Marksman124/inverjet/inverjet_app/readme.txt

config：

Run #1：

fromelf --bin --output=.\output\inverjet_app.bin .\output\inverjet_app.axf

Run #2：
.\after_build_script.bat "$J\..\bin" "#L" "$L@L.bin"

script：

Run #1：
fromelf --bin --output=.\output\inverjet_app.bin .\output\inverjet_app.axf

Run #2：
..\Tools\after_build_script.exe
