Marksman124/inverjet/芯片选型/readme.txt

1系列

STM32L151RCT6  ： 12~13 元

4系列

STM32L451RCT6：	51

STM32L431RCT6：	7~8 		不建议
