Marksman124/inverjet/芯片选型/芯片比较.docx

芯片 | 运行 | 待机 waitup | 睡眠
L151RCT6 | 14 mA | 1.15 uA | 1 mA
F103RCT6 | 31 mA | 43 uA | A

电源箱预留标准蓝牙接口

规格书 保护值，参数。。。
