Marksman124/inverjet/inverjet_boot/readme.txt

config：

Run #1：

fromelf --bin --output=.\Output\inverjet_boot.bin .\inverjet_boot\inverjet_boot.axf

Run #2：
fromelf --bin --output=..\..\inverjet_app\Bin\inverjet_boot.bin .\inverjet_boot\inverjet_boot.axf
