Marksman124/inverjet/tools/蓝牙模块/readme.txt

config：

Run #1：

fromelf --bin --output=.\iUpstream_app\iUpstream_app.bin .\iUpstream_app\iUpstream_app.axf

Run #2：
.\after_build_script.bat "$J\..\bin" "#L" "$L@L.bin"
