Marksman124/inverjet/inverjet_app/Core/fyld_mcu_sdk/VERSION.md

**-----------------------------------Revised Version---------------------------------------
此文件用户无需关心（Users of this file do not need to care）

** 版  本: v1.0.0
** 日　期: 2022年12月1日
** 修改人员: 叶炳文
** 协议版本: v1.0.0
** 描　  述: 初版

**
**-----------------------------------------------------------------------------
******************************************************************************/
