Marksman124/inverjet/规格书/新逆流器规格书_v1.1_20240620.docx

逆流器软件规格书

V1.1版本

# 产品名称：逆流游泳训练器

# 产品型号：

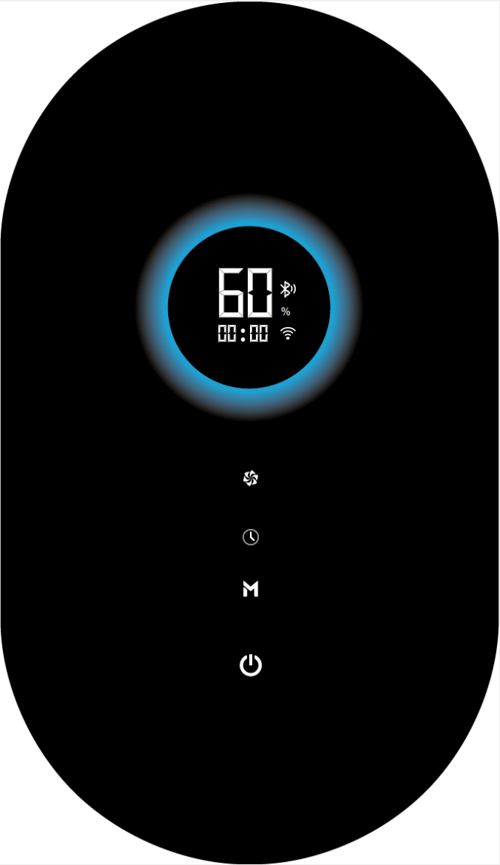
[picture p84: figure]

## 修订记录

版本 | 修改日期 | 修改人 | 修改原因
V1.0 | 2024-05-27 | 吴庆光 | 编制规格书
V1.1 | 2024-06-18 | 吴庆光 | 1.增加故障检测及代码 2.界面添加蓝牙图标
V1.1 | 2024-07-10 | 吴庆光 | 1.故障检测项目调整

目录

# 1 产品描述

泳池逆流训练器软件是一款专为用户提供泳池逆流训练辅助的实用工具。通过该软件，用户可以更加方便地进行泳池逆流训练，提升身体素质和游泳技能。产品特色：

1 本产品提供自由模式，定时模式满足大部分用户日常使用需求，还有3种训练模式针对专业性强的用户定制个人训练计划。
2 功能界面简洁，操作简单，日常使用场景基本可一键完成启动完；
3 配合远程遥控器能满足更多使用场景，用户一个人也可在游泳的途中进行操作，无需特意走到设备面前。

## 1.1 适用环境

环境温度： -10℃~42℃

运行水温: 5℃~40℃

湿度：(45~90)% RH，无结露

海拔：不超过1000m

室内或室外使用，壁挂式安装，出厂时配置壁挂螺丝与必要安装配件。

## 1.2 外形及重量

## 1.3 技术规格

### 1.3.1 规格

电源：单相输入，额定 220V~240V，允许电压 176V~264V，50Hz ±5%；

逆流器：额定功率 1.5kW，

调速范围：20%~100%, 对应转速为400rpm~2100rpm

对应流速： 400rpm→约1m/s, 2100rpm→约4.5m/s

### 1.3.2 输入输出端子

外部通讯控制，端口为A、B。外部控制通过连接A、B通讯线，经Modbus485通讯协议控制水泵转速

### 1.3.3 保护

具有常见保护功能，避雷，防浪涌。

### 1.3.4 报警

具有常见报警屏显功能，如电压异常、过流、过热、输出电流不平衡等。

### 1.3.5 高温降速

高温预警状态：当模块温度达到高温预警触发阀值（80摄氏度）时，进入高温预警状态；进入高温预警状态后自动降低输出转速，以维持电源箱内部温度在80度左右，温度越高降低比例越大，当温度达到高温警报触发阈值（100度）时将关闭电机，在温度降至低于高温预警触发阀值（80摄氏度）时，高温预警状态解除。

### 1.3.6 产品认证

CE认证（LVD+EMC）

# 2 产品展示

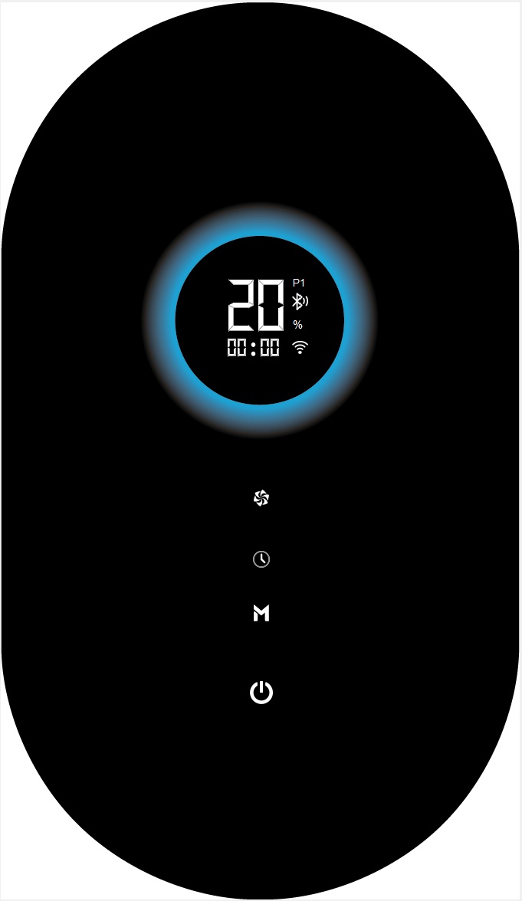
[picture p85: figure]

## 2.1 模式说明

模式类型 | 模式类型说明
自由模式 | 自由调节泳速强度，得到不同的水流速度，可在不定时间内固定流速畅游
定时模式 | 自由调节游泳时间与泳速强度，可在预设目标时间内畅游
预设训练模式 | 根据训练计划在不同时间运行指定流速,达到训练效果

## 2.2 控制及显示参数

设置/显示区 | 参数项 | | 描述
| 泳速强度 | 设定范围 | 20%~100%,五档:20,40,60,80,100
| | 显示精度 | 1%
| | 修改步长 | 20%
| 定时模式:游泳时间 | 设定范围 | 默认30min,六档:15~90min
| | 显示精度 | 00：01
| | 修改步长 | 每档15分钟
| 预设训练计划 | 显示范围 | P1~P3()
| Wifi图标 | | 无配置网络: 熄灭 开始配网:缓慢闪烁（2.5s亮，2.5s灭） 成功联网: 常亮 联网失败: 快速闪烁（1s亮，1s灭）
| 蓝牙图标 | | 无配对蓝牙: 熄灭 开始配对:缓慢闪烁（2.5s亮，2.5s灭） 配对成功: 常亮 配对失败: 快速闪烁（1s亮，1s灭）

## 2.3 按键功能

名称 | 用途 | 描述
开/关机键 | 1、开机 | 开机：关机时短按开关键开机，默认进入自由模式初始状态，若此前使用过则使用记忆流速强度，电机在1分钟内软启动完成
| 2、关机 | 长按3秒进入关机状态，保存记忆泳速并熄灭屏幕。
| 3、暂停 | 运行时短按进入暂停状态，泳速降至0%，并可切换模式。暂停状态下若无操作30分钟，自动关机。
| 4、恢复 | 暂停状态下短按重新恢复暂停前状态，30秒内软启动。
训练模式键 | 1、切换模式 | 点击模式键切换至训练模式参数选择状态，电机降至20%。可选择P1,P2,P3或自由模式（自由模式不显示模式P）。切换后3秒无操作进入软启动。
定时键 | 1、切换模式 | 切换模式：点击定时模式键切换至定时模式，电机降至20%。默认显示30:00 60%。
| 2、调整参数 | 调整时间：短按定时键修改时间，每次递增一个档，一档15min。一共有六档：15min，30min，45min，60min，75min , 90min。
流速档位键 | 1、调整流速（自由，时间模式运行时） | 在自由模式或定时模式下，短按流速档位键增加流速，速度在3秒后直接增加到最后一次点击的档位。每次短按增加20%（60%，80%，100%，20%，40%）
| 2、调整流速（预设训练模式运行时） | 训练模式：在训练模式运行状态下，可在当前分钟内调整流速，流速在3秒后实时增加到点击的档位。
| 3、调整流速（自由模式、定时模式设置时调整速度） | 流速档位键可以在定时模式设置和自由模式初始状态设置时调整速度

## 2.4 操作流程

### 2.4.1 开机 & 关机

1) 开机：上电完成后，点击开机键开机，开机后系统默认进入自由模式初始状态： 流速60%；

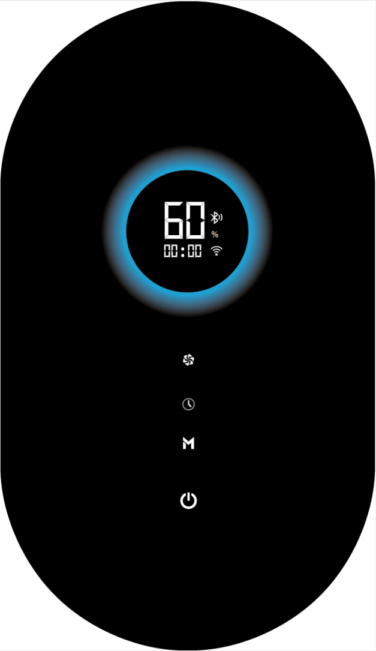
[picture p86: figure]

2) 关机：
1 任意模式下长按开机键 3秒系统进入关机状态，关机状态下仅开机键可操作，其它按键均无效；
2 暂停状态下连续30分钟内无操作，系统将自动关机；

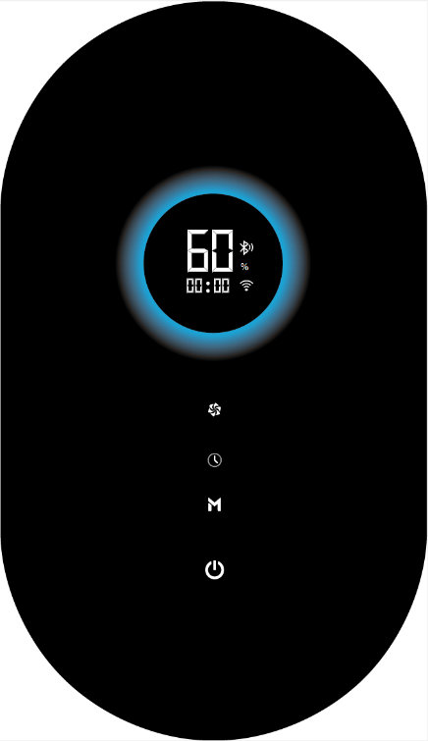
[picture p87: figure]

### 2.4.2 暂停 & 恢复

1) 暂停：系统在运行状态或设置状态下，短按开机键进入暂停状态，暂停状态下流速降至0%，时间暂停，LED状态灯以5秒一个周期完成闪烁；暂停状态下30分钟内无操作，系统将自动关机。


LED灯闪烁

电机停止

2) 恢复：暂停状态下短按开机键恢复暂停前状态继续运行，如果在暂停时切换模式，会导致运行状态重置，那此时恢复后系统将重新开始运行。暂停时无法更改流速。


暂停时点击定时键

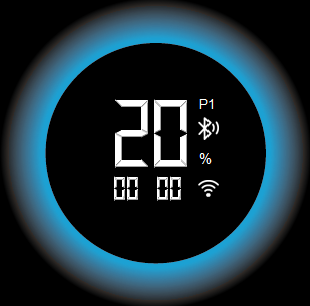
[picture p88: figure]

暂停时点击训练模式键

注意：进行模式切换后，暂停前运行状态将被重置。

### 2.4.3 运行自由模式

开机后默认进入自由模式初始状态，默认流速60%；3秒内无操作系统自动运行自由模式，或者短按开机键立即运行；流速下方显示已运行时间：

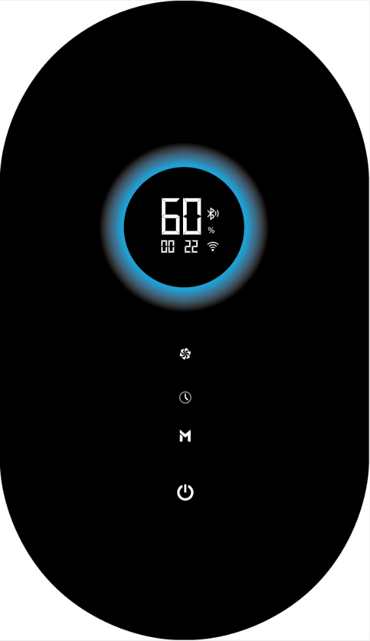
[picture p89: figure]

### 2.4.4 更改自由模式流速

在自由模式初始状态或者运行状态下，点击流速档位键即可更改流速，每次点击切换一档，共有五个档位：20%、40%、60%、80%、100%依次切换；

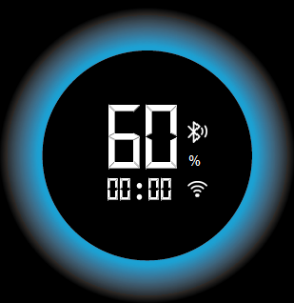
[picture p90: figure]
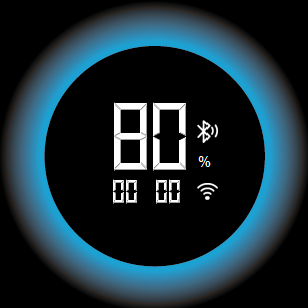
[picture p91: figure]
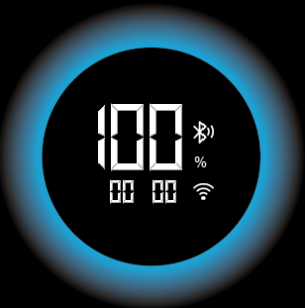
[picture p92: figure]
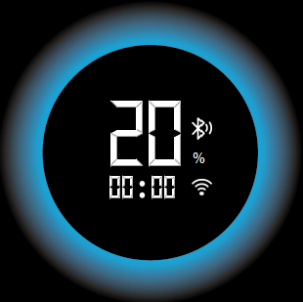
[picture p93: figure]
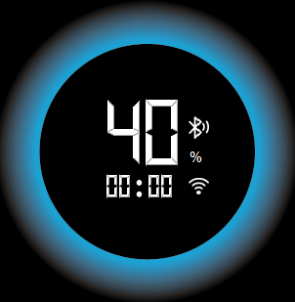
[picture p94: figure]

选择完成后等待3秒无操作后，流速将调整至最后设置的档位流速。

### 2.4.5 运行定时模式

在任意状态下点击定时键，系统进入定时模式设置状态，在该状态下3秒内无操作将开启定时模式，或者点击开机键立即运行；流速下方显示定时时间，开始运行后进入倒数，当数到0时定时运行结束，运行结束后将闪烁显示定时模式的运行时间和流速，3秒后系统切换到自由模式初始状态，想再次运行定时模式需重复2.4.4操作：


定时模式设置状态 运行中。。 运行结束

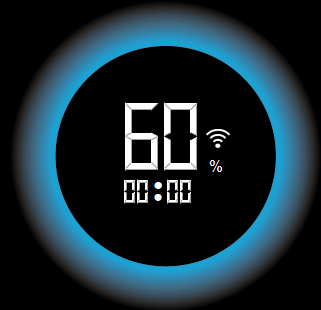
[picture p95: figure]

3秒

结束后显示运行流速和时间 闪烁显示 3秒后切换到自由模式初始状态

### 2.4.6 定时模式下更改流速

在定时模式下（运行中或者未运行均可直接修改流速），点击流速档位键即可更改流速，每次点击切换一档，共有五个档位：20%、40%、60%、80%、100%依次切换；该修改仅本次有效，运行结束后流速将恢复60%（即下次开启定时模式默认流速依然是60%），如需修改请按2.4.5再次操作；

未运行：


运行中：更改流速过程中系统将持续运行，设置好目标流速后保持3秒内无操作，系统将以最后设定的流速运行，期间计时器不会暂停；


### 2.4.7 更改定时时间

更改定时时间需要在定时模式设状态下才能设定，具体操作如下：

1 非定时模式设置状态时（定时模式运行状态或其它模式），点击定时键可切换至定时模式设置状态；
2 在定时模式设置状态下，点击定时键即可更改时间，每次点击切换一档，共有五个档位：15min、30min、45min、60min、90min依次切换；设置好目标时间后保持3秒内无操作，系统将以最后设定的时间重新开始定时模式；


### 2.4.8 切换训练模式

系统存有3种训练模式（P1,P2,P3），训练模式实际上是多段定时连在一起，通过不同的流速配置指定更专业的训练计划，具体可分为12个段速，具体段速的参数需要在app中进行设置，默认为

P1:

时间 | 0-2min | 2-4min | 4-6min | 6-8min | 8-10min | 10-12min | 12-14min
流速 | 20% | 40% | 60% | 80% | 60% | 40% | 60%

P2:

时间 | 0-2min | 2-4min | 4-6min | 6-8min | 8-10min | 10-12min | 12-14min
流速 | 20% | 40% | 60% | 80% | 60% | 40% | 60%

P3：

时间 | 0-2min | 2-4min | 4-6min | 6-8min | 8-10min | 10-12min | 12-14min
流速 | 20% | 40% | 60% | 80% | 60% | 40% | 60%

在面板和遥控器可进行训练模式切换，具体操作如下：在任意模式下点击训练模式键即可切换训练模式，每次点击切换一种模式，共有四个模式：P1,P2,P3，自由模式 依次切换（当切到自由模式时界面“Pn”模式图标熄灭）；切换到目标模式后保持3秒内无操作，系统将开启该模式运行；

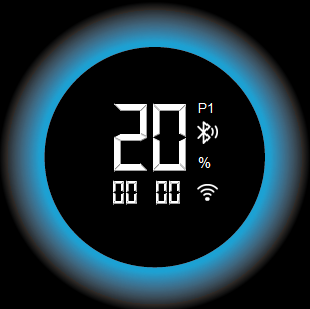
[picture p96: figure]
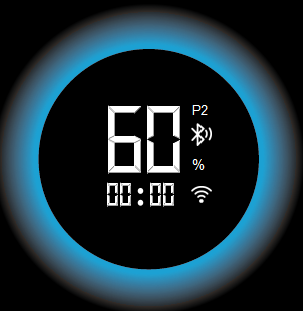
[picture p97: figure]
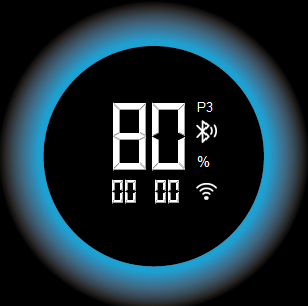
[picture p98: figure]

### 2.4.9 训练模式下更改流速

训练模式下更改流速与其它模式下操作相同，可查看2.4.5操作流程：

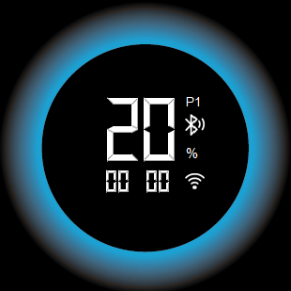
[picture p99: figure]
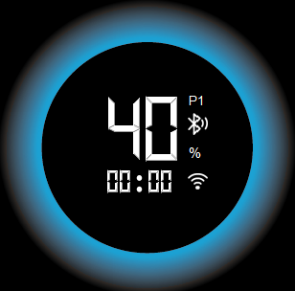
[picture p100: figure]
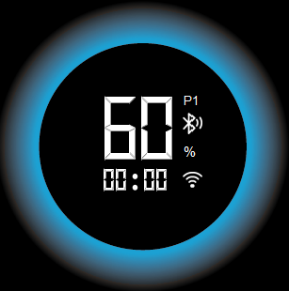
[picture p101: figure]
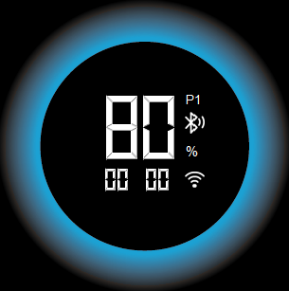
[picture p102: figure]
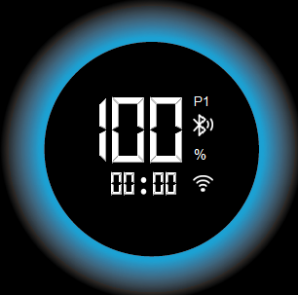
[picture p103: figure]

在训练模式开启运行后也可更改流速，更改流速过程中系统将持续运行，设置好目标流速后保持3秒内无操作，系统将以最后设定的流速运行当前时间段，期间计时器不会暂停；当训练时间进入下一时间段时将使用默认流速（即更改流速仅当前段速有效）：

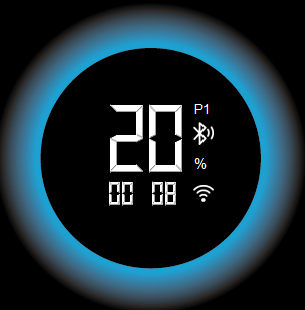
[picture p104: figure]
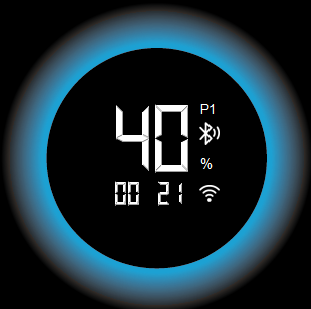
[picture p105: figure]
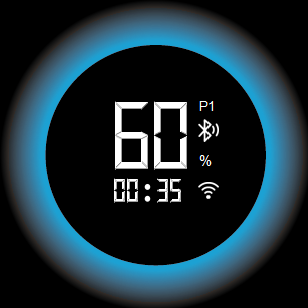
[picture p106: figure]
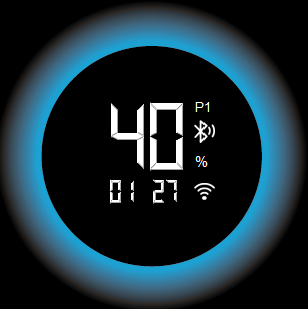
[picture p107: figure]

下一阶段恢复计划流速

流速调至60%

### 2.4.10 Wifi联网和蓝牙遥控器配对

  1 Wifi联网：停机状态下（系统开机 & 电机未开启）同时按 键并保持3秒，进入Wifi配网模式，此时图标开始缓慢闪烁（5秒一个闪烁周期），通过手机app进行配网操作（详情查看app操作说明），配网成功后图标常亮，如3分钟内没有完成配网，则熄灭需重新操作进入配网模式；

完成配网后，下次开机会自动连接网络，连接成功则常亮，若连接失败或连接上却无法上网则进入故障状态开始快速闪烁（2秒一个闪烁周期）。出现故障状态请排查网络或根据app操作说明进行排查，如果原wifi热点失效可重新进行配网操作；

  2 蓝牙遥控器配对：停机状态下（系统开机 & 电机未开启）同时按 键并保持3秒，进入Wifi配网模式，此时图标开始缓慢闪烁（5秒一个闪烁周期），通过逆流器专门的遥控器进行配网操作（详情查看遥控器操作说明），配对成功后图标常亮，如3分钟内没有完成配对，则熄灭需重新操作进入配对模式；

完成蓝牙配对后，下次开机会自动连接蓝牙遥控器，连接成功则常亮，若连接失败则进入故障状态开始快速闪烁（2秒一个闪烁周期）。出现故障状态请检查遥控器是否故障，如果原遥控器损坏可重复上述操作重新配对新遥控器；

### 2.4.11 其它操作说明

1 关机状态下，同时按 键并保持3秒恢复出厂设置。
2 关机状态下，同时按 键并保持3秒，进入参数设置菜单。每次均从第1项开始显示，按键切换设置项目；1分钟无操作或按键退出参数设置；

具体可设项目请看下方表格；通过 跳转进行参数设置，按参数值+1，长按超过1秒可快速连续增加，按参数值-1，长按超过1秒可快速连续减少；

在位置显示代码值：1、2、3…

在位置显示设置值。

参数 | 默认值 | 代码 | 设置范围

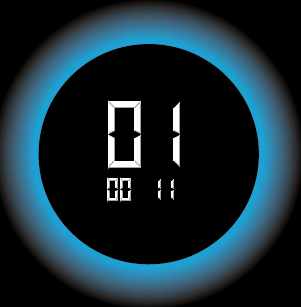
[picture p108: figure]

节点地址 | 11 | 1 | 1~254 | 长按可快速调节

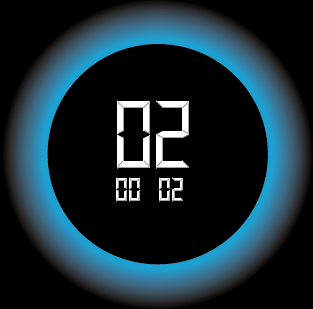
[picture p109: figure]

波特率 | 2 | 2 | 0:2400; 1:4800; 2:9600; 3:19200; 4:115200

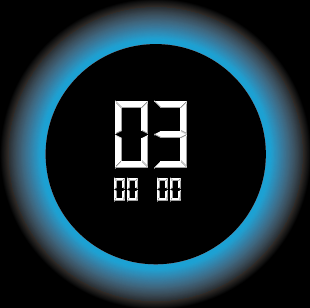
[picture p110: figure]

屏蔽外部控制方式 | 0 | 3 | 0：全可控 1：遥控器无效 2：485无效 3：遥控与485无效 4：wifi无效 5：遥控与wifi无效 6：485与wifi无效 7：遥控，485，wifi无效

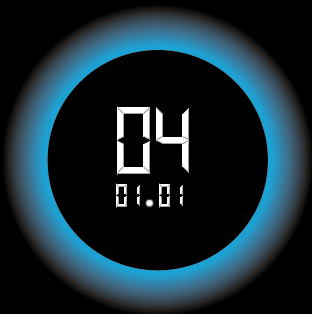
[picture p111: figure]

显示板软件版本 | 不可修改 | 4 | 版本号 V xx.xx 如 v 1.1显示如图


驱动板软件版本 | 不可修改 | 5 | 版本号 V xx.xx 如 v 1.0显示如图

3 运行状态时，液晶屏幕如无按键操作1分钟后亮度降至正常显示的1/2，任意按键均唤醒屏幕。此情况下，即使按电源开关按键，亦默认为唤醒屏幕而非关机。

# 3 故障检测及代码

逆流器检测到故障时（降速策略除外），停机并显示故障代码。停机15秒后，判断故障是否清除，如果满足，则恢复启动。出现多个故障时用户可按通过 键切换故障查看；同时按住 键3秒进行复位。

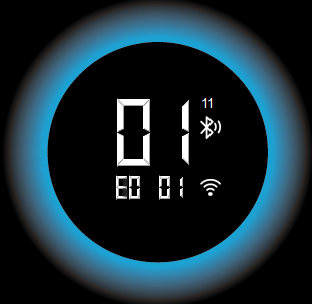
[picture p112: figure]

为故障总数, 为当前故障编号, 为故障代码。

1) 输出电流超过限值

进入条件：逆流器电流峰值大于预设电流。

退出条件：停机15秒后启动，如连续出现3次，则需断电重启。

2) 输出电压不平衡

进入条件：逆流器输出三相电流出现漏项，错项，缺项等。

退出条件：停机15秒后启动，如连续出现3次，则需断电重启。

3) 电源箱过热

进入条件：电源箱内部温度大于预设温度值。

退出条件：停机15秒后启动，如连续出现3次，则需断电重启。

4) 电机故障

进入条件：驱动板损坏或电机控制异常。

退出条件：排查故障后，需断电重启。

5) 驱动EEPROM读写故障

进入条件：读写驱动EEPROM数据校验错误。

退出条件：需断电重启。

6) 驱动板通信故障

进入条件：驱动板与主控制连续15sec通信不上。

退出条件：驱动板与主控制连续1秒通讯成功。

7) WIF模组故障

进入条件：WIFI模组损坏。

退出条件：需断电重启。

8) 蓝牙模组故障

进入条件：蓝牙模组损坏。

退出条件：需断电重启

故障码代号如下：

序号 | 故障代码 | 故障描述 | 是否为自身故障 | 是否可自动恢复 | 界面演示
1 | E001 | 输出电流超过限值 | 否 | 1小时内连续报超过3次将锁住，需要手动复位。

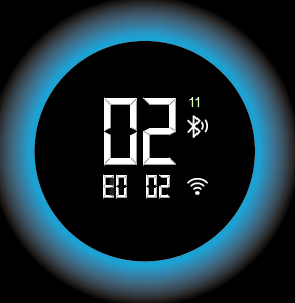
[picture p113: figure]

2 | E002 | 输出电压不平衡 | 可能 | 3次后不可以。需要断电重启

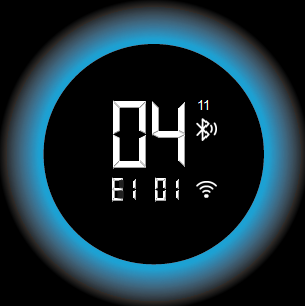
[picture p114: figure]

3 | E101 | 电源箱过热 | 可能 | 3次后不可以。需要断电重启

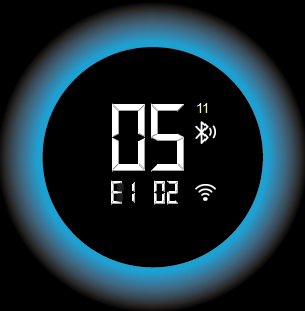
[picture p115: figure]

4 | E102 | 电机故障 | 可能 | 3次后不可以。需要断电重启

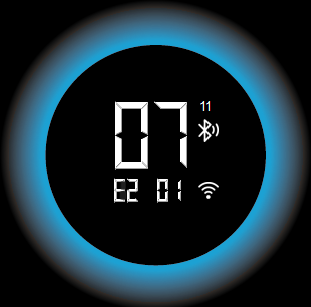
[picture p116: figure]

5 | E201 | 驱动板通信故障 | 是 | 否

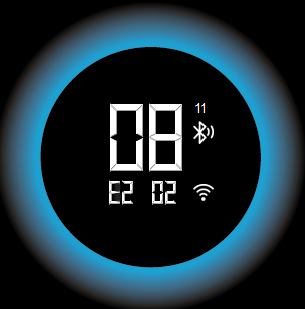
[picture p117: figure]

6 | E202 | 驱动板通信故障 | 是 | 否

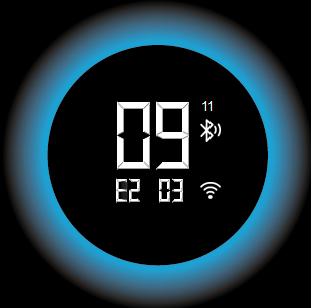
[picture p118: figure]

7 | E203 | wifi故障 | 是 | 否

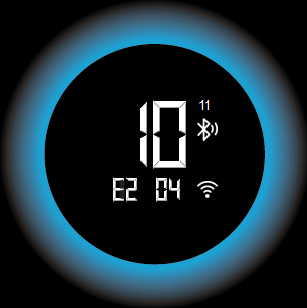
[picture p119: figure]

8 | E204 | 蓝牙遥控故障 | 是 | 否
12 | AL01 | 高温预警降档运行 | 可能 | 是
