Marksman124/inverjet/计划书/电源箱详细逻辑20240516V1.1(1).pdf

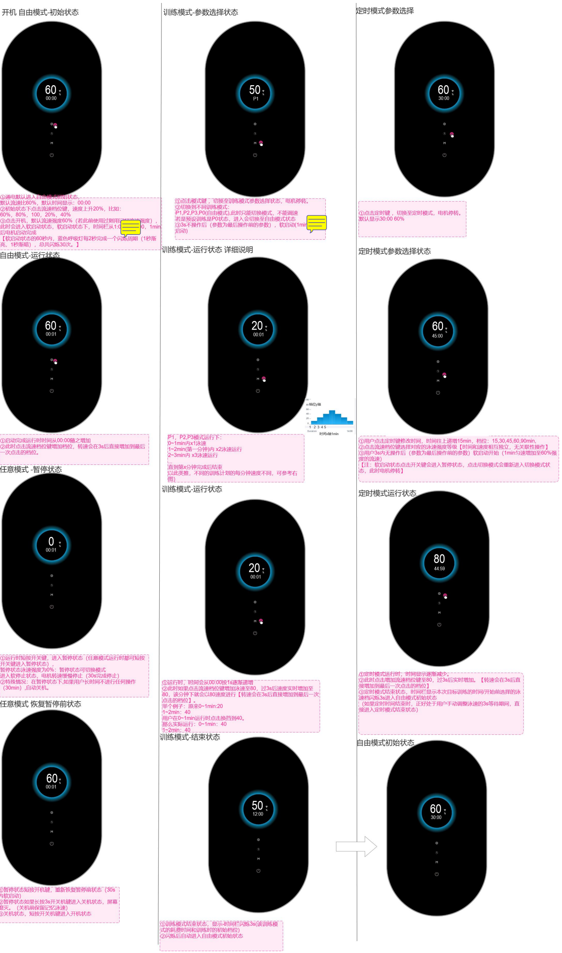
[picture p214: page 1]

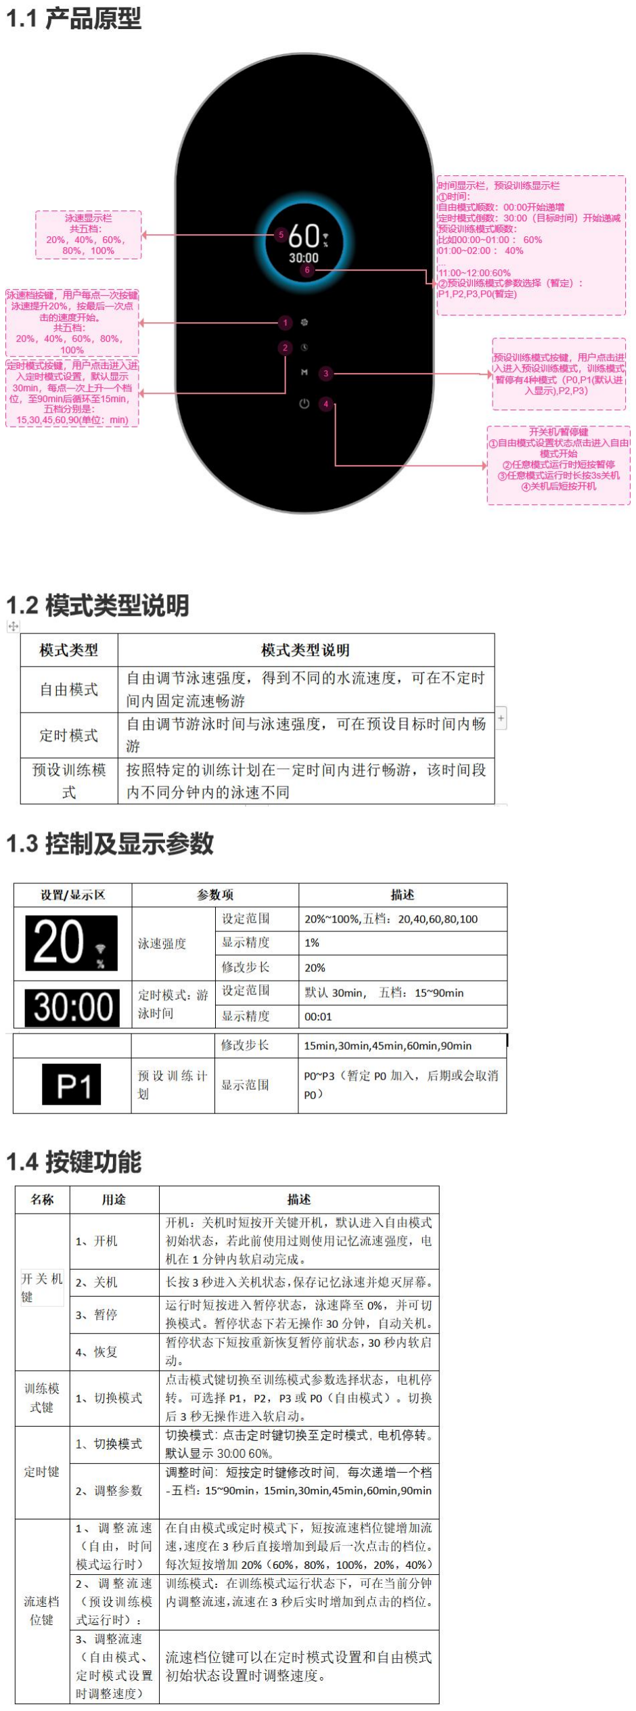
[picture p215: figure]
