Marksman124/inverjet/协议/逆流器软件功能测试报告V1.6.xlsx

Sheet: 测试问题
逆流器控制板测试问题
序号 | 问题 | 时间 | 情况记录 | 恢复情况 | 原因 | 解决方案 | 备注
20 | Modbus-485通讯测试时，模式显示混乱 | 2022-06-14 | 开机后，通讯修改F0-02（1->0）、F0-03（->1/2）时，模式显示混乱 |  | 控制模式的信号源未统一（F0-03的值与F0-02冲突） |  | 已解决
33 | 恢复出厂设置 | 2022-12-07 | FF-06、FP-02 恢复出厂设置后的值与出厂值不一致 |  | FP-02无需改 |  | 已解决
34 | F7-11设为100时，参数无法确定 | 2022-12-30 | F7-11设为100时，点击ENTER键开机关机 且参数修改后按ENTER键确认 ，参数无法确定 | F7-11设为110后，恢复正常 | 点击ENTER键功能混乱，可以开关机就无法确认参数 |  | 已解决
35 | FP-00设为1后，输入密码无法确认，无法查看参数 | 2023-01-02 | FP-00设为1,F7-11设为0时，点击ENTER键，无法确认密码，无法查看或修改参数菜单 |  |  |  | 已解决
36 | 自定义模式与畅游模式显示混乱 | 2023-01-10 | 手动将F0-01的值由3（自定义模式）改为0（畅游模式）后，模式图标显示畅游，但仍显示自定义模式下的距离及级数 | 手动按下模式键，显示自定义模式图标，再按模式键改为畅游模式后，显示正常 | 参数已修改，需要刷新 |  | 已解决
37 | 外部接入图标不亮 | 2023-01-12 | 由面板控制改为通信控制后，外部接入图标不亮 | 掉电并重新上电后，外部接入图标亮起 | 参数已修改，需要刷新 |  | 已解决
38 | 掉电存储（掉电不记忆） | 2023-02-08 | 按键修改模式、转速、时间、距离后，掉电未记忆 | V2.06.2版本正常 |  |  | 已解决
39 | 蜂鸣器不断响 | 2023-02-08 |  | 松开按键后，按下确认键，蜂鸣器停止响
40 | 掉电后开机，485测试时模式显示混乱 | 2023-02-09 |  | 先停机，然后通信修改模式、时间或距离，再开机，显示正常
41 | 恢复出厂值后，未掉电保存，直接开机，模式显示混乱 | 2023-02-13 | （1）面板控制：距离模式，显示距离图标、0.50km； （2）恢复出厂值：通过按键将 FP-01 的值修改为 1， 显示距离图标、0.50km； （3）按键开机：显示畅游图标、0.01km | 掉电并重新上电后，正常显示畅游模式 | 恢复出厂值后，未掉电保存 | 恢复出厂值后，需掉电保存 | 此为操作失误，无需改

Sheet: 功能测试
 |  |  |  |  | 广州安捷制造有限公司
 |  |  |  |  | 软件功能测试报告书
 |  |  |  |  |  |  |  | 表单编号：
 |  |  |  |  |  |  |  | 生效日期：
项目编号 |  |  |  |  | 项目名称 | 逆流器 |  | 文件编号： | V1.6
软件编号 |  |  | V2.01 | V2.06.3 | 产品型号 |  |  | 日期： | 2023-02-14
控制方式 | No | 测试项 | 测试内容 |  | 判断方法 | 不符合现象 | 检讨意见 | 判定 | 措施事项
LCD显示 面板控制 | 1 | 上电检测 | 上电瞬间状态 |  | 1、接通电源后，4个按键指示灯常亮，伴随背光板亮起； |  |  | PASS
 |  |  |  |  | 2、设备就绪过程中，水流速度显示区：数字00跑马灯效果。 |  |  | PASS
 |  |  | 上电完成后状态 |  | 等待 7s（默认）设备就绪后，蜂鸣器长鸣一声，LCD显示用户模式： |  |  | PASS
 |  |  |  |  | 1. 初次上电，LCD显示的都是默认值； |  |  | PASS
 |  |  |  |  | 2. 上次断电前为正常工作状态，则LCD显示恢复至断电前的状态。 |  |  | PASS
 | 2 | LCD与按键 | LCD显示测试 |  | 设备就绪过程中，长按模式键 3s，蜂鸣器短鸣一声，LCD显示： | 2.3s | 未定，可忽略
 |  |  |  |  | 1、所有图标从上到下、从左到右逐一显示； |  |  | PASS
 |  |  |  |  | 2、所有七段式液晶同时按 0 - 9 的顺序依次更新显示； |  |  | PASS
 |  |  |  |  | 3、屏幕全亮，显示所有段码。 |  |  | PASS
 |  |  | 按键与LCD显示 |  | 4、LCD上最右边的七段式液晶显示：0 ； |  |  | PASS
 |  |  |  |  | 5、从右到左逐一点击按键，最右边的七段式液晶分别显示：1 - 4。 |  |  | PASS
 |  |  | 按键与蜂鸣器、指示灯 |  | 1. 点击一次按键，按键对应的指示灯亮，蜂鸣器发出 1声“滴”； |  |  | PASS
 |  |  |  |  | 2. 长按模式键或确认键 3s，按键对应的指示灯亮，蜂鸣器短鸣 1声； | 2.7s | 未定，可忽略
 |  |  |  |  | 3、长按模式键和确认键 5s，按键对应的指示灯亮，蜂鸣器长鸣 1声。 | 5.6s | 未定，可忽略
 | 3 | 锁屏与解锁 | 锁屏 |  | 亮屏时，无任何操作下，倒计时 30s（默认）后： |  |  | PASS
 |  |  |  |  | LCD自动锁屏，屏幕完全熄灭。 |  |  | PASS
 |  |  | 解锁 |  | 锁屏时，长按模式键 3s 解锁后： | 2.4s | 未定，可忽略
 |  |  |  |  | LCD屏幕亮起，默认显示锁屏前的状态。 |  |  | PASS
 | 4 | 切换控制模式 | 按键操作与LCD显示 |  | 1、亮屏时，长按模式键 3s，当前模式图标闪烁； | 2.5s | 未定，可忽略
 |  |  |  |  | 2、点击上键（或下键）及确认键，选择切换到其他模式； |  |  | PASS
 |  |  |  |  | 3、可切换的模式：畅游 - 定时 - 距离 - 自定义模式（含娱乐模式、普通自定义模式）。 |  |  | PASS
 | 5 | 修改转速 | 按键修改与LCD显示 |  | 1. 亮屏时，点击上键或下键，转速值的个位闪烁； |  |  | PASS
 |  |  |  |  | 2. 点击上键（或下键）及确认键，修改为其他转速； |  |  | PASS
 |  |  |  |  | 3. 转速可修改范围：20%（默认） - 100%。 |  |  | PASS
 | 6 | 掉电存储 | 按键修改与LCD显示 |  | 1、上电后，修改转速、模式、定时时间、运行距离； |  |  | PASS
 |  |  |  |  | 2、断电再上电后，LCD显示修改后的值。 |  |  | PASS
 | 7 | 开关机 | 开机 | 设置开机 | 上电等待设备就绪后，长按确认键 3s 开机，LCD显示： | 2s | 未定，可忽略
 |  |  |  |  | 开机图标被点亮，逆流器以当前模式运行。 |  |  | PASS
 |  |  |  | 开机动效 | 开机后，LCD显示： |  |  | PASS
 |  |  |  |  | 1. 转速值在 20s（默认）的时间内从 0% 逐步攀升至 100% ； |  |  | PASS
 |  |  |  |  | 2. 出水流速从 0.0m/s 匀速攀升，升至给定值（默认 5.0m/s）。 |  |  | PASS
 |  |  | 关机 | 设置关机 | 开机后，长按确认键 3s 关机，LCD显示： | 2.4s | 未定，可忽略
 |  |  |  |  | 开机图标熄灭，逆流器停止运行。 |  |  | PASS
 |  |  |  | 关机动效 | A、停机方式为减速停机时, 关机后： |  |  | PASS
 |  |  |  |  | 1. 转速从当前值匀速递减，开机图标熄灭后，显示设定值； |  |  | PASS
 |  |  |  |  | 2. 出水流速从当前值匀速递减，直到降为 0m/s。 |  |  | PASS
 |  |  |  |  | B、停机方式为自由停机时，关机后： |  |  | PASS
 |  |  |  |  | 1. LCD显示设定转速； |  |  | PASS
 |  |  |  |  | 2. 出水流速立即变为 0m/s。 |  |  | PASS
 | 8 | 复位 | 故障复位 |  | 出现故障后，长按确认键，蜂鸣器响2次复位： |  |  | PASS
 |  |  |  |  | LCD显示出故障前的状态。 |  |  | PASS
 | 9 | 畅游模式 | 转速显示 |  | 1、转速以百分比形式 xxx% 显示，设定值：下限值（默认20%）-100%； |  |  | PASS
 |  |  |  |  | 2、初始化后，转速恢复默认值 30%。 |  |  | PASS
 |  |  | 出水流速显示 |  | 3、出水流速以 x.xm/s 的形式显示； |  |  | PASS
 |  |  |  |  | 4、出水流速正比于转速（转速100% —— 出水流速5.0m/s）。 |  |  | PASS
 | 10 | 定时模式 | 修改定时时间 | 本区移位 | 定时模式下，停机时： |  |  | PASS
 |  |  |  |  | 1. 点按上键（或下键），转速个位闪烁； |  |  | PASS
 |  |  |  |  | 2. 点击确认键，时间个位闪烁； |  |  | PASS
 |  |  |  |  | 3. 点击上键（或下键）及确认键，修改为其他定时； |  |  | PASS
 |  |  |  |  | 4. 时间可调整范围：1 - 99min。 |  |  | PASS
 |  |  |  | 跨区移位 | 定时模式下，停机时： |  |  | PASS
 |  |  |  |  | 1、点按上键（或下键），转速个位闪烁； |  |  | PASS
 |  |  |  |  | 2、点击模式键 2次，时间个位闪烁； |  |  | PASS
 |  |  |  |  | 3、点击上键（或下键）及确认键，修改为其他定时； |  |  | PASS
 |  |  |  |  | 4、时间可调整范围：1 - 99min。 |  |  | PASS
 |  |  | 定时功能 |  | 定时模式下，开机后，秒表倒计的定时时间到达后： |  |  | PASS
 |  |  |  |  | 1. 开机图标熄灭，LCD显示设定转速、设定时间； |  |  | PASS
 |  |  |  |  | 2. 出水流速立即变为 0m/s。 |  |  | PASS
 | 11 | 距离模式 | 修改运行距离 | 本区移位 | 距离模式下，停机时： |  |  | PASS
 |  |  |  |  | 1、点按上键（或下键），转速个位闪烁； |  |  | PASS
 |  |  |  |  | 2、点击确认键，距离最低位闪烁； |  |  | PASS
 |  |  |  |  | 3、点击上键（或下键）及确认键，修改为其他距离； |  |  | PASS
 |  |  |  |  | 4、距离可调整范围：00.01 - 99.99km。 |  |  | PASS
 |  |  |  | 跨区移位 | 距离模式下，停机时： |  |  | PASS
 |  |  |  |  | 1. 点按上键（或下键），转速个位闪烁； |  |  | PASS
 |  |  |  |  | 2. 点击模式键 2次，距离最低位闪烁； |  |  | PASS
 |  |  |  |  | 3. 点击上键（或下键）及确认键，修改为其他距离； |  |  | PASS
 |  |  |  |  | 4. 距离可调整范围：00.01 - 99.99km。 |  |  | PASS
 |  |  | 距离功能 |  | 距离模式下，开机后，运行距离降为 00.00km 后： |  |  | PASS
 |  |  |  |  | 1、开机图标熄灭，LCD显示设定转速、设定距离； |  |  | PASS
 |  |  |  |  | 2、出水流速立即变为 0m/s。 |  |  | PASS
 | 12 | 自定义模式 | 选择模式 |  | 自定义模式图标闪烁时，点击上键和确认键，可以选择娱乐或普通自定义模式，共10个可选 |  |  | PASS
 |  |  | 娱乐模式 |  | 点击下键及确认键，可选择5段已设置好的转速、时间（需在APP上设置）来运行 | 开机后，定时时间到了未停机，一直循环运行 | 修改F0-19、F0-20的默认值
 |  |  | 普通自定义模式 |  | 点击下键及确认键，可选择5段已设置好的转速、距离（需在APP上设置）来运行 | 开机后，运行距离到了未停机，一直循环运行
 | 13 | 参数菜单 | 切换菜单 |  | 1、同时长按模式键和确认键 5s，进入参数菜单模式； | 5s | 未定，可忽略
 |  |  |  |  | 2、再次同时长按模式键和确认键 5s，返回用户菜单模式。 | 5s | 未定，可忽略
 |  |  | LCD显示 | 有密码 | 1. 进入参数菜单模式后，LCD显示： |  |  | PASS
 |  |  |  |  | 2. 点击模式键，LCD显示： |  |  | PASS
 |  |  |  | 无密码 | 无密码或成功输入密码后，LCD显示： |  |  | PASS
 |  |  | 查看参数 |  | 1、双击模式键，LCD显示参数组F0； |  |  | PASS
 |  |  |  |  | 2、单击确认键，进入该组参数，如F0-00； |  |  | PASS
 |  |  |  |  | 3、再次单击确认键，查看该组参数值； |  |  | PASS
 |  |  |  |  | 注：只读参数不可修改，只能查看。 |  |  | PASS
 |  |  | 修改参数 |  | 4、点击上键或下键，修改该参数； |  |  | PASS
 |  |  |  |  | 5、再点击确认键确定该参数。 |  |  | PASS
 |  |  |  |  | 注：（1）修改参数需要先将FP-04设为0； |  |  | PASS
 |  |  |  |  | （2）修改FF组参数需要先在FF-00中输入厂家密码。 |  |  | PASS
 |  |  | 参数初始化 |  | 将参数 FP-01 的值设置为1后，LCD显示： |  |  | PASS
 |  |  |  |  | 除 只读参数 与 FF组参数 外，其他参数都恢复了出厂值。 |  |  | PASS
 |  |  |  |  | 注：（1）只读参数的出厂值无效； （见附表参数初始化） |  |  | PASS
 |  |  |  |  | （2） FF组参数为固定参数，初始化后仍为修改值。 |  |  | PASS
 |  |  | 修改参数后掉电存储 |  | 修改参数后，断电再重新上电，参数显示为修改后的值。
 |  |  | 参数初始化后掉电存储 |  | 参数初始化后，断电再重新上电，参数恢复为出厂值。
 | 14 | UART通信 | 控制板与驱动板通信 |  | 1. 发送数据帧无异常； |  |  | PASS
 |  |  |  |  | 2. 接收数据帧无异常； |  |  | PASS
 |  |  |  |  | 3. LCD显示正常，未出现故障报错。 （见附表UART通信） |  |  | PASS
 | 15 | 故障功能 | 驱动故障 |  | 1、发送数据帧无异常； |  |  | PASS
 |  |  |  |  | 2、接收数据帧无异常； （见附表故障功能） |  |  | PASS
 |  |  |  |  | 注： 给出开机命令后LCD显示故障代号,此时电机迅速自由停机。 |  |  | PASS
 |  |  | 控制板与驱动板通信故障 |  | 1. 将lcd板与drive板之间的通讯时间间隔改为500，给出开机命令后LCD显示：
 |  |  |  |  | Err 201（LCD到drive通信故障 -- 通信超时 FB-00、FB-01 确定）；
 |  |  |  |  | 2. 控制板连接驱动板的RXD或TXD线路出现故障时，给出开机命令后LCD显示：
 |  |  |  |  | Err 102（上电电压为0 通信断线故障）
 |  |  |  |  | 注： 给出开机命令后LCD显示故障代号,此时电机迅速自由停机。
 | 16 | 联网 | 进入配网状态 |  | 同时长按模式键和上键 3s，WiFi图标闪烁，可在APP上联网： | <3s | 未定，可忽略 |  | WiFi功能待定义
 |  |  |  |  | 2min（默认）内若联网成功，WiFi图标常亮；否则，WiFi图标熄灭。 |  | 未定，可忽略 |  | WiFi功能待定义
控制方式切换 | 1 | 控制方式切换 | 面板与ModBus通信控制切换 |  | 面板控制且停机时，同时长按模式键与下键 3s，外部接入图标亮起，进入ModBus通信控制状态； | <3s
 |  |  |  |  | ModBus通信控制且停机时，同时长按模式键与下键 3s，外部接入图标熄灭，进入面板控制状态。 | <3s
Modbus 通信控制 | 1 | MODBUS 协议 | 通信数据 | 0x06命令 | 1、发送数据帧与接收数据帧一致； |  |  | PASS
 |  |  |  |  | 2、LCD显示出现变化，或某些参数被修改。 （见附表MODBUS测试） |  |  | PASS
 |  |  |  | 0x03命令 | 1. 发送数据帧与接收数据帧不一致， |  |  | PASS
 |  |  |  |  | 2. 读取到的数据都为设定值； |  |  | PASS
 |  |  |  |  | 3. LCD显示未出现任何变化。 （见附表MODBUS测试） |  |  | PASS
 |  |  |  |  | 注：（1）最大连续读32个，不能跨参数组连读 |  |  | PASS
 |  |  |  |  | （2）连读最大个数为参数组当前可显示的个数 |  |  | PASS
 |  |  |  |  | （3）FP-00、FF-00不能读 |  |  | PASS
 |  |  |  |  | （4）FF组需要发送解锁密码才可以读取 |  |  | PASS
 | 2 | 修改转速 | 通信修改与LCD显示 |  | 1、上电后，用串口调试助手给控制板发送数据帧，修改命令源为通信控制； |  |  | PASS
 |  |  |  |  | 2、用串口调试助手给控制板发送转速命令； |  |  | PASS
 |  |  |  |  | 3、LCD显示修改后的转速。 |  |  | PASS
 | 3 | 切换控制模式 | 通信修改与LCD显示 |  | 1. 上电后，用串口调试助手给控制板发送数据帧，修改命令源为通信控制； |  |  | PASS
 |  |  |  |  | 2. 用串口调试助手给控制板发送控制模式命令； |  |  | PASS
 |  |  |  |  | 3. 开机后，LCD显示切换后的模式图标、转速与出水流速。 |  |  | PASS
 | 4 | 修改定时时间 | 通信修改与LCD显示 |  | 1、上电后，用串口调试助手给控制板发送数据帧，修改命令源为通信控制； |  |  | PASS
 |  |  |  |  | 2、用串口调试助手给控制板发送定时时间命令； |  |  | PASS
 |  |  |  |  | 3、开机后，LCD显示修改后的定时时间。 |  |  | PASS
 | 5 | 修改距离 | 通信修改与LCD显示 |  | 1. 上电后，用串口调试助手给控制板发送数据帧，修改命令源为通信控制； |  |  | PASS
 |  |  |  |  | 2. 用串口调试助手给控制板发送距离命令； |  |  | PASS
 |  |  |  |  | 3. 开机后，LCD显示修改后的距离。 |  |  | PASS
 | 6 | 掉电存储 | 通信修改与LCD显示 |  | 1、 上电后，用串口调试助手给控制板发送数据帧，修改模式、转速、时间、距离；
 |  |  |  |  | 2、断电再上电后，LCD显示修改后的值。 | 掉电后开机，模式显示与时间、距离出现混乱(F0-03:0/1)
 | 7 | 开关机 | 开 机 |  | 1. 上电后，用串口调试助手给控制板发送数据帧，修改命令源为通信控制； |  |  | PASS
 |  |  |  |  | 2. 用串口调试助手给控制板发送开机命令； |  |  | PASS
 |  |  |  |  | 3. LCD显示开机动效。 |  | 将FF-14改回50 | PASS
 |  |  | 关 机 |  | 1、上电后，用串口调试助手给控制板发送数据帧，修改命令源为通信控制； |  |  | PASS
 |  |  |  |  | 2、用串口调试助手给控制板发送关机命令； |  |  | PASS
 |  |  |  |  | 3、LCD显示关机动效。 |  |  | PASS

Sheet: 掉电存储(2.06.3)
参数组 | 参数项 | 参数名称 | 设定范围 | 最小值 | 最大值 | 默认值 | 属性 | 更改 类型 | 备注 | 修正说明 | 初始化(V2.xx) | 修改 | 修改后 | 掉电后
F0 | F0-00 | 机器类型显示 |  | 0 | 9999 | 1 | 0x1140 | 只读 |  |  | 1 | 不可修改 | 不可修改 | 1
 | F0-01 | 控制方式 | 0：畅游模式 1：定时模式 2：距离模式 3：娱乐自定义模式 | 0 | 3 | 0 | 0x0040 |  | 掉电存储 |  | 0 | 3 | 3 | 3
 | F0-02 | 运行指令源选择 | 0：面板控制 1：485(modbus协议) 2：APP(WIFI)+面板控制 | 0 | 2 | 0 | 0x0040 |  | 485(modbus)控制优先度最高，面板控制和APP优先度一样 |  | 0 | 2 | 2 | 2
 | F0-03 | 运行信号源选择 | 0：功能码设定，掉电记忆 1：功能码设定，掉电不记忆 2：通讯设定（485+modbus） 3：APP(WIFI)控制协议 | 0 | 3 | 0 | 0x0040 |  | 包括速度，时间，距离，自定义控制的设置方式 |  | 0 | 3 | 3 | 3
 | F0-04 | 速度给定模式 | 0：百分比给定模式 1: 平均分级速度给定模式 2: 设定分级速度给定模式 3: 实际速度给定 | 0 | 2 | 0 | 0x0840 |  |  |  | 0 | 1 | 1 | 1
 | F0-05 | 运行指令捆绑运行信号源选择 | 个位：面板控制绑定速度信号源 0：未绑定 1：功能码设定(面板给定）掉电记忆 2: 功能码设定，掉电不记忆 3: modbus 4：APP控制协议 十位：485控制绑定速度信号源（详见个位） 百位：APP(WIFI)+面板控制绑定速度信号源（详见个位） | 0 | 444 | 30 | 0x00C0 |  | 设定相应的运行指令时，自动选择速度信号源，这样只要切换运行指令方式就可以达到同时设定控制信号的方式 |  | 30 | 31 | 31 | 31
 | F0-06 | 保留 |  | 0 | 1 | 0 | 0x0840 |  |  |  | 0 | 1 | 1 | 1
 | F0-07 | wifi状态切换时间 | 0.1s~6000.0s | 1 | 60000 | 1200 | 0x0141 |  | wifi超过切换时间还没有联网成功，则退出wifi组网状态 |  | 120.0 | 20.0 | 20.0 | 20.0
 | F0-08 | 游泳准备时间 | 0s~360s | 0 | 65535 | 0 | 0x08C0 |  | 按下开机键后，经过设置停留准备时间后，机器才启动。设置为0时，取消改功能 |  | 0 | 10 | 10 | 10
 | F0-09 | 保留 |  | 0 | 65535 | 0 | 0x1040 |  |  |  | 0
 | F0-10 | 保留 |  | 0 | 65535 | 0 | 0x1040 |  |  |  | 0
 | F0-11 | 平均分级速度段数 | 0~100 | 0 | 100 | 10 | 0x00C0 |  | F0-05 |  | 10 | 11 | 11 | 11
 | F0-12 | 平均分级速度开始位置 | 0：0速度为起点 1：转速下限为起点 | 0 | 1 | 0 | 0x0840 |  | F0-06 |  | 0 | 1 | 1 | 1
 | F0-13 | 百分比速度给定步进数值 | 1~99 | 1 | 99 | 1 | 0x0080 |  | 每按下一下UP/DOWN键，当前设定值增加/减小的 数值的大小，当前修改值为十位，百位数时无效 |  | 1 | 2 | 2 | 2
 | F0-14 | 自定义模式记忆功能 | 个位：掉电记忆选择 0：掉电不记忆 1：掉电记忆 十位：停机记忆选择 0：停机不记忆 1：停机记忆 | 0 | 11 | 0 | 0x4080 |  |  |  | 00 | 01 | 01 | 01
 | F0-15 | 自定义模式组应用设置1 | 个位：自定义模式-组1 0：不使用 1：娱乐模式 2: 专业自定义模式 3: 保留 十位：自定义模式-组2 百位：自定义模式-组3 千位：自定义模式-组4 万位：自定义模式-组5 | 0 | 22222 | 11111 | 0x4940 |  | 程序现在支持10组自定义，娱乐组+专业定义组=max 10组 |  | 11111 | 11112 | 11112 | 11112
 | F0-16 | 自定义模式组应用设置2 | 个位：自定义模式-组6 0：不使用 1：娱乐模式 2: 专业自定义模式 3: 保留 十位：自定义模式-组7 百位：自定义模式-组8 千位：自定义模式-组9 万位：自定义模式-组10 | 0 | 22222 | 22222 | 0x4940 |  | 程序支持10级速度阶梯 |  | 22222 | 22221 | 22221 | 22221
 | F0-17 | 自定义模式运行类型设置1 | 个位：自定义模式-组1运行类型选择 0：定时运行 1：路程运行 2：保留 十位：自定义模式-组2运行类型选择 百位：自定义模式-组3运行类型选择 千位：自定义模式-组4运行类型选择 万位：自定义模式-组5运行类型选择 | 0 | 11111 | 0 | 0x4940 |  |  |  | 0 | 1 | 1 | 1
 | F0-18 | 自定义模式运行类型设置2 | 个位：自定义模式-组6运行类型选择 0：定时运行 1：路程运行 2：保留 十位：自定义模式-组7运行类型选择 百位：自定义模式-组8运行类型选择 千位：自定义模式-组9运行类型选择 万位：自定义模式-组10运行类型选择 | 0 | 11111 | 11111 | 0x4940 |  |  |  | 11111 | 11110 | 11110 | 11110
 | F0-19 | 自定义模式运行方式设置1 | 个位：自定义模式-组1运行方式选择 0：单次运行结束停机 1：单次运行结束保持最后运行速度 2：一直循环 十位：自定义模式-组2运行方式选择 百位：自定义模式-组3运行方式选择 千位：自定义模式-组4运行方式选择 万位：自定义模式-组5运行方式选择 | 0 | 22222 | 0 | 0x4940 |  |  |  | 0 | 2 | 2 | 2
 | F0-20 | 自定义模式运行方式设置2 | 个位：自定义模式-组6运行方式选择 0：单次运行结束停机 1：单次运行结束保持最后运行速度 2：一直循环 十位：自定义模式-组7运行方式选择 百位：自定义模式-组8运行方式选择 千位：自定义模式-组9运行方式选择 万位：自定义模式-组10运行方式选择 | 0 | 22222 | 11111 | 0x4940 |  |  |  | 11111 | 11112 | 11112 | 11112
 | F0-21 | 自定义模式定时控制时间单位选择1 | 个位：自定义模式-组1定时控制时间单位选择 0：秒 1：分 2：小时（预留） 十位：自定义模式-组2定时控制时间单位选择 百位：自定义模式-组3定时控制时间单位选择 千位：自定义模式-组4定时控制时间单位选择 万位：自定义模式-组5定时控制时间单位选择 | 0 | 22222 | 11111 | 0x4940 |  |  |  | 11111 | 11110 | 11110 | 11110
 | F0-22 | 自定义模式定时控制时间单位选择2 | 个位：自定义模式-组6定时控制时间单位选择 0：秒 1：分 2：小时（预留） 十位：自定义模式-组7定时控制时间单位选择 百位：自定义模式-组8定时控制时间单位选择 千位：自定义模式-组9定时控制时间单位选择 万位：自定义模式-组10定时控制时间单位选择 | 0 | 22222 | 11111 | 0x4940 |  |  |  | 11111 | 11110 | 11110 | 11110
F1 | F1-00 | 设定转速1--百分比形式 | 20%~100% | 20 | 100 | 30 | 0x00F0 |  |  | 掉电存储 | 30 | 27 | 27 | 27
 | F1-01 | 设定转速2--百分比形式 | 20~100 | 20 | 100 | 30 | 0x00F0 |  |  | 掉电存储 | 30 | 28 | 28 | 28
 | F1-02 | 设定转速3--百分比形式 | 20%~100% | 20 | 100 | 30 | 0x00F0 |  |  | 掉电存储 | 30 | 29 | 29 | 29
 | F1-03 | 设定转速4--百分比形式 | 20%~100% | 20 | 100 | 30 | 0x00F0 |  |  | 掉电存储 | 30 | 31 | 31 | 31
 | F1-04 | 设定转速1--分级形式 | 1~99 | 1 | 99 | 2 | 0x0080 |  | 最大值受到当前设定的分级速度级数限制 | 掉电存储 | 2 | 1 | 1 | 1
 | F1-05 | 设定转速2--分级形式 | 1~99 | 1 | 99 | 2 | 0x0080 |  | 最大值受到当前设定的分级速度级数限制 | 掉电存储 | 2 | 3 | 3 | 3
 | F1-06 | 设定转速3--分级形式 | 1~99 | 1 | 99 | 2 | 0x0080 |  | 最大值受到当前设定的分级速度级数限制 | 掉电存储 | 2 | 4 | 4 | 4
 | F1-07 | 设定转速4--分级形式 | 1~99 | 1 | 99 | 2 | 0x0080 |  | 最大值受到当前设定的分级速度级数限制 | 掉电存储 | 2 | 5 | 5 | 5
 | F1-08 | 定时模式设定时间 | 1min~99min | 1 | 99 | 30 | 0x0080 |  |  | 掉电存储 | 30 | 31 | 31 | 31
 | F1-09 | 距离模式设定距离 | 0.01km~99.99km | 1 | 9999 | 50 | 0x0102 |  |  | 掉电存储 | 00.50 | 00.51 | 00.51 | 00.51
 | F1-10 | 自定义模式运行选择 | 0：fun模式 1：preCustom模式 | 0 | 1 | 0 | 0x0040 |  |  | 掉电存储 | 0 | 1 | 1 | 1
 | F1-11 | 自定义模式-fun当前运行组 | 0~10 | 0 | 10 | 0 | 0x0880 |  | 可以设置的最大值与自定义运行模式相关 | 掉电存储 | 00 | 01 | 01 | 01
 | F1-12 | 自定义模式-preCustom当前运行组 | 0~10 | 0 | 10 | 0 | 0x0880 |  | 可以设置的最大值与自定义运行模式相关 | 掉电存储 | 00 | 01 | 01 | 01
 | F1-13 | 保留 |  |  |  |  |  |  |  |  | 0 | 无法修改 | 无法修改 | 0
 | F1-14 | 当前设定的分级速度级数 | 1~99 | 1 | 99 | 10 | 0x0080 |  |  |  | 10 | 11 | 11 | 11
 | F1-15 | 转速下限(RPM) | 0RPM~1000RPM | 0 | 1000 | 0 | 0x0900 |  | RPM速度 |  | 0000 | 0001 | 0001 | 0001
 | F1-16 | 保留 |  |  |  |  |  |  |  |  | 0 | 无法修改 | 无法修改 | 0
 | F1-17 | 驱动最小PID速度(erpm) | 0ERPM~9999ERPM | 0 | 9999 | 900 | 0x0900 |  | 参数在drive确定 |  | 900 | 901 | 901 | 901
 | F1-18 | 转速下限-(PER) | 0%~80% | 0 | 80 | 20 | 0x00F0 |  | 可以设置的最低百分比速度 |  | 20 | 21 | 21 | 21
 | F1-19 | 自定义模式控制最大组数 | 1~10 | 1 | 10 | 10 | 0x0880 |  |  |  | 10 | 9 | 9 | 9
 | F2-00 | 自定义模式_定时速度1 | 0.0~100.0% | 12 | 100 | 30 | 0x08F0
 | F2-01 | 自定义模式_定时速度2 | 0.0~100.0% | 12 | 100 | 30 | 0x08F0
 | F2-02 | 自定义模式_定时速度3 | 0.0~100.0% | 12 | 100 | 30 | 0x08F0
 | F2-03 | 自定义模式_定时速度4 | 0.0~100.0% | 12 | 100 | 30 | 0x08F0
 | F2-04 | 自定义模式_定时速度5 | 0.0~100.0% | 12 | 100 | 30 | 0x08F0
 | F2-05 | 自定义模式_定时速度6 | 0.0~100.0% | 12 | 100 | 30 | 0x08F0
 | F2-06 | 自定义模式_定时速度7 | 0.0~100.0% | 12 | 100 | 30 | 0x08F0
 | F2-07 | 自定义模式_定时速度8 | 0.0~100.0% | 12 | 100 | 30 | 0x08F0
 | F2-08 | 自定义模式_定时速度9 | 0.0~100.0% | 12 | 100 | 30 | 0x08F0
 | F2-09 | 自定义模式_定时速度10 | 0.0~100.0% | 12 | 100 | 30 | 0x08F0
 | F2-10 | 自定义模式_定时速度11 | 0.0~100.0% | 12 | 100 | 35 | 0x08F0
 | F2-11 | 自定义模式_定时速度12 | 0.0~100.0% | 12 | 100 | 35 | 0x08F0
 | F2-12 | 自定义模式_定时速度13 | 0.0~100.0% | 12 | 100 | 35 | 0x08F0
 | F2-13 | 自定义模式_定时速度14 | 0.0~100.0% | 12 | 100 | 35 | 0x08F0
 | F2-14 | 自定义模式_定时速度15 | 0.0~100.0% | 12 | 100 | 35 | 0x08F0
 | F2-15 | 自定义模式_定时速度16 | 0.0~100.0% | 12 | 100 | 35 | 0x08F0
 | F2-16 | 自定义模式_定时速度17 | 0.0~100.0% | 12 | 100 | 35 | 0x08F0
 | F2-17 | 自定义模式_定时速度18 | 0.0~100.0% | 12 | 100 | 35 | 0x08F0
 | F2-18 | 自定义模式_定时速度19 | 0.0~100.0% | 12 | 100 | 35 | 0x08F0
 | F2-19 | 自定义模式_定时速度20 | 0.0~100.0% | 12 | 100 | 35 | 0x08F0
 | F2-20 | 自定义模式_定时速度21 | 0.0~100.0% | 12 | 100 | 40 | 0x08F0
 | F2-21 | 自定义模式_定时速度22 | 0.0~100.0% | 12 | 100 | 40 | 0x08F0
 | F2-22 | 自定义模式_定时速度23 | 0.0~100.0% | 12 | 100 | 40 | 0x08F0
 | F2-23 | 自定义模式_定时速度24 | 0.0~100.0% | 12 | 100 | 40 | 0x08F0
 | F2-24 | 自定义模式_定时速度25 | 0.0~100.0% | 12 | 100 | 40 | 0x08F0
 | F2-25 | 自定义模式_定时速度26 | 0.0~100.0% | 12 | 100 | 40 | 0x08F0
 | F2-26 | 自定义模式_定时速度27 | 0.0~100.0% | 12 | 100 | 40 | 0x08F0 |  |  | ·
 | F2-27 | 自定义模式_定时速度28 | 0.0~100.0% | 12 | 100 | 40 | 0x08F0
 | F2-28 | 自定义模式_定时速度29 | 0.0~100.0% | 12 | 100 | 40 | 0x08F0
 | F2-29 | 自定义模式_定时速度30 | 0.0~100.0% | 12 | 100 | 40 | 0x08F0
 | F2-30 | 自定义模式_定时速度31 | 0.0~100.0% | 12 | 100 | 45 | 0x08F0
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
 | F5-90 | 自定义模式_距离数值91 | 0.00Km~99.99Km | 0 | 9999 | 100 | 0x0902
 | F5-91 | 自定义模式_距离数值92 | 0.00Km~99.99Km | 0 | 9999 | 100 | 0x0902
 | F5-92 | 自定义模式_距离数值93 | 0.00Km~99.99Km | 0 | 9999 | 100 | 0x0902
 | F5-93 | 自定义模式_距离数值94 | 0.00Km~99.99Km | 0 | 9999 | 100 | 0x0902
 | F5-94 | 自定义模式_距离数值95 | 0.00Km~99.99Km | 0 | 9999 | 100 | 0x0902
 | F5-95 | 自定义模式_距离数值96 | 0.00Km~99.99Km | 0 | 9999 | 100 | 0x0902
 | F5-96 | 自定义模式_距离数值97 | 0.00Km~99.99Km | 0 | 9999 | 100 | 0x0902
 | F5-97 | 自定义模式_距离数值98 | 0.00Km~99.99Km | 0 | 9999 | 100 | 0x0902
 | F5-98 | 自定义模式_距离数值99 | 0.00Km~99.99Km | 0 | 9999 | 100 | 0x0902
 | F5-99 | 自定义模式_距离数值100 | 0.00Km~99.99Km | 0 | 9999 | 100 | 0x0902
F6 | F6-00 | 加减速方式 | 0:直线加减速 1:动态S曲线加减速 2:静态S曲线加减速 | 0 | 2 | 0 | 0x0840 |  |  |  | 0 | 1 | 1 | 1
 | F6-01 | 加速时间1 | 0s~9999s | 0 | 9999 | 20 | 0x0100 |  |  |  | 20 | 21 | 21 | 21
 | F6-02 | 减速时间1 | 0s~9999s | 0 | 9999 | 20 | 0x0100 |  |  |  | 20 | 22 | 22 | 22
 | F6-03 | S曲线开始段时间比例 | 0~1000 | 0 | 1000 | 300 | 0x0931 |  |  |  | 30.0 | 30.1 | 30.1 | 30.1
 | F6-04 | S曲线结束段时间比例 | 0~1000 | 0 | 1000 | 300 | 0x0931 |  |  |  | 30.0 | 30.2 | 30.2 | 30.2
 | F6-05 | 停机方式 | 0：减速停机 1：立即停机（急停） | 0 | 1 | 0 | 0x0040 |  |  |  | 0 | 1 | 1 | 1
 | F6-06 | 加减速时间基准速度 | 个位：时间单位 0：秒 1：0.1秒 2：0.01秒 十位：基准速度 0：最大速度 1：设定速度 2: 3000RPM | 0 | 22 | 0 | 0x4880 |  |  |  | 0 | 1 | 1 | 1
 | F6-07 | 加减速定义1 | 个位：自定义模式-step1加减速选择 0：使用系统加减速 1~A：使用自定义加减速1~10 十位：自定义模式-step2加减速选择 百位：自定义模式-step3加减速选择 千位：自定义模式-step4加减速选择 | 0 | 0xaaaa | 0x1111 | 0x8900 |  |  |  | H 1111 | H 1112 | H 1112 | H 1112
 | F6-08 | 加减速定义2 | 个位：自定义模式-step5加减速选择 0：使用系统加减速 1~A：使用自定义加减速1~10 十位：自定义模式-step6加减速选择 百位：自定义模式-step7加减速选择 千位：自定义模式-step8加减速选择 | 0 | 0xaaaa | 0x2222 | 0x8900 |  |  |  | H 2222 | H 2223 | H 2223 | H 2223
 | F6-09 | 加减速定义3 | 个位：自定义模式-step9加减速选择 0：使用系统加减速 1~A：使用自定义加减速1~10 十位：自定义模式-step10加减速选择 百位：自定义模式-step11加减速选择 千位：自定义模式-step12加减速选择 | 0 | 0xaaaa | 0x3333 | 0x8900 |  | 加减速时间对应的基准速度 |  | H 3333 | H 3334 | H 3334 | H 3334
 | F6-10 | 加减速定义4 | 个位：自定义模式-step13加减速选择 0：使用系统加减速 1~A：使用自定义加减速1~10 十位：自定义模式-step14加减速选择 百位：自定义模式-step15加减速选择 千位：自定义模式-step16加减速选择 | 0 | 0xaaaa | 0x4444 | 0x8900 |  |  |  | H 4444 | H 4445 | H 4445 | H 4445
 | F6-11 | 加减速定义5 | 个位：自定义模式-step17加减速选择 0：使用系统加减速 1~A：使用自定义加减速1~10 十位：自定义模式-step18加减速选择 百位：自定义模式-step19加减速选择 千位：自定义模式-step20加减速选择 | 0 | 0xaaaa | 0x5555 | 0x8900 |  |  |  | H 5555 | H 5556 | H 5556 | H 5556
 | F6-12 | 加减速定义6 | 个位：自定义模式-step21加减速选择 0：使用系统加减速 1~A：使用自定义加减速1~10 十位：自定义模式-step22加减速选择 百位：自定义模式-step23加减速选择 千位：自定义模式-step24加减速选择 | 0 | 0xaaaa | 0x6666 | 0x8900 |  |  |  | H 6666 | H 6667 | H 6667 | H 6667
 | F6-13 | 加减速定义7 | 个位：自定义模式-step25加减速选择 0：使用系统加减速 1~A：使用自定义加减速1~10 十位：自定义模式-step26加减速选择 百位：自定义模式-step27加减速选择 千位：自定义模式-step28加减速选择 | 0 | 0xaaaa | 0x7777 | 0x8900 |  |  |  | H 7777 | H 7778 | H 7778 | H 7778
 | F6-14 | 加减速定义8 | 个位：自定义模式-step29加减速选择 0：使用系统加减速 1~A：使用自定义加减速1~10 十位：自定义模式-step30加减速选择 百位：自定义模式-step31加减速选择 千位：自定义模式-step32加减速选择 | 0 | 0xaaaa | 0x8888 | 0x8900 |  |  |  | H 8888 | H 8889 | H 8889 | H 8889
 | F6-15 | 加减速定义9 | 个位：自定义模式-step33加减速选择 0：使用系统加减速 1~A：使用自定义加减速1~10 十位：自定义模式-step34加减速选择 百位：自定义模式-step35加减速选择 千位：自定义模式-step36加减速选择 | 0 | 0xaaaa | 0x9999 | 0x8900 |  |  |  | H 9999 | H 9998 | H 9998 | H 9998
 | F6-16 | 加减速定义10 | 个位：自定义模式-step37加减速选择 0：使用系统加减速 1~A：使用自定义加减速1~10 十位：自定义模式-step38加减速选择 百位：自定义模式-step39加减速选择 千位：自定义模式-step40加减速选择 | 0 | 0xaaaa | 0x8888 | 0x8900 |  |  |  | H 8888 | H 8889 | H 8889 | H 8889
 | F6-17 | 加减速定义11 | 个位：自定义模式-step41加减速选择 0：使用系统加减速 1~A：使用自定义加减速1~10 十位：自定义模式-step42加减速选择 百位：自定义模式-step43加减速选择 千位：自定义模式-step44加减速选择 | 0 | 0xaaaa | 0x7777 | 0x8900 |  |  |  | H 7777 | H 7778 | H 7778 | H 7778
 | F6-18 | 加减速定义12 | 个位：自定义模式-step45加减速选择 0：使用系统加减速 1~A：使用自定义加减速1~10 十位：自定义模式-step46加减速选择 百位：自定义模式-step47加减速选择 千位：自定义模式-step48加减速选择 | 0 | 0xaaaa | 0x6666 | 0x8900 |  |  |  | H 6666 | H 6667 | H 6667 | H 6667
 | F6-19 | 加减速定义13 | 个位：自定义模式-step49加减速选择 0：使用系统加减速 1~A：使用自定义加减速1~10 十位：自定义模式-step50加减速选择 百位：自定义模式-step51加减速选择 千位：自定义模式-step52加减速选择 | 0 | 0xaaaa | 0x5555 | 0x8900 |  |  |  | H 5555 | H 5556 | H 5556 | H 5556
 | F6-20 | 加减速定义14 | 个位：自定义模式-step53加减速选择 0：使用系统加减速 1~A：使用自定义加减速1~10 十位：自定义模式-step54加减速选择 百位：自定义模式-step55加减速选择 千位：自定义模式-step56加减速选择 | 0 | 0xaaaa | 0x4444 | 0x8900 |  |  |  | H 4444 | H 4445 | H 4445 | H 4445
 | F6-21 | 加减速定义15 | 个位：自定义模式-step57加减速选择 0：使用系统加减速 1~A：使用自定义加减速1~10 十位：自定义模式-step58加减速选择 百位：自定义模式-step59加减速选择 千位：自定义模式-step60加减速选择 | 0 | 0xaaaa | 0x3333 | 0x8900 |  |  |  | H 3333 | H 3334 | H 3334 | H 3334
 | F6-22 | 加减速定义16 | 个位：自定义模式-step61加减速选择 0：使用系统加减速 1~A：使用自定义加减速1~10 十位：自定义模式-step62加减速选择 百位：自定义模式-step63加减速选择 千位：自定义模式-step64加减速选择 | 0 | 0xaaaa | 0x2222 | 0x8900 |  |  |  | H 2222 | H 2223 | H 2223 | H 2223
 | F6-23 | 加减速定义17 | 个位：自定义模式-step65加减速选择 0：使用系统加减速 1~A：使用自定义加减速1~10 十位：自定义模式-step66加减速选择 百位：自定义模式-step67加减速选择 千位：自定义模式-step68加减速选择 | 0 | 0xaaaa | 0x1111 | 0x8900 |  |  |  | H 1111 | H 1112 | H 1112 | H 1112
 | F6-24 | 加减速定义18 | 个位：自定义模式-step69加减速选择 0：使用系统加减速 1~A：使用自定义加减速1~10 十位：自定义模式-step70加减速选择 百位：自定义模式-step71加减速选择 千位：自定义模式-step72加减速选择 | 0 | 0xaaaa | 0x9999 | 0x8900 |  |  |  | H 9999 | H 9998 | H 9998 | H 9998
 | F6-25 | 加减速定义19 | 个位：自定义模式-step73加减速选择 0：使用系统加减速 1~A：使用自定义加减速1~10 十位：自定义模式-step74加减速选择 百位：自定义模式-step75加减速选择 千位：自定义模式-step76加减速选择 | 0 | 0xaaaa | 0x8888 | 0x8900 |  |  |  | H 8888 | H 8889 | H 8889 | H 8889
 | F6-26 | 加减速定义20 | 个位：自定义模式-step77加减速选择 0：使用系统加减速 1~A：使用自定义加减速1~10 十位：自定义模式-step78加减速选择 百位：自定义模式-step79加减速选择 千位：自定义模式-step80加减速选择 | 0 | 0xaaaa | 0x7777 | 0x8900 |  |  |  | H 7777 | H 7778 | H 7778 | H 7778
 | F6-27 | 加减速定义21 | 个位：自定义模式-step81加减速选择 0：使用系统加减速 1~A：使用自定义加减速1~10 十位：自定义模式-step82加减速选择 百位：自定义模式-step83加减速选择 千位：自定义模式-step84加减速选择 | 0 | 0xaaaa | 0x6666 | 0x8900 |  |  |  | H 6666 | H 6667 | H 6667 | H 6667
 | F6-28 | 加减速定义22 | 个位：自定义模式-step85加减速选择 0：使用系统加减速 1~A：使用自定义加减速1~10 十位：自定义模式-step86加减速选择 百位：自定义模式-step87加减速选择 千位：自定义模式-step88加减速选择 | 0 | 0xaaaa | 0x5555 | 0x8900 |  |  |  | H 5555 | H 5556 | H 5556 | H 5556
 | F6-29 | 加减速定义23 | 个位：自定义模式-step89加减速选择 0：使用系统加减速 1~A：使用自定义加减速1~10 十位：自定义模式-step90加减速选择 百位：自定义模式-step91加减速选择 千位：自定义模式-step92加减速选择 | 0 | 0xaaaa | 0x4444 | 0x8900 |  |  |  | H 4444 | H 4445 | H 4445 | H 4445
 | F6-30 | 加减速定义24 | 个位：自定义模式-step93加减速选择 0：使用系统加减速 1~A：使用自定义加减速1~10 十位：自定义模式-step94加减速选择 百位：自定义模式-step95加减速选择 千位：自定义模式-step96加减速选择 | 0 | 0xaaaa | 0x3333 | 0x8900 |  |  |  | H 3333 | H 3334 | H 3334 | H 3334
 | F6-31 | 加减速定义25 | 个位：自定义模式-step97加减速选择 0：使用系统加减速 1~A：使用自定义加减速1~10 十位：自定义模式-step98加减速选择 百位：自定义模式-step99加减速选择 千位：自定义模式-step100加减速选择 | 0 | 0xaaaa | 0x2222 | 0x8900 |  |  |  | H 2222 | H 2223 | H 2223 | H 2223
 | F6-32 | 自定义加速时间1 |  | 0 | 65535 | 1 | 0x0140 |  |  |  | 1 | 2 | 2 | 2
 | F6-33 | 自定义减速时间1 |  | 0 | 65535 | 1 | 0x0140 |  |  |  | 1 | 2 | 2 | 2
 | F6-34 | 自定义加速时间2 |  | 0 | 65535 | 2 | 0x0140 |  |  |  | 2 | 3 | 3 | 3
 | F6-35 | 自定义减速时间2 |  | 0 | 65535 | 2 | 0x0140 |  |  |  | 2 | 3 | 3 | 3
 | F6-36 | 自定义加速时间3 |  | 0 | 65535 | 3 | 0x0140 |  |  |  | 3 | 4 | 4 | 4
 | F6-37 | 自定义减速时间3 |  | 0 | 65535 | 3 | 0x0140 |  |  |  | 3 | 4 | 4 | 4
 | F6-38 | 自定义加速时间4 |  | 0 | 65535 | 4 | 0x0140 |  |  |  | 4 | 5 | 5 | 5
 | F6-39 | 自定义减速时间4 |  | 0 | 65535 | 4 | 0x0140 |  |  |  | 4 | 5 | 5 | 5
 | F6-40 | 自定义加速时间5 |  | 0 | 65535 | 5 | 0x0140 |  |  |  | 5 | 6 | 6 | 6
 | F6-41 | 自定义减速时间5 |  | 0 | 65535 | 5 | 0x0140 |  |  |  | 5 | 6 | 6 | 6
 | F6-42 | 自定义加速时间6 |  | 0 | 65535 | 6 | 0x0140 |  |  |  | 6 | 7 | 7 | 7
 | F6-43 | 自定义减速时间6 |  | 0 | 65535 | 6 | 0x0140 |  |  |  | 6 | 7 | 7 | 7
 | F6-44 | 自定义加速时间7 |  | 0 | 65535 | 7 | 0x0140 |  |  |  | 7 | 8 | 8 | 8
 | F6-45 | 自定义减速时间7 |  | 0 | 65535 | 7 | 0x0140 |  |  |  | 7 | 8 | 8 | 8
 | F6-46 | 自定义加速时间8 |  | 0 | 65535 | 8 | 0x0140 |  |  |  | 8 | 9 | 9 | 9
 | F6-47 | 自定义减速时间8 |  | 0 | 65535 | 8 | 0x0140 |  |  |  | 8 | 9 | 9 | 9
 | F6-48 | 自定义加速时间9 |  | 0 | 65535 | 9 | 0x0140 |  |  |  | 9 | 10 | 10 | 10
 | F6-49 | 自定义减速时间9 |  | 0 | 65535 | 9 | 0x0140 |  |  |  | 9 | 10 | 10 | 10
 | F6-50 | 自定义加速时间10 |  | 0 | 65535 | 10 | 0x0140 |  |  |  | 10 | 11 | 11 | 11
 | F6-51 | 自定义减速时间10 |  | 0 | 65535 | 10 | 0x0140 |  |  |  | 10 | 11 | 11 | 11
F7 | F7-00 | LED运行显示参数1 | 0~0xffff | 0 | 0xffff | 0xffff | 0x8140 |  |  |  | H FFFF | H FFFE | H FFFE | H FFFE
 | F7-01 | LED运行显示参数2 | 0~0xffff | 0 | 0xffff | 0xffff | 0x8140 |  |  |  | H FFFF | H FFFd | H FFFd | H FFFd
 | F7-02 | LED停机显示参数1 | 0~0xffff | 0 | 0xffff | 0xffff | 0x8140 |  |  |  | H FFFF | H FFFC | H FFFC | H FFFC
 | F7-03 | LED停机显示参数2 | 0~0xffff | 0 | 0xFFFF | 0xffff | 0x8140 |  |  |  | H FFFF | H FFFb | H FFFb | H FFFb
 | F7-04 | 预留 | 0~65535 | 0 | 65535 | 0 | 0x1140 |  |  |  | 0 | 无法修改 | 无法修改 | 0
 | F7-05 | 产品号 | 1~65535 | 0 | 65535 | 0 | 0x1140 | 参数只读 |  |  | 3 | 无法修改 | 无法修改 | 3
 | F7-06 | 软件版本号 | 1~65535 | 0 | 65535 | 0 | 0x1140 | 参数只读 |  |  | 206 | 无法修改 | 无法修改 | 206
 | F7-07 | 软件修订版本 | 0~65535 | 0 | 65535 | 0 | 0x1140 | 参数只读 |  |  | 3 | 无法修改 | 无法修改 | 3
 | F7-08 | 硬件版本 | 0~65535 | 0 | 65535 | 0 | 0x1140 | 参数只读 |  |  | 11 | 无法修改 | 无法修改 | 11
 | F7-09 | 预留 |  | 0 | 65535 | 0 | 0x1140 |  |  |  | 0 | 无法修改 | 无法修改 | 0
 | F7-10 | 人机交互功能 | 0：关闭功能 1：开启功能 个位：上电准备就绪蜂鸣器长鸣提示 十位： 背光自动熄灭功能 百位: 开机完成后锁屏 千位： 按键音 万位：预留 | 0 | 11111 | 1001 | 0x4140 |  | 背光自动死灭锁屏后，短按mode键3秒解锁 |  | 1001 | 1000 | 1000 | 1000
 | F7-11 | 数值修改模式 | 个位：用户界面数据区域修改模式 0：分区修改模式 1：混区修改模式 十位：用户界面数据修改有效方式 0：修改后按ENTER确认 1：修改后直接有效（闪烁后自动设置） 百位：用户界面开关机按钮 0：长按ENTER键3s开关机 1：点击ENTER键开机关机 | 0 | 111 | 1 | 0x4140 |  | 个位：区域修改模式 --用于用户界面下修改控制参数： 分区修改:进入修改参数后，按mode移位当前修改数值 混区修改：进入修改参数后，按mode移位修改用户界面所有数值 |  | 1 | 100 | 100 | 100
 | F7-12 | 显示模式 | 个位：自定义模式定时显示模式 0：按分钟显示 1：按分钟和秒显示 2：按秒显示 十位：运行速度显示 0：显示当前设定的PER转速（速度稳定不波动） 1：显示反馈的PER转速（速度会有波动） | 0 | 12 | 1 | 0x4140 |  |  |  | 1 | 2 | 2 | 2
 | F7-13 | 预留 |  | 0 | 65535 | 0 | 0x1141 |  |  |  | 0
 | F7-14 | 背光自动熄灭时间 | 3s~65535s | 3 | 65535 | 30 | 0x0100 |  | 单位：s |  | 30 | 27 | 27 | 27
 | F7-15 | 修改参数退出时间 | 1.0s~6553.5s | 10 | 65535 | 30 | 0x0141 |  | 用户界面下 单位：0.1s |  | 3.0 | 3.1 | 3.1 | 3.1
 | F7-16 | 修改控制模式自动退出时间 | 1.0s~6553.5s | 10 | 65535 | 100 | 0x0141 |  | 用户界面下 单位：0.1s | 修改为10.0s | 10.0 | 10.1 | 10.1 | 10.1
 | F7-17 | 修改自定义模式自动退出时间 | 1.0s~6553.5s | 10 | 65535 | 100 | 0x0141 |  | 用户界面下 单位：0.1s |  | 10.0 | 10.1 | 10.1 | 10.1
 | F7-18 | 自定义控制模式显示切换自动退出时间 | 1.0s~6553.5s | 10 | 65535 | 30 | 0x0141 |  | 用户界面下 单位：0.1s |  | 3.0 | 3.1 | 3.1 | 3.1
 | F7-19 | 预留 |  | 0 | 65535 | 0 | 0x1000
 | F7-20 | 累计运行时间单位:h |  | 0 | 65535 | 0 | 0x1000 | 参数只读 |  |  | 0 | 无法修改 | 无法修改 | 0
 | F7-21 | 预留 |  | 0 | 65535 | 0 | 0x1000
 | F7-22 | 累计上电时间单位:h |  | 0 | 65535 | 0 | 0x1000 | 参数只读 |  |  | 0 | 无法修改 | 无法修改
FA | FA-00 | 保留 |  | 0 | 65535 | 0 | 0x1000
 | FA-01 | 保留 |  | 0 | 65535 | 0 | 0x1000
 | FA-02 | 波特率 | 0: 保留 1: 保留 2: 1200BPS 3: 2400BPS 4: 4800BPS 5: 9600BPS 6: 19200BPS 7: 38400BPS 8: 57600BPS 9: 115200BPS | 2 | 9 | 5 | 0x0040 |  | 485（modbus）通信参数 300和600的波特率不支持 |  | 5 | 6 | 6 | 6
 | FA-03 | 数据格式 | 0：无校验：数据格式 <8,N,2> 1：偶检验：数据格式 <8,E,1> 2：奇校验：数据格式 <8,O,1> 3：无校验：数据格式 <8,N,1> | 0 | 3 | 3 | 0x0040 |  | 485（modbus）通信参数 |  | 3 | 0 | 0 | 0
 | FA-04 | 本机地址 | 1~249 | 1 | 249 | 7 | 0x00C0 |  | 485（modbus）通信参数 |  | 7 | 6 | 6 | 6
 | FA-05 | 应答延迟 | 0ms~20ms | 0 | 20 | 2 | 0x0080 |  | 485（modbus）通信参数 |  | 2 | 3 | 3 | 3
 | FA-06 | 通讯超时时间 | 0~600 | 0 | 600 | 0 | 0x00C1 |  | 485（modbus）通信参数 |  | 0.0 | 0.1 | 0.1 | 0.1
 | FA-07 | 通讯数据传送格式选择 | 个位： 0 - 非标准的Modbus-RTU 协议 1：标准的Modbus-RTU 协议 十位：预留 百位：预留 | 0 | 31 | 1 | 0x2040 |  | 485（modbus）通信参数 |  | 1 | 0 | 0 | 0
 | FA-08 | 通讯协议选择 | 0:modbus 1:预留1 2:预留2 | 0 | 0 | 0 | 0x0040 |  |  |  | 0 | 无法修改 | 无法修改 | 0
FB | FB-00 | LCD与驱动通信通信超时 | 0.01s~99.99s：通信超时时间 | 0 | 9999 | 0 | 0x0102 |  | 超时时间到报故障ERR_201 通信超时 -- 没有回复 | 由FA.00转移到此处 | 0 | 0.01 | 0.01 | 0.01
 | FB-01 | LCD与驱动通信通信故障动作 | 0：故障屏蔽 1：响应故障 个位： 十位： 百位： 千位： | 0 | 22222 | 11 | 0x4140 |  |  | 由FA.01转移到此处 | 11 | 10 | 10 | 10
FF | FF-00 | 厂家密码 | 0~65535 | 0 | 65535 | 0 | 0x0140 |  | 输入密码1630才可修改其后的参数 |  | 0 | 1630 | 0 | 0
 | FF-01 | 保留 |  | 0 | 9999 | 10 | 0x08C0 |  |  |  | 10 | 11 | 11 | 11
 | FF-02 | 性能软件版本号 | 1~999 | 1 | 999 | 100 | 0x08C0 |  |  |  | 100 | 101 | 101 | 101
 | FF-03 | 保留 |  | 0 | 65535 | 0 | 0x1000
 | FF-04 | 保留 |  | 0 | 65535 | 0 | 0x1000
 | FF-05 | 电机极数 | 2~60 | 2 | 60 | 8 | 0x0880 |  |  |  | 8 | 10 | 10 | 10
 | FF-06 | 最大速度(RPM) | 1100RPM~9999RPM | 1100 | 9999 | 2115 | 0x0900 |  | RPM速度 |  | 2115 | 2116 | 2116 | 2116
 | FF-07 | 最大速度对应的流速 | 0.00m/S~9.99m/s | 0 | 999 | 500 | 0x00C2 |  | 根据逆流器的测试数据设置 |  | 5.00 | 5.01 | 5.01 | 5.01
 | FF-08 | 功率校正系数100.0% | 1.0%~200.0% | 10 | 2000 | 1000 | 0x0131 |  | D0-09 输入功率计算 校正用 |  | 100.0 | 100.1 | 100.1 | 100.1
 | FF-09 | 驱动就绪时间-0.0~100.0s | 0.0秒~100.0秒 | 0 | 1000 | 70 | 0x0901 |  | 驱动就绪需要一定时间 |  | 7.0 | 7.1 | 7.1 | 7.1
 | FF-10 | 开关电源故障判断使能 | 0：不判断开关电源故障 1：根据FF-22设置电压判断开关电源故障 | 0 | 1 | 1 | 0x0040 |  |  |  | 1 | 0 | 0 | 0
 | FF-11 | 保留 |  | 0 | 65535 | 0 | 0x1000
 | FF-12 | 保留 |  | 0 | 65535 | 0 | 0x1000
 | FF-13 | LCD到drive的速度信号给定源 | 0：PPM（PWM信号） 1: uart通信 | 0 | 3 | 1 | 0x0840 |  |  |  | 1 | 0 | 0 | 0
 | FF-14 | lcd板与drive板之间通讯时间间隔 | 10ms~6000ms | 10 | 6000 | 50 | 0x0900 |  | *ms 单位毫秒 |  | 50 | 20 | 20 | 20
 | FF-15 | PWM频率 | 0：25HZ 1：50HZ 2：100HZ 3：125HZ 4：250HZ | 0 | 4 | 1 | 0x0840 |  | LCD控制板到drive板的速度信号为PWM（PPM）给定时有效 |  | 1 | 0 | 0 | 0
 | FF-16 | PWM最大脉宽--PWM信号输出格式 | 0~9999 | 0 | 9999 | 2000 | 0x0900 |  |  |  | 2000 | 2001 | 2001 | 2001
 | FF-17 | PWM最小脉宽--PWM信号输出格式 | 1~9999 | 1 | 9999 | 1000 | 0x0900 |  |  |  | 1000 | 1001 | 1001 | 1001
 | FF-18 | PWM最大脉宽对应转速(ERPM) | 900~65535 | 900 | 65535 | 12000 | 0x0940 |  | -- PWM信号输出格式 -- 电气转速 |  | 12000 | 12001 | 12001 | 12001
 | FF-19 | PWM最小脉宽对应转速(ERPM) | 900~65535 | 0 | 65535 | 900 | 0x0940 |  | -- PWM信号输出格式 -- 电气转速 |  | 900 | 901 | 901 | 901
 | FF-20 | PWM给定校正系数100.00% | 0.10%~200.00% | 10 | 20000 | 10000 | 0x0172 |  |  |  | 100.00 | 100.01 | 100.01 | 100.01
 | FF-21 | 保留 |  | 0 | 65535 | 0 | 0x1000
 | FF-22 | drive正常工作电压点 | 50~720 | 50 | 720 | 210 | 0x08C1 |  | RSP3000-24 电压范围为：22VDC~28VDC ， CCM 为24V，低于此电压基本上判断开关电源出问题 |  | 21.0 | 21.1 | 21.1 | 21.1
 | FF-23 | 保留 |  | 50 | 720 | 120 | 0x08C1 |  |  |  | 12.0 | 12.1 | 12.1 | 12.1
 | FF-24 | 保留 |  | 50 | 720 | 100 | 0x08C1 |  |  |  | 10.0 | 10.1 | 10.1 | 10.1
 | FF-25 | 控制模式使能畅游-定时-距离- | 0-禁止 1-使能 个位：畅游控制模式开启使能 十位：定时控制模式开启使能 百位：距离控制模式开启使能 千位：自定义娱乐模式开启使能 | 1 | 1111 | 1111 | 0x4100 |  |  |  | 1111 | 111 | 111 | 111
FP | FP-00 | 用户密码 | 0~65535 | 0 | 65535 | 0 | 0x0140 |  |  |  | 0 | 1 | 1 | 1
 | FP-01 | 参数初始化 | 0：无操作 1：恢复出厂值 2：清除记录信息 | 0 | 2 | 0 | 0x0840 |  | --FF组不恢复，一些只查看的参数不恢复 --记录信息为E组故障记录 和 F7组的运行记录内容 |  | 0 | 1 | 0 | 0
 | FP-02 | 功能参数模式属性 | 0~11 | 0 | 11 | 11 | 0x4040 |  |  |  | 1 | 0 | 0 | 0
 | FP-03 | 个性化参数模式选择 | 0~11 | 0 | 11 | 0 | 0x4040 |  |  |  | 0 | 1 | 1 | 1
 | FP-04 | 只读用户密码 | 0~1 | 0 | 1 | 0 | 0x0140 |  |  |  | 0 | 1 | 1 | 1
d0 | d0-00 | 电机反馈转速-RPM |  |  |  |  |  | 只读 | RPM转速
 | d0-01 | 电机设定转速-RPM |  |  |  |  |  | 只读 | RPM转速 -- 最大转速为F1-13
 | d0-02 | 电机反馈转速-ERPM |  |  |  |  |  | 只读 | 电气转速
 | d0-03 | 电机设定转速-ERPM |  |  |  |  |  | 只读 | 电气转速
 | d0-04 | 电机反馈转速-PER |  |  |  |  |  | 只读 | 百分比转速
 | d0-05 | 电机设定转速-PER |  |  |  |  |  | 只读 | 百分比转速
 | d0-06 | 母线电压 |  |  |  |  |  | 只读
 | d0-07 | 电机电流 |  |  |  |  |  | 只读
 | d0-08 | 母线计算电流 |  |  |  |  |  | 只读
 | d0-09 | 输入功率 |  |  |  |  |  | 只读
 | d0-10 | motorQ轴电流 |  |  |  |  |  | 只读
 | d0-11 | motorD轴电流 |  |  |  |  |  | 只读
 | d0-12 | 滤波后的mosfet温度 |  |  |  |  |  | 只读
 | d0-13 | mosfet1温度 |  |  |  |  |  | 只读
 | d0-14 | mosfet2温度 |  |  |  |  |  | 只读
 | d0-15 | mosfet3温度 |  |  |  |  |  | 只读
 | d0-16 | 滤波后的电机温度 |  |  |  |  |  | 只读
 | d0-17 | 变频器故障 |  |  |  |  |  | 只读
 | d0-18 | inputAH |  |  |  |  |  | 只读
 | d0-19 | feedbackAH |  |  |  |  |  | 只读
 | d0-20 | inputWH |  |  |  |  |  | 只读
 | d0-21 | feedbackWH |  |  |  |  |  | 只读
 | d0-22 | PWM脉宽 |  |  |  |  |  | 只读
 | d0-23 | Q轴平均电压 |  |  |  |  |  | 只读
 | d0-24 | D轴平均电压 |  |  |  |  |  | 只读
 | d0-25 | 电机旋转的步数 |  |  |  |  |  | 只读
 | d0-26 | 电机旋转的绝对步数 |  |  |  |  |  | 只读
 | d0-27 | 控制器ID |  |  |  |  |  | 只读
 | d0-28 | 位置给定 |  |  |  |  |  | 只读
 | d0-29 | 非驱动故障记录 |  |  |  |  |  | 只读
 | d0-30 | LCD与drive通信故障 |  |  |  |  |  | 只读
 | d0-31 | 预留 |  |  |  |  |  | 只读
 | d1-00 | 上电eeprom故障记录 |  |  |  |  |  | 只读
 | d1-01 | eeprom故障 |  |  |  |  |  | 只读
 | d1-02 | 驱动原始上报故障 |  |  |  |  |  | 只读
 | d1-03 | 驱动故障（综合后） |  |  |  |  |  | 只读
 | d1-04 | LCD板故障 |  |  |  |  |  | 只读
 | d1-05 | LCD板外设故障 |  |  |  |  |  | 只读
 | d1-06 | LCD当前故障 |  |  |  |  |  | 只读
 | d1-07 | LCD显示故障 |  |  |  |  |  | 只读
 | d1-08 | LCD上电状态 |  |  |  |  |  | 只读
 | d1-09 | 预留 |  |  |  |  |  | 只读
 | d1-10 | 预留 |  |  |  |  |  | 只读
 | d1-11 | 预留 |  |  |  |  |  | 只读
 | d1-12 | 预留 |  |  |  |  |  | 只读
 | d1-13 | 预留 |  |  |  |  |  | 只读
 | d1-14 | 预留 |  |  |  |  |  | 只读
 | d1-15 | fun序列组数 |  |  |  |  |  | 只读
 | d1-16 | preCustom序列组数 |  |  |  |  |  | 只读
 | d1-17 | 当前fun序列 |  |  |  |  |  | 只读
 | d1-18 | 当前preCustom序列 |  |  |  |  |  | 只读
 | d1-19 | 自定义模式-当前运行类型 | 0：Timing1：Di'stance |  |  |  |  | 只读
 | d1-20 | 软件主版本号 |  |  |  |  |  | 只读
 | d1-21 | 软件修订版本 |  |  |  |  |  | 只读
 | d1-22 | 预留 |  |  |  |  |  | 只读
 | d1-23 | 预留 |  |  |  |  |  | 只读
 | d1-24 | 预留 |  |  |  |  |  | 只读
 | d1-25 | 预留 |  |  |  |  |  | 只读
 | d1-26 | 预留 |  |  |  |  |  | 只读
 | d1-27 | 预留 |  |  |  |  |  | 只读
 | d1-28 | 预留 |  |  |  |  |  | 只读
 | d1-29 | 预留 |  |  |  |  |  | 只读
 | d1-30 | 预留 |  |  |  |  |  | 只读
 | d1-31 | 预留 |  |  |  |  |  | 只读
e0 | e0-00 | 第一次故障类型 |  |  |  |  |  | 只读
 | e0-01 | 第二次故障类型 |  |  |  |  |  | 只读
 | e0-02 | 第三次(最近一次)故障类型 |  |  |  |  |  | 只读
 | e0-03 | 第三次(最近一次)故障时速度 |  |  |  |  |  | 只读
 | e0-04 | 第三次(最近一次)故障时电流 |  |  |  |  |  | 只读
 | e0-05 | 第三次(最近一次)故障时母线电压 |  |  |  |  |  | 只读
 | e0-06 | 第三次(最近一次)故障时mos温度 |  |  |  |  |  | 只读
 | e0-07 | 第三次(最近一次)故障时时间（从本次上电开始计时） |  |  |  |  |  | 只读
 | e0-08 | 第三次(最近一次)故障时时间（从运行时开始计时） |  |  |  |  |  | 只读
 | e0-09 | 第二次故障时速度 |  |  |  |  |  | 只读
 | e0-10 | 第二次故障时电流 |  |  |  |  |  | 只读
 | e0-11 | 第二次故障时母线电压 |  |  |  |  |  | 只读
 | e0-12 | 第二次故障时mos温度 |  |  |  |  |  | 只读
 | e0-13 | 第二次故障时时间（从本次上电开始计时） |  |  |  |  |  | 只读
 | e0-14 | 第二次故障时时间（从运行时开始计时） |  |  |  |  |  | 只读
 | e0-15 | 第一次故障时速度 |  |  |  |  |  | 只读
 | e0-16 | 第一次故障时电流 |  |  |  |  |  | 只读
 | e0-17 | 第一次故障时母线电压 |  |  |  |  |  | 只读
 | e0-18 | 第一次故障时mos温度 |  |  |  |  |  | 只读
 | e0-19 | 第一次故障时时间（从本次上电开始计时） |  |  |  |  |  | 只读
 | e0-20 | 第一次故障时时间（从运行时开始计时） |  |  |  |  |  | 只读

Sheet: 参数初始化(V2.01)
参数组 | 参数项 | 参数名称 | 设定范围 | 默认值 | 更改 类型 | 参数 格式 | 属性 | 备注 | 针对测试修正说明 | 初始化(V2.01)
F0 | F0-00 | 机器类型显示 |  |  | 只读 |  | 0x1140 |  |  | 1
 | F0-01 | 控制方式 | 0：畅游模式 1：定时模式 2：距离模式 3：娱乐自定义模式 | 0 |  |  | 0x0840 | 掉电存储 |  | 0
 | F0-02 | 运行指令选择 | 0：面板控制 1：485(modbus协议) 2：APP(WIFI)+面板控制 | 0 |  |  | 0x0840 | 485(modbus)控制优先度最高，面板控制和APP优先度一样 | 参数名称改变，功能未变 | 0
 | F0-03 | 速度信号源选择 | 0：功能码设定，掉电记忆 1：功能码设定，掉电不记忆 2：通讯设定（485+modbus） 3：APP(WIFI)+功能码设定，掉电记忆 4：APP(WIFI)+功能码设定，掉电不记忆 5：预留 | 0 |  |  | 0x0840 |  |  | 0
 | F0-04 | 速度给定模式 | 0：百分比给定模式 1: 平均分级速度给定模式 2: 设定分级速度给定模式 3: 实际速度给定 | 0 |  |  |  |  |  | 0
 | F0-05 | 运行指令捆绑速度信号源选择 | 个位：面板控制绑定速度信号源 0：未绑定 1：功能码设定(面板给定）掉电记忆 2: 功能码设定，掉电不记忆 3: 通讯设定（485+modbus） 4：APP(WIFI)+功能码设定，掉电记忆 5：APP(WIFI)+功能码设定，掉电不记忆 十位：485(modbus协议)控制绑定速度信号源（详见个位） 百位：APP(WIFI)+面板控制绑定速度信号源（详见个位） |  |  |  |  | 设定相应的运行指令时，自动选择速度信号源 | 新增功能 | 10
 | F0-06 | 运行方向 | 0：默认方向 1：与默认方向相反方向 |  |  |  |  |  | 新增功能 | 0
 | F0-07 | 保留
 | F0-08 | 保留
 | F0-09 | 保留
 | F0-10 | 保留
 | F0-11 | 平均分级速度段数 | 0~100 | 10 |  |  |  | F0-05 | 位置相对V1.XX发生改变 | 10
 | F0-12 | 平均分级速度开始位置 | 0：0速度为起点 1：转速下限为起点 | 0 |  |  |  | F0-06 | 位置相对V1.XX发生改变 | 0
 | F0-13 | 分级速度控制运行方式 | 0：单次运行结束停机 1：单次运行结束保持终值 2：一直循环 | 0 |  |  |  | F0-07 | 位置相对V1.XX发生改变 | 0
 | F0-14 | 分级速度控制掉电记忆选择 | 个位: 掉电记忆选择 0：掉电不记忆 1：掉电记忆 十位: 停机记忆选择 0：掉电不记忆 1：掉电记忆 | 00 |  |  |  | F0-08 | 位置相对V1.XX发生改变 | 00
 | F0-15 | 分级速度控制运行时间单位 | 0:秒 1:分 2:时 | 0 |  |  |  | F0-09 | 位置相对V1.XX发生改变 | 0
 | F0-16 | 保留 |  |  |  |  |  |  | 位置相对V1.XX发生改变 | 0
 | F0-17 | 百分比速度给定步进数值 | 1~99 | 1 |  |  |  | 每按下一下UP/DOWN键，当前设定值增加/减小的 数值的大小，当前修改值为十位，百位数时无效 | 位置相对V1.XX发生改变 | 1
 | F0-18 | 娱乐模式组数 | 0~10 | 2 |  |  |  | 程序现在支持10组自定义，娱乐组+专业定义组=max 10组 | 新增功能
 | F0-19 | 娱乐模式速度阶梯级数 | 1~10 | 5 |  |  |  | 程序支持10级速度阶梯 | 新增功能
 | F0-20 | 娱乐模式加减速选择 | 0：系统加减速时间 1：每个阶梯对应一个加减速时间 | 0 |  |  |  |  | 新增功能
 | F0-21 | 专业自定义模式组数 | 0~10 | 2 |  |  |  |  | 新增功能
 | F0-22 | 专业自定义模式速度阶梯级数 | 1~10 | 5 |  |  |  |  | 新增功能
 | F0-23 | 专业自定义模式加减速选择 | 0：系统加减速时间 1：每个阶梯对应一个加减速时间 | 0 |  |  |  |  | 新增功能
 | F0-24 | 预留
 | F0-25 | 预留
 | F0-26 | 预留
 | F0-27 | 预留
 | F0-28 | 预留
 | F0-29 | 预留
 | F0-30 | 预留
 | F0-31 | 预留
 | F0-32 | 预留
 | F0-33 | 预留
 | F0-34 | 预留
 | F0-35 | 预留
 | F0-36 | 预留
F1 | F1-00 | 设定转速1--百分比形式 | 20%~100% | 30 |  | 百分比形式 | 0x00F0 |  |  | 30
 | F1-01 | 设定转速2--百分比形式 | 20~100 | 30 |  | 百分比形式 | 0x00F0 |  |  | 30
 | F1-02 | 设定转速3--百分比形式 | 20%~100% | 30 |  | 百分比形式 | 0x00F0 |  |  | 30
 | F1-03 | 设定转速4--百分比形式 | 20%~100% | 30 |  | 百分比形式 | 0x00F0 |  |  | 30
 | F1-04 | 设定转速1--分级形式 | 1~99 | 2 |  |  | 0x00F0 | 最大值受到当前设定的分级速度级数限制 |  | 2
 | F1-05 | 设定转速2--分级形式 | 1~99 | 2 |  |  | 0x00F0 | 最大值受到当前设定的分级速度级数限制 |  | 2
 | F1-06 | 设定转速3--分级形式 | 1~99 | 2 |  |  | 0x00F0 | 最大值受到当前设定的分级速度级数限制 |  | 2
 | F1-07 | 设定转速4--分级形式 | 1~99 | 2 |  |  | 0x00F0 | 最大值受到当前设定的分级速度级数限制 |  | 2
 | F1-08 | 定时模式设定时间 | 1min~99min | 30 |  |  | 0x0080 |  |  | 30
 | F1-09 | 距离模式设定距离 | 0.01km~99.99km | 50 |  | 2位小数 | 0x0102 |  |  | 00.50
 | F1-10 | 保留
 | F1-11 | 当前设定的分级速度级数 | 1~99 | 10 |  |  |  |  |  | 10
 | F1-12 | 转速下限(RPM) | 0RPM~1000RPM | 0 |  |  | 0x0900 | RPM速度 |  | 0
 | F1-13 | 保留
 | F1-14 | 驱动最小PID速度(erpm) | 0ERPM~9999ERPM | 900 |  |  | 0x0900 | 参数在drive确定 |  | 900
 | F1-15 | 转速下限-(PER) | 0%~80% | 20% |  |  | 0x0100 | 可以设置的最低百分比速度 |  | 20
 | F1-16 | 预留
 | F1-17 | 预留
 | F1-18 | 预留
 | F1-19 | 预留
 | F1-20 | 预留
 | F1-21 | 预留
 | F1-22 | 预留
 | F1-23 | 预留
 | F1-24 | 预留
 | F1-25 | 预留
 | F1-26 | 预留
 | F1-27 | 预留
 | F1-28 | 预留
 | F1-29 | 预留
 | F1-30 | 预留
F2 | F2-00 | 自定义模式_定时速度1 | 0.0~100.0% |  |  |  | 0x08F0
 | F2-01 | 自定义模式_定时速度2 | 0.0~100.0% |  |  |  | 0x08F0
 | F2-02 | 自定义模式_定时速度3 | 0.0~100.0% |  |  |  | 0x08F0
 | F2-03 | 自定义模式_定时速度4 | 0.0~100.0% |  |  |  | 0x08F0
 | F2-04 | 自定义模式_定时速度5 | 0.0~100.0% |  |  |  | 0x08F0
 | F2-05 | 自定义模式_定时速度6 | 0.0~100.0% |  |  |  | 0x08F0
 | F2-06 | 自定义模式_定时速度7 | 0.0~100.0% |  |  |  | 0x08F0
 | F2-07 | 自定义模式_定时速度8 | 0.0~100.0% |  |  |  | 0x08F0
 | F2-08 | 自定义模式_定时速度9 | 0.0~100.0% |  |  |  | 0x08F0
 | F2-09 | 自定义模式_定时速度10 | 0.0~100.0% |  |  |  | 0x08F0
 | F2-10 | 自定义模式_定时速度11 | 0.0~100.0% |  |  |  | 0x08F0
 | F2-11 | 自定义模式_定时速度12 | 0.0~100.0% |  |  |  | 0x08F0
 | F2-12 | 自定义模式_定时速度13 | 0.0~100.0% |  |  |  | 0x08F0
 | F2-13 | 自定义模式_定时速度14 | 0.0~100.0% |  |  |  | 0x08F0
 | F2-14 | 自定义模式_定时速度15 | 0.0~100.0% |  |  |  | 0x08F0
 | F2-15 | 自定义模式_定时速度16 | 0.0~100.0% |  |  |  | 0x08F0
 | F2-16 | 自定义模式_定时速度17 | 0.0~100.0% |  |  |  | 0x08F0
 | F2-17 | 自定义模式_定时速度18 | 0.0~100.0% |  |  |  | 0x08F0
 | F2-18 | 自定义模式_定时速度19 | 0.0~100.0% |  |  |  | 0x08F0
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
 | F6-18 | 预留 |  |  |  |  | 0x0100
 | F6-19 | 预留 |  |  |  |  | 0x0100
 | F6-20 | 预留 |  |  |  |  | 0x0100
 | F6-21 | 预留 |  |  |  |  | 0x0100
F7 | F7-00 | LED运行显示参数1 | 0~0xffff | 0xffff |  |  | 0x8140 |  |  | H FFFF
 | F7-01 | LED运行显示参数2 | 0~0xffff | 0xffff |  |  | 0x8140 |  |  | H FFFF
 | F7-02 | LED停机显示参数1 | 0~0xffff | 0xffff |  |  | 0x8140 |  |  | H FFFF
 | F7-03 | LED停机显示参数2 | 0~0xffff | 0xffff |  |  | 0x8140 |  |  | H FFFF
 | F7-04 | 累计运行时间,单位:h | 0~0xffff | 0 | 参数只读 |  | 0x0100 |  |  | 1
 | F7-05 | 产品号 | 1~0xffff | 0x33 | 参数只读 |  | 0x0100 |  |  | 3
 | F7-06 | 软件版本号 | 1~65000 | 0 | 参数只读 |  | 0x0100 |  |  | 201
 | F7-07 | 累计上电时间 | 0~999 | 0 | 参数只读 |  | 0x0100 |  |  | 17
 | F7-08 | 累计耗电量 | 0~999 | 0 | 参数只读 |  | 0x0100 |  |  | 0
 | F7-09 | 保留 |  |  |  |  |  |  |  | 0
 | F7-10 | 人机交互功能 | 0：关闭功能 1：开启功能 个位：上电准备就绪蜂鸣器长鸣提示 十位： 背光自动熄灭功能 百位: 开机完成后锁屏 千位： 按键音 万位：预留 | 0x1011 |  |  | 0x4140 | 背光自动死灭锁屏后，短按mode键3秒解锁 |  | 0x1011
 | F7-11 | 背光自动熄灭时间 | 3s~65535s | 30 |  |  | 0x0100 | 单位：s |  | 30
 | F7-12 | 修改参数退出时间 | 1.0s~6553.5s | 30 |  |  | 0x0141 | 用户界面下 单位：0.1s |  | 30
 | F7-13 | 修改控制模式自动退出时间 | 1.0s~6553.5s | 30 |  |  | 0x0141 | 用户界面下 单位：0.1s |  | 30
 | F7-14 | 数值修改模式 | 0：分区修改模式 1：混区修改模式 |  |  |  | 0x0040 | 用于用户界面下修改控制参数： 分区修改:进入修改参数后，按mode移位当前修改数值 混区修改：进入修改参数后，按mode移位修改用户界面所有数值 |  | 1
 | F7-15 | 预留 |  |  |  |  | 0x0100
 | F7-16 | 预留 |  |  |  |  | 0x0100
 | F7-17 | 预留 |  |  |  |  | 0x0100
 | F7-18 | 预留 |  |  |  |  | 0x0100
 | F7-19 | 预留 |  |  |  |  | 0x0100
 | F7-20 | 预留 |  |  |  |  | 0x0100
 | F7-21 | 预留 |  |  |  |  | 0x0100
 | F7-22 | 预留 |  |  |  |  | 0x0100
 | F7-23 | 预留 |  |  |  |  | 0x0100
 | F7-24 | 预留 |  |  |  |  | 0x0100
 | F7-25 | 预留 |  |  |  |  | 0x0100
 | F7-26 | 预留 |  |  |  |  | 0x0100
 | F7-27 | 预留 |  |  |  |  | 0x0100
 | F7-28 | 预留 |  |  |  |  | 0x0100
 | F7-29 | 预留 |  |  |  |  | 0x0100
 | F7-30 | 预留 |  |  |  |  | 0x0100
F8 | F8-00 | 加速时间1 |  |  |  |  | 0x0100
 | F8-01 | 减速时间1 |  |  |  |  | 0x0100
 | F8-02 | 加速时间2 |  |  |  |  | 0x0100
 | F8-03 | 减速时间2 |  |  |  |  | 0x0100
 | F8-04 | 加速时间3 |  |  |  |  | 0x0100
 | F8-05 | 减速时间3 |  |  |  |  | 0x0100
 | F8-06 | 加速时间4 |  |  |  |  | 0x0100
 | F8-07 | 减速时间4 |  |  |  |  | 0x0100
 | F8-08 | 加速时间5 |  |  |  |  | 0x0100
 | F8-09 | 减速时间5 |  |  |  |  | 0x0100
 | F8-10 | 加速时间6 |  |  |  |  | 0x0100
F9 | F9-00 | 预留 |  |  |  |  | 0x0100
 | F9-01 | 预留 |  |  |  |  | 0x0100
 | F9-02 | 预留 |  |  |  |  | 0x0100
 | F9-03 | 预留 |  |  |  |  | 0x0100
 | F9-04 | 预留 |  |  |  |  | 0x0100
 | F9-05 | 预留 |  |  |  |  | 0x0100
 | F9-06 | 预留 |  |  |  |  | 0x0100
 | F9-07 | 预留 |  |  |  |  | 0x0100
 | F9-08 | 预留 |  |  |  |  | 0x0100
 | F9-09 | 预留 |  |  |  |  | 0x0100
 | F9-10 | 预留 |  |  |  |  | 0x0100
FA | FA-00 | 保留
 | FA-01 | 保留
 | FA-02 | 波特率 | 0: 保留 1: 保留 2: 1200BPS 3: 2400BPS 4: 4800BPS 5: 9600BPS 6: 19200BPS 7: 38400BPS 8: 57600BPS 9: 115200BPS | 5 |  |  | 0x0040 | 485（modbus）通信参数 300和600的波特率不支持 |  | 5
 | FA-03 | 数据格式 | 0：无校验：数据格式 <8,N,2> 1：偶检验：数据格式 <8,E,1> 2：奇校验：数据格式 <8,O,1> 3：无校验：数据格式 <8,N,1> | 3 |  |  | 0x0040 | 485（modbus）通信参数 |  | 3
 | FA-04 | 本机地址 | 1~249 | 7 |  |  | 0x00C0 | 485（modbus）通信参数 |  | 7
 | FA-05 | 应答延迟 | 0ms~20ms | 2 |  |  | 0x0080 | 485（modbus）通信参数 |  | 2
 | FA-06 | 通讯超时时间 | 0~600 | 0 |  |  | 0x00C1 | 485（modbus）通信参数 |  | 0.0
 | FA-07 | 通讯数据传送格式选择 | 个位： 0 - 非标准的Modbus-RTU 协议 1：标准的Modbus-RTU 协议 十位：预留 百位：预留 | 00 |  |  | 0x2040 | 485（modbus）通信参数 |  | 1
 | FA-08 | 通讯协议选择 | 0:modbus 1:预留1 2:预留2 | 0 |  |  | 0x0040 |  |  | 0
 | FA-09 | 预留 |  |  |  |  | 0x0100
 | FA-10 | 预留 |  |  |  |  | 0x0100
 | FA-11 | 预留 |  |  |  |  | 0x0100
 | FA-12 | 预留 |  |  |  |  | 0x0100
 | FA-13 | 预留 |  |  |  |  | 0x0100
 | FA-14 | 预留 |  |  |  |  | 0x0100
 | FA-15 | 预留 |  |  |  |  | 0x0100
 | FA-16 | 预留 |  |  |  |  | 0x0100
FB | FB-00 | LCD与驱动通信通信超时 | 0.01s~99.99s：通信超时时间 | 20 |  |  | 0x0102 | 超时时间到报故障ERR_201 通信超时 -- 没有回复 | 由FA.00转移到此处 | 00.00
 | FB-01 | LCD与驱动通信通信故障动作 | 0：故障屏蔽 1：响应故障 个位： 十位： 百位： 千位： | 11 |  |  | 0x4140 |  | 由FA.01转移到此处 | 11
 | FB-02 | 预留 |  |  |  |  | 0x0100
 | FB-03 | 预留 |  |  |  |  | 0x0100
 | FB-04 | 预留 |  |  |  |  | 0x0100
 | FB-05 | 预留 |  |  |  |  | 0x0100
 | FB-06 | 预留 |  |  |  |  | 0x0100
 | FB-07 | 预留 |  |  |  |  | 0x0100
 | FB-08 | 预留 |  |  |  |  | 0x0100
 | FB-09 | 预留 |  |  |  |  | 0x0100
 | FB-10 | 预留 |  |  |  |  | 0x0100
 | FB-11 | 预留 |  |  |  |  | 0x0100
 | FB-12 | 预留 |  |  |  |  | 0x0100
 | FB-13 | 预留 |  |  |  |  | 0x0100
 | FB-14 | 预留 |  |  |  |  | 0x0100
 | FB-15 | 预留 |  |  |  |  | 0x0100
 | FB-16 | 预留 |  |  |  |  | 0x0100
FC | FC-00 | 预留 |  |  |  |  | 0x0100
 | FC-01 | 预留 |  |  |  |  | 0x0100
 | FC-02 | 预留 |  |  |  |  | 0x0100
 | FC-03 | 预留 |  |  |  |  | 0x0100
 | FC-04 | 预留 |  |  |  |  | 0x0100
 | FC-05 | 预留 |  |  |  |  | 0x0100
 | FC-06 | 预留 |  |  |  |  | 0x0100
 | FC-07 | 预留 |  |  |  |  | 0x0100
 | FC-08 | 预留 |  |  |  |  | 0x0100
 | FC-09 | 预留 |  |  |  |  | 0x0100
 | FC-10 | 预留 |  |  |  |  | 0x0100
 | FC-11 | 预留 |  |  |  |  | 0x0100
 | FC-12 | 预留 |  |  |  |  | 0x0100
 | FC-13 | 预留 |  |  |  |  | 0x0100
 | FC-14 | 预留 |  |  |  |  | 0x0100
 | FC-15 | 预留 |  |  |  |  | 0x0100
 | FC-16 | 预留 |  |  |  |  | 0x0100
 | FD-00 | 预留
 | FE-00 | 预留
FF | FF-00 | 厂家密码 | 0~65535 | 0 |  |  | 0x0140 | 输入密码1630才可修改其后的参数 |  | 0
 | FF-01 | 保留 |  |  |  |  |  |  |  | 201
 | FF-02 | 性能软件版本号 | 1~999 | 100 |  |  | 0x08C0 |  |  | 100
 | FF-03 | 保留
 | FF-04 | 保留
 | FF-05 | 电机极数 | 2~60 | 8 |  |  | 0x0880 |  |  | 8
 | FF-06 | 最大速度(RPM) | 1100RPM~9999RPM | 2200 |  |  | 0x0900 | RPM速度 |  | 2200
 | FF-07 | 最大速度对应的流速 | 0.00m/S~9.99m/s | 500 |  | 2位小数 | 0x00C2 | 根据逆流器的测试数据设置 |  | 5.00
 | FF-08 | 功率校正系数100.0% | 1.0%~200.0% | 1000 |  |  | 0x0131 | D0-09 输入功率计算 校正用 |  | 100.0
 | FF-09 | 驱动就绪时间-0.0~100.0s | 0.0秒~100.0秒 | 70 |  |  | 0x0901 | 驱动就绪需要一定时间 |  | 7.0
 | FF-10 | 开关电源故障判断使能 | 0：不判断开关电源故障 1：根据FF-22设置电压判断开关电源故障 | 1 |  |  | 0x0040 |  |  | 1
 | FF-11 | 保留
 | FF-12 | 保留
 | FF-13 | LCD到drive的速度信号给定源 | 0：PPM（PWM信号） 1: uart通信 | 1 |  |  | 0x0100 |  |  | 1
 | FF-14 | lcd板与drive板之间通讯时间间隔 | 10ms~6000ms | 50 |  |  | 0x0900 | *ms 单位毫秒 |  | 50
 | FF-15 | PWM频率 | 0：25HZ 1：50HZ 2：100HZ 3：125HZ 4：250HZ | 1 |  |  | 0x0840 | LCD控制板到drive板的速度信号为PWM（PPM）给定时有效 |  | 1
 | FF-16 | PWM最大脉宽--PWM信号输出格式 | 0~9999 | 2000 |  |  | 0x0900 |  |  | 2000
 | FF-17 | PWM最小脉宽--PWM信号输出格式 | 1~9999 | 1000 |  |  | 0x0900 |  |  | 1000
 | FF-18 | PWM最大脉宽对应转速(ERPM) | 900~65535 | 12000 |  |  | 0x0940 | -- PWM信号输出格式 -- 电气转速 |  | 12000
 | FF-19 | PWM最小脉宽对应转速(ERPM) | 900~65535 | 0 |  |  | 0x0940 | -- PWM信号输出格式 -- 电气转速 |  | 0
 | FF-20 | PWM给定校正系数100.00% | 0.10%~200.00% | 10000 |  |  | 0x0172 |  |  | 100.00
 | FF-21 | 保留
 | FF-22 | drive正常工作电压点 | 50~720 | 210 |  |  | 0x08C1 | RSP3000-24 电压范围为：22VDC~28VDC ， CCM 为24V，低于此电压基本上判断开关电源出问题 |  | 21.0
 | FF-23 | 保留 |  |  |  |  |  |  |  | 12.0
 | FF-24 | 保留 |  |  |  |  |  |  |  | 10.0
 | FF-25 | 控制模式使能畅游-定时-距离- | 0-禁止 1-使能 个位：畅游控制模式开启使能 十位：定时控制模式开启使能 百位：距离控制模式开启使能 千位：自定义娱乐模式开启使能 | 1111 |  |  | 0x4100 |  |  | 111
 | FF-26 | 预留 |  |  |  |  | 0x0100
 | FF-27 | 预留 |  |  |  |  | 0x0100
 | FF-28 | 预留 |  |  |  |  | 0x0100
 | FF-29 | 预留 |  |  |  |  | 0x0100
 | FF-30 | 预留 |  |  |  |  | 0x0100
 | FF-31 | 预留 |  |  |  |  | 0x0100
 | FF-32 | 预留 |  |  |  |  | 0x0100
 | FF-33 | 预留 |  |  |  |  | 0x0100
 | FF-34 | 预留 |  |  |  |  | 0x0100
 | FF-35 | 预留 |  |  |  |  | 0x0100
 | FF-36 | 预留 |  |  |  |  | 0x0100
 | FF-37 | 预留 |  |  |  |  | 0x0100
 | FF-38 | 预留 |  |  |  |  | 0x0100
 | FF-39 | 预留 |  |  |  |  | 0x0100
 | FF-40 | 预留 |  |  |  |  | 0x0100
FP | FP-00 | 用户密码 | 0~65535 | 12345 |  |  | 0x0140 |  |  | 0
 | FP-01 | 参数初始化 | 0：无操作 1：恢复出厂值 2：清除记录信息 | 0 |  |  | 0x0840 | --FF组不恢复，一些只查看的参数不恢复 --记录信息为E组故障记录 和 F7组的运行记录内容 |  | 0
 | FP-02 | 功能参数模式属性 | 0~11 | 11 |  |  | 0x4040 |  |  | 1
 | FP-03 | 个性化参数模式选择 | 0~11 | 0 |  |  | 0x4040 |  |  | 0
 | FP-04 | 只读用户密码 | 0~1 | 0 |  |  | 0x0140 |  |  | 0
 | FP-05 | 预留 |  |  |  |  | 0x0100
 | FP-06 | 预留 |  |  |  |  | 0x0100
 | FP-07 | 预留 |  |  |  |  | 0x0100
 | FP-08 | 预留 |  |  |  |  | 0x0100
 | FP-09 | 预留 |  |  |  |  | 0x0100
 | FP-10 | 预留 |  |  |  |  | 0x0100
 | FP-11 | 预留 |  |  |  |  | 0x0100
 | FP-12 | 预留 |  |  |  |  | 0x0100
 | FP-13 | 预留 |  |  |  |  | 0x0100
 | FP-14 | 预留 |  |  |  |  | 0x0100
 | FP-15 | 预留 |  |  |  |  | 0x0100
 | FP-16 | 预留 |  |  |  |  | 0x0100
d0 | d0-00 | 电机反馈转速-RPM |  |  | 只读 |  | 0x1118 | RPM转速
 | d0-01 | 电机设定转速-RPM |  |  | 只读 |  | 0x1118 | RPM转速 -- 最大转速为F1-13
 | d0-02 | 电机反馈转速-ERPM |  |  | 只读 |  | 0x1158 | 电气转速
 | d0-03 | 电机设定转速-ERPM |  |  | 只读 |  | 0x1158 | 电气转速
 | d0-04 | 电机反馈转速-PER |  |  | 只读 |  | 0x10F0 | 百分比转速
 | d0-05 | 电机设定转速-PER |  |  | 只读 |  | 0x10F0 | 百分比转速
 | d0-06 | 母线电压 |  |  | 只读 |  | 0x10E1
 | d0-07 | 电机电流 |  |  | 只读 |  | 0x1152
 | d0-08 | 母线计算电流 |  |  | 只读 |  | 0x1152
 | d0-09 | 输入功率 |  |  | 只读 |  | 0x1141
 | d0-10 | motorQ轴电流 |  |  | 只读 |  | 0x1152
 | d0-11 | motorD轴电流 |  |  | 只读 |  | 0x1152
 | d0-12 | 滤波后的mosfet温度 |  |  | 只读 |  | 0x1101
 | d0-13 | mosfet1温度 |  |  | 只读 |  | 0x1101
 | d0-14 | mosfet2温度 |  |  | 只读 |  | 0x1101
 | d0-15 | mosfet3温度 |  |  | 只读 |  | 0x1101
 | d0-16 | 滤波后的电机温度 |  |  | 只读 |  | 0x1101
 | d0-17 | 变频器故障 |  |  | 只读 |  | 0x10C0
 | d0-18 | inputAH |  |  | 只读 |  | 0x1141
 | d0-19 | feedbackAH |  |  | 只读 |  | 0x1141
 | d0-20 | inputWH |  |  | 只读 |  | 0x1142
 | d0-21 | feedbackWH |  |  | 只读 |  | 0x1142
 | d0-22 | PWM脉宽 |  |  | 只读 |  | 0x1101
 | d0-23 | Q轴平均电压 |  |  | 只读 |  | 0x10E1
 | d0-24 | D轴平均电压 |  |  | 只读 |  | 0x10E1
 | d0-25 | 电机旋转的步数 |  |  | 只读 |  | 0x1140
 | d0-26 | 电机旋转的绝对步数 |  |  | 只读 |  | 0x1140
 | d0-27 | 控制器ID |  |  | 只读 |  | 0x1140
 | d0-28 | 位置给定 |  |  | 只读 |  | 0x1140
 | d0-29 | 非驱动故障记录 |  |  | 只读 |  | 0x1040
 | d0-30 | LCD与drive通信故障 |  |  | 只读 |  | 0x1040
 | d0-31 | 预留 |  |  | 只读 |  | 0x1040
 | d1-00 | 上电eeprom故障记录 |  |  | 只读 |  | 0x1040
 | d1-01 | eeprom故障 |  |  | 只读 |  | 0x1040
 | d1-02 | 驱动原始上报故障 |  |  | 只读 |  | 0x1040
 | d1-03 | 驱动故障（综合后） |  |  | 只读 |  | 0x1040
 | d1-04 | LCD板故障 |  |  | 只读 |  | 0x1040
 | d1-05 | LCD板外设故障 |  |  | 只读 |  | 0x1040
 | d1-06 | LCD当前故障 |  |  | 只读 |  | 0x1040
 | d1-07 | LCD显示故障 |  |  | 只读 |  | 0x1040
 | d1-08 | LCD上电状态 |  |  | 只读 |  | 0x1040
 | d1-09 |  |  |  | 只读 |  | 0x1040
 | d1-10 |  |  |  | 只读 |  | 0x1040
 | d1-11 |  |  |  | 只读 |  | 0x1040
 | d1-12 |  |  |  | 只读 |  | 0x1040
 | d1-13 |  |  |  | 只读 |  | 0x1040
 | d1-14 |  |  |  | 只读 |  | 0x1040
 | d1-15 |  |  |  | 只读 |  | 0x1040
 | d1-16 |  |  |  | 只读 |  | 0x1040
 | d1-17 |  |  |  | 只读 |  | 0x1040
 | d1-18 |  |  |  | 只读 |  | 0x1040
 | d1-19 |  |  |  | 只读 |  | 0x1040
 | d1-20 |  |  |  | 只读 |  | 0x1040
 | d1-21 |  |  |  | 只读 |  | 0x1040
 | d1-22 |  |  |  | 只读 |  | 0x1040
 | d1-23 |  |  |  | 只读 |  | 0x1040
 | d1-24 |  |  |  | 只读 |  | 0x1040
 | d1-25 |  |  |  | 只读 |  | 0x1040
 | d1-26 |  |  |  | 只读 |  | 0x1040
 | d1-27 |  |  |  | 只读 |  | 0x1040
 | d1-28 |  |  |  | 只读 |  | 0x1040
 | d1-29 |  |  |  | 只读 |  | 0x1040
 | d1-30 |  |  |  | 只读 |  | 0x1040
 | d1-31 |  |  |  | 只读 |  | 0x1040
e0 | e0-00 | 第一次故障类型 |  |  | 只读 |  | 0x1100
 | e0-01 | 第二次故障类型 |  |  | 只读 |  | 0x1140
 | e0-02 | 第三次(最近一次)故障类型 |  |  | 只读 |  | 0x1140
 | e0-03 | 第三次(最近一次)故障时速度 |  |  | 只读 |  | 0x10F0
 | e0-04 | 第三次(最近一次)故障时电流 |  |  | 只读 |  | 0x1110
 | e0-05 | 第三次(最近一次)故障时母线电压 |  |  | 只读 |  | 0x10D0
 | e0-06 | 第三次(最近一次)故障时mos温度 |  |  | 只读 |  | 0x1100
 | e0-07 | 第三次(最近一次)故障时时间（从本次上电开始计时） |  |  | 只读 |  | 0x1140
 | e0-08 | 第三次(最近一次)故障时时间（从运行时开始计时） |  |  | 只读 |  | 0x1140
 | e0-09 | 第二次故障时速度 |  |  | 只读 |  | 0x10F0
 | e0-10 | 第二次故障时电流 |  |  | 只读 |  | 0x1110
 | e0-11 | 第二次故障时母线电压 |  |  | 只读 |  | 0x10D0
 | e0-12 | 第二次故障时mos温度 |  |  | 只读 |  | 0x1100
 | e0-13 | 第二次故障时时间（从本次上电开始计时） |  |  | 只读 |  | 0x1140
 | e0-14 | 第二次故障时时间（从运行时开始计时） |  |  | 只读 |  | 0x1140
 | e0-15 | 第一次故障时速度 |  |  | 只读 |  | 0x10F0
 | e0-16 | 第一次故障时电流 |  |  | 只读 |  | 0x1110
 | e0-17 | 第一次故障时母线电压 |  |  | 只读 |  | 0x10D0
 | e0-18 | 第一次故障时mos温度 |  |  | 只读 |  | 0x1100
 | e0-19 | 第一次故障时时间（从本次上电开始计时） |  |  | 只读 |  | 0x1140
 | e0-20 | 第一次故障时时间（从运行时开始计时） |  |  | 只读 |  | 0x1140

Sheet: MODBUS测试（2.0.1）
序号 | 功能码 | 发送数据帧 | 用途 | 接收数据帧（V1.13） | LCD显示
1 | 0x06 | 07 06 FFFF 0001 48 48 | 测试按键 | 07 06 FFFF 0001 48 48 | 1、最右边的七段显示0； 2、从右到左逐一点击按键，最右边的七段分别显示1~4
 |  | 07 06 FFFF 0002 08 49 | 测试LCD显示 | 07 06 FFFF 0002 08 49 | 1、图标从上到下逐一显示； 2、所有七段按从0至9的顺序依次更新显示； 3、屏幕全亮，显示所有段码
 |  | 07 06 FFFF 0003 C9 89 | 测试LCD显示与按键 | 07 06 FFFF 0003 C9 89 | 1、图标从上到下逐一显示； 2、所有七段按从0至9的顺序依次更新显示； 3、屏幕全亮，显示所有段码； 4、最右边的七段显示0； 5、从右到左逐一点击按键，最右边的七段分别显示1~4
 |  | 07 06 F002 0000 1B 6C | 改为面板控制 | 07 06 F002 0000 1B 6C | F0-02参数值变为0，控制方式变为面板控制
 |  | 07 06 F002 0001 DA AC | MODBUS协议控制 | 07 06 F002 0001 DA AC | F0-02参数值变为1，控制方式变为MODBUS协议控制
 |  | 07 06 F003 0000 4A AC | 面板设定转速，掉电记忆 | 07 06 F003 0000 4A AC | F0-03参数值变为0，面板设定转速，掉电记忆
 |  | 07 06 F003 0001 8B 6C | 面板设定转速，掉电不记忆 | 07 06 F003 0001 8B 6C | F0-03参数值变为1，面板设定转速，掉电不记忆
 |  | 07 06 F003 0002 CB 6D | 通讯设定转速 | 07 06 F003 0002 CB 6D | F0-03参数值变为2，通讯设定转速
 |  | 07 06 1200 0000 8C D4 | 切换畅游模式 | 07 06 1200 0000 8C D4 | 开机后，LCD显示畅游模式
 |  | 07 06 1200 0001 4D 14 | 切换定时模式 | 07 06 1200 0001 4D 14 | 开机后，LCD显示定时模式
 |  | 07 06 1200 0002 0D 15 | 切换距离模式 | 07 06 1200 0002 0D 15 | 开机后，LCD显示距离模式
 |  | 07 06 1201 03E8 DD AA | 修改转速为100.0% | 07 06 1201 03E8 DD AA | 转速修改为100.0%
 |  | 07 06 1202 0020 2C CC | 修改定时时间为32min | 07 06 1202 0020 2C CC | 修改定时时间为32min
 |  | 07 06 1203 0020 7D 0C | 修改倒计距离为00.32km | 07 06 1203 0020 7D 0C | 修改倒计距离为00.32km
 |  | 07 06 2000 0001 43 AC | 开机，正转运行 | 07 06 2000 0001 43 AC | 开机，正转运行 （若Err 0102，则FA-01 ：00000）
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
 |  | 07 03 FA01 0001 E5 74 | 读取FA-01参数值 | 07 03 02 00 0B 71 83 | 0BH（11）：响应故障
 |  | 07 03 FA01 0002 A5 75 | 读取FA-02、FA-01参数值 | 07 03 04 00 05 00 00 8C 32 | LCD显示当前状态
 |  | 07 03 FA01 0004 25 77 | 读取FA-04、FA-03、FA-02、FA-01参数值 | 07 03 08 00 07 00 03 00 05 00 00 A9 9E | LCD显示当前状态

Sheet: UART通信
序号 | 发送数据帧 | 接收数据帧
1 | 02 01 04 40 84 03 | 02 4A 04 00 D3 FC E7 00 00 00 00 00 00 00 00 00 00 00 00 00 00 00 00 02 2D 00 00 00 00 00 F5 00 00 00 00 00 00 00 00 00 00 00 00 00 00 00 00 00 00 00 06 00 00 00 0C 00 0E 4B 13 00 3A 00 CA 00 D2 00 CE 00 00 1E 79 00 00 00 19 01 96 04 03
 |  | 02 4A 04 00 D2 FC FA 00 00 00 00 00 00 00 00 00 00 00 00 00 00 00 00 02 2C 00 00 00 00 00 F5 00 00 00 00 00 00 00 00 00 00 00 00 00 00 00 00 00 00 00 06 00 00 00 0C 00 0E 4A B2 D0 3A 00 CA 00 D2 00 CE 00 00 1E D2 00 00 00 11 01 CA CF 03
 |  | 02 4A 04 00 D3 FC E9 00 00 00 00 00 00 00 00 00 00 00 00 00 00 00 00 02 2B 00 00 00 00 00 F5 00 00 00 00 00 00 00 00 00 00 00 00 00 00 00 00 00 00 00 06 00 00 00 0C 00 0E 4B 26 E0 3A 00 CB 00 D2 00 CE 00 00 1E DC 00 00 00 11 01 CE 5A 03
2 | 02 05 32 FF FF FF FF D1 A2 03 | 02 4E 32 FF FF FF FF 00 D7 FC FA 00 00 00 00 00 00 00 00 00 00 00 00 00 00 00 00 02 30 00 00 00 00 00 F5 00 00 00 00 00 00 00 00 00 00 00 00 00 00 00 00 00 00 00 06 00 00 00 0C 00 0E 4A C7 10 3A 00 CD 00 D7 00 D2 00 00 1F 2D 00 00 00 11 01 C4 74 03
 |  | 02 4E 32 FF FF FF FF 00 D7 FC EA 00 00 00 00 00 00 00 00 00 00 00 00 00 00 00 00 02 33 00 00 00 00 00 F5 00 00 00 00 00 00 00 00 00 00 00 00 00 00 00 00 00 00 00 06 00 00 00 0C 00 0E 4A E4 40 3A 00 CD 00 D8 00 D2 00 00 1F 1C 00 00 00 11 01 89 54 03
 |  | 02 4E 32 FF FF FF FF 00 D7 FC FC 00 00 00 00 00 00 00 00 00 00 00 00 00 00 00 00 02 30 00 00 00 00 00 F5 00 00 00 00 00 00 00 00 00 00 00 00 00 00 00 00 00 00 00 06 00 00 00 0C 00 0E 4B 03 F0 3A 00 CC 00 D7 00 D2 00 00 1F 1F 00 00 00 11 01 B0 1A 03

Sheet: 故障功能
故障种类 | 发送数据帧——故障代码 | LCD显示
过电流故障 | 04 | Err 0004
母线过电压故障 | 01 | Err 0007
母线欠电压故障 | 02 | Err 0008
MOS过热故障 | 05 | Err 0010
 | 06 | Err 0011
MCU电压异常 | 08
温度传感器损坏？ | 09 | Err 0015
驱动看门狗复位故障 | 0A | Err 0016
驱动flash损坏故障 | 0E | Err 0017
电流传感器1偏置故障-硬件误差过大 | 0F | Err 0018
电流传感器2偏置故障-硬件误差过大 | 10 | Err 0019
电流传感器3偏置故障-硬件误差过大 | 11 | Err 0020
驱动输出电流不平衡故障 | 12 | Err 0021
驱动的其他故障 | 03 | Err 0098
 | 13
驱动未知故障 | 14 | Err 0099
 | 1A
