Marksman124/inverjet/测试文档/参考/20240621-MM款 IH20B1A 样品测试申请单.xlsx

安捷样品测试申请单
 |  |  |  |  |  | 编号:AQ-R-010 V1.1
物料名称 | 规格型号 | 描述（含类目） | 样品提供方 |  | 送样日期 | 编制 | 审核 | 接收确认
中控系统 | XE10 | 新产品整机测试 | 安捷研发中心-结构项目部 |  | 2024/06/27
送样缘由 | □开发设计中需采用新材料 □ 物料替代 □其它 替代 的型号描述 ■ 新产品 ：中控系统
附属资料 | ■规格书 □技术文件及图纸 □产品标准 □检测标准 □认证文件 □Rohs报告 □其它 如未能提供图纸，需注明原因：___附规格书两份，须按照规格书进行测试和验证。
备注说明： | 1.样机软件 a、参考规格书：<中控样机操作手册> b、PCB板版本和日期：AQPBX008 V1.2，2021-12-08 c、送样产品程序版本：App: 2.1.4-release.apk 系统: t507_android10_okt507_uart0_debug_V2.41.3.img MCU: center_control_mcu_2.37.6.bin 2.手机搭配测试app <iGarden> a、安卓 app 程序版本：1.0.0.24 b、苹果 app 程序版本：2.0.77 3.测试要求： A、此次为新产品整机测试,需搭配水泵,热泵,盐机,砂缸,手机app一起测试,具体组网接线等操作请参考《中控样机操作手册》 B、与其他系统使用RS485连接,如砂缸产品连接RS485需要设置为RS485模式方可使用,具体设置方法查看对应产品的规格书,如《沙缸头使用说明书V1.2版》 4.此次送样产品，请在2024.07.27前测试完成并给出相应测试报告。
一 | 资料外观检测 |  |  |  |  | □是 □否
资料核对 | 资料明细 |  | 确认结果 |  |  | 样品使用数量 | 完成日期 | 采购
二 | 电气性能检测 |  |  |  |  | □是 □否
需验证关键参数与检验方式 | 验证参数 |  | 测量结果 |  |  | 样品使用数量 | 完成日期 | 研发
三 | 结构装配检测 |  |  |  |  | □是 □否
结构装配和结论 | 验证参数 |  | 装配结论 |  |  | 样品使用数量 | 完成日期 | 研发
四 | 测试部验证 |  |  |  |  | □是 □否
整机测试重点参数与检验方式 | 验证参数 |  | 检验方式及结果 |  |  | 样品使用数量 | 完成日期 | 研发
样品确认判定 | □合格 物料编码： □不合格： |  |  |  |  | 审核：
 |  |  |  |  |  | 批准：
留样选择 | □样品检验确认留样
最终结果处理方式 | □ 下发试产单 | 试产数量(整机): 台 |  | 指定试产机型: □是 机型： □否(详见试产单)
 | □ 直接在系统中建立替代关系 □ 随新项目试产 □ 其它 _________________________
注：1、本单适用于在研项目的新物料导入确认，量产阶段的新物料导入使用《物料导入确认单》； 2、提交本单时原则上必须提供图纸作为附件，如无法提供需注明原因； 3、特殊情况需剪裁验证环节，至少需要研发中心与供应链中心会签； 4、此单发起时必须附带所勾选的附属技术资料，否则视为无效申请；
