Marksman124/inverjet/测试文档/蒋云峰/20240905__逆流器测试报告.xlsx

Sheet: 报告
inverjet 逆流器软件测试报告
 | 轮次： | 1
 | 报告编号： | 20240904-328
 | 测试： | 蒋云峰
 | 审核： | 吴庆光
 | 批准： | 于华平
 | 测试时间： | 2024年8月30日 2024年9月4日
 | 结论： | 不合格
广州安捷制造有限公司

Sheet: 测试任务书
测试任务书
项目信息
项目名称 | 逆流器 |  |  | 项目编号
机型型号 | SJ1200 |  |  | 开发阶段 | 设计评审
申请人 | 吴庆光 |  |  | 申请日期 | 2024年8月30日
测试项目
 | 全功能测试 |  | 功能更改点测试
变更内容
软件信息
名称 | 校验码 | 软件版本 | 程序编码 |  | 程序修改时间 | 硬件版本
inverjet逆流器 |  | 显示板V0.3 驱动板V3.67
测试依据
新逆流器规格书_v1.4_20240830 逆流器显示板软件自测报告—V1.1
照片

Sheet: 测试用例
逆流器软件测试用例
编制人：蒋云峰 |  | 编制日期：2024年9月4日
序号 | 测试项 | 测试标准（规格书） | 测试用例 | 判定 | 不符合现象 | 备注
1 | 按键与显示 | 新逆流器规格书_v1.4_20240830（第2.2 2.3功能点） | 1、上电后关机状态下连续点击模式键8次，逆流器开始显示自测，查看显示无异常 | 合格
 |  |  | 2、P0、1、2、3、4、5模式下更改运行速度查看显示无异常 | 合格
 |  |  | 3、定时模式下更改运行速度，运行时间查看显示无异常 | 合格
 |  |  | 4、上电后关机状态下连续点击模式键8次，逆流器开始显示自测，点击四个按键按键亮起且蜂鸣器伴随响起 | 合格
 |  |  | 5、P0、1、2、3、4、5模式下使用按键进行更改运行速度、进入定时模式、开关机、组合键配对wifi与蓝牙等操作，按键无异常且蜂鸣器响声无异常 | 合格
 |  |  | 6、定时模式下使用按键进行更改运行速度、进入其他模式、开关机、组合键配对wifi与蓝牙等操作，按键无异常且蜂鸣器响声无异常 | 合格
 |  |  | 7、关机状态下使用按键进行恢复出厂设置、更改参数等功能，按键无异常，显示无异常 | 合格
2 | 参数设置与恢复出厂设置 | ① 关机状态下，3 秒内连续按 8 次 键，系统恢复出厂设置。 ② 关机状态下，3 秒内连续按 8 次 键，进入参数设置菜单。每次均从第 1 项开始显示，按 键切换设置 项目；1 分钟无操作或按 键退出参数设置，退出时保存全部 | 1、关机状态下，3 秒内连续按 8 次模式键键，系统恢复出厂设置。查看默认运行P0档40%，查看P1、2、3、4、5档运行时间与运行速率恢复为默认值 | 合格
 |  |  | 2、首次上电重复上述1操作无异常 | 合格
 |  |  | 3、 关机状态下，3 秒内连续按 8 次定时键，进入参数设置菜单。点击模式键切换参数，参数轮询，长按无快速切换，点击档位键增加参数，点击定时键减少参数，长按快增快减。 | 合格
 |  |  | 4、参数1、2、3可调整退出参数设置后查看参数1、2、3已保存。 | 合格
3 | 模式切换 | 1、切换模式 点击模式键切换至训练模式参数选择状态，可选择 P1,P2,P3,P4,P5,P0（自由模式）。切换后 3 秒无操作进入 软启动。 2、切换模式 切换模式：点击定时模式键切换至定时模式。显示上次记忆的转速和时间。 | 1、恢复出厂设置后开机进入P0模式，点击模式键进行档位切换，P0、1、2、3、4、5轮询，切换为下一档位后等待5s开始运行 | 合格
 |  |  | 2、从P0、1、2、3、4、5档点击定时键进入定时模式查看过程无异常 | 合格
 |  |  | 3、从定时模式切换为P0、1、2、3、4、5模式查看无异常。 | 合格
 |  |  | 4、切换模式后关机再开机查看运行模式为自由模式P0 | 合格
 |  |  | 5、切换模式后断电再开机查看运行模式为自由模式P0 | 合格
4 | P0自由模式 | 开机后默认进入自由模式初始状态，默认流速 40%；3 秒内无操作系统自动运行自由模式；流速下方显示已运行时间 在自由模式初始状态或者运行状态下，点击流速档位键 即可更改流速，每次点击切换一档，共有五个档 位：20%、40%、60%、80%、100%依次切换； 选择完成后等待 3 秒无操作后，流速将调整至最后设置的档位流速。 | 1、P0模式下点击定时键直接进入定时模式，无法更改运行时间。 | 合格
 |  |  | 2、p0模式下点击档位键切换运行速度，运行速度为40% 60% 80% 100% 20%轮询，长按无快速切换无操作5s保存运行速度 | 合格
 |  |  | 3、运行99分60s后运行时间归零，重新开始计时 | 合格
 |  |  | 4、运行过程中点击关机键，运行与计时暂停再次点击开机键，运行与计时继续。暂停时间达到1小时后自动关机 | 合格
 |  |  | 5、运行过程中关机或者断电重启后继续运行P0模式。 | 合格
 |  |  | 6、运行过程中点击档位键切换运行速度5s后继续运行新的运行速度。 | 合格
5 | P1-P4训练模式 | 系统存有 4 种训练计划（P1,P2,P3,P4）和一种冲浪模式 P5，训练模式实际上是多段定时连在一起，通过不 同的流速配置指定更专业的训练计划 | 1、P1模式下点击定时键直接进入定时模式，无法更改运行时间。 | 合格
 |  |  | 2、P1模式下点击档位键切换运行速度，运行速度为40% 60% 80% 100% 20%轮询，长按无快速切换无操作5s保存运行速度 | 合格
 |  |  | 3、P1模式在运行到训练计划时间点时自动切换为对应的运行速度，在本时间段切换运行速度后下一时间段仍运行训练计划所设定的运行速度。 | 合格
 |  |  | 4、P1训练模式运行结束后进入暂停状态设备停机 | 合格
 |  |  | 5、P1模式运行过程中点击关机键，运行与计时暂停再次点击开机键，运行与计时继续。暂停时间达到1小时后自动关机 | 合格
 |  |  | 6、P1模式运行过程中关机或者断电重启后运行P0模式。 | 合格
 |  |  | 7、使用P2、3、4档重复上述操作无异常 | 合格
6 | P5冲浪模式 | 系统存有 4 种训练计划（P1,P2,P3,P4）和一种冲浪模式 P5，训练模式实际上是多段定时连在一起，通过不 同的流速配置指定更专业的训练计划 | 1、P5模式下点击定时键直接进入定时模式，无法更改运行时间。 | 合格
 |  |  | 2、P5模式下点击档位键无法切换运行速度。 | 合格
 |  |  | 3、P5模式在运行到训练计划时间点时自动切换为对应的运行速度. | 合格
 |  |  | 4、P5模式运行不会结束一致重复循环。 | 合格
 |  |  | 5、P1模式运行过程中点击关机键，运行与计时暂停再次点击开机键，运行与计时继续。暂停时间达到1小时后自动关机 | 合格
 |  |  | 6、P5模式运行过程中关机或者断电重启后运行P0模式。 | 合格
7 | 定时模式 | 在任意状态下点击定时键 ，系统进入定时模式设置状态，在该状态下 3 秒内无操作将开启定时模式；流 速下方显示定时时间，开始运行后进入倒数，当数到 0 时定时运行结束，运行结束后将闪烁显示定时模式的 运行时间和流速，3 秒后系统切换到自由模式初始状态 | 1、定时模式下点击定时键修改运行时间，15min、30min、45min、60min、90min轮询切换，长按无快速切换无操作5s保存运行时间 | 合格
 |  |  | 2、定时模式下点击档位键切换运行速度，运行速度为40% 60% 80% 100% 20%轮询，长按无快速切换无操作5s保存运行速度 | 合格
 |  |  | 3、运行时间结束后进入暂停状态，倒计时停止设备运行停止 | 合格
 |  |  | 4、运行过程中点击关机键，运行与计时暂停再次点击开机键，运行与计时继续。暂停时间达到1小时后自动关机 | 合格
 |  |  | 5、运行过程中关机或者断电重启后继续运行P0模式。 | 合格
 |  |  | 6、运行过程中点击档位键切换运行速度5s后继续运行新的运行速度，点击定时键切换运行时间5s后继续运行新的运行时间。

Sheet: 问题汇总表
逆流器测试问题汇总
产品型号 |  | 逆流器 | 编制日期 |  | 2024年9月4日
软件版本 |  | 显示板V0.3 驱动板V3.67 | 编制人 |  | 蒋云峰
序号 | 功能点 | 规格书功能描述 | 测试点 | 问题等级 | 问题描述及测试步骤 | 分析及建议 | 测试人员 | 测试时间 | 开发答复方案 | 备注
1 | 按键操作 |  | 单点 | P1 | 按下按键逆流器就会做出反应而不是松开，容易出现误触 | 建议修改为抬起后触发生效 | 蒋云峰 | 2024-08-30 | 采纳建议，V1.0版本已改为抬起后触发生效
2 | 参数设置 |  | 参数退出 | P2 | 参数设置未操作时间到达1min后不会退出 | 永远不会退出，功能缺失 | 蒋云峰 | 2024-08-30 | 程序问题，已在V1.0版本更改
3 | wifi控制 |  | wifi控制 | P0 | wifi功能无法使用 | 功能暂无 | 蒋云峰 | 2024-08-30 | 该功能暂不支持
4 | 蓝牙控制 |  | 蓝牙控制 | P0 | 蓝牙功能无法使用 | 功能暂无 | 蒋云峰 | 2024-08-30 | 该功能暂不支持
5 | 485控制 |  | 485控制 | P0 | 485功能无法使用 | 功能暂无 | 蒋云峰 | 2024-08-30 | 该功能暂不支持
6 | 暂停 | ① 任意模式下长按开关键 3 秒系统进入关机状态，关机状态下仅开关键 可操作，其它按键均 无效； ② 暂停状态下连续 30 分钟内无操作，系统将自动关机； | 暂停自动关机 | P2 | 暂停30min后未自动关机，1小时才关机 | 与规格书不符 | 蒋云峰 | 2024-08-30 | 程序问题，已在V1.0版本更改
7 | 暂停 | ① 任意模式下长按开关键 3 秒系统进入关机状态，关机状态下仅开关键 可操作，其它按键均 无效； ② 暂停状态下连续 30 分钟内无操作，系统将自动关机； | 暂停自动关机 | P1 | 暂停一小时后关机，出现设备关机，屏幕仍在显示的问题 | 程序bug屏幕显示刷新放在了关机之后，导致关机后屏幕重新亮起 | 蒋云峰 | 2024-08-30 | 程序BUG，出现在关机后主线程仍然能进一次刷新界面，已在V1.0版本更改
8 | 参数设置 |  | 参数退出 | P1 | 参数设置，点击开机键保存后设置会直接开机且显示在运行但实际未运行 | 建议最好显示为0%因为当前未运行，或者改为闪烁提示未运行 | 蒋云峰 | 2024-08-30 | 该界面为产品定义，暂不更改
9 | 恢复出厂设置 |  | 恢复出厂设置 | P1 | 恢复出厂设置，会直接开机且显示在运行但实际未运行 | 建议修改为恢复出厂设置后不开机做一个全显示操作提醒用户 | 蒋云峰 | 2024-08-30 | 采纳建议，V1.0版本已改为全显2s然后关机
10 | p5冲浪模式 |  | 运行速度 | P1 | 冲浪模式显示30%，实际为100%与0%交替运行，与规格书不符 | 程序bug | 蒋云峰 | 2024-08-30 | 程序问题，已在V1.0版本更改，速度为100%与30%交替
11 | 训练模式 |  | 训练结束 | P1 | 训练模式P1、2、3、4结束后进入P0显示40%但却未运行 | 建议最好显示为0%因为当前未运行，或者改为闪烁提示未运行 | 蒋云峰 | 2024-09-02 | 该界面为产品定义，暂不更改
12 | 档位切换 |  | 定时模式切换 | P3 | 点击模式键从定时模式切换为普通档位，只会切换为P1不会记住之前档位。 | 建议退出定时模式后要么返回进入时的模式，要么运行P0默认档位 | 蒋云峰 | 2024-09-03 | 该界面为产品定义，暂不更改
13 | 运行参数 |  | 开始运行 | P3 | 无操作后5s才开始运行而非规格书描述的3s | 与规格书不符 | 蒋云峰 | 2024-09-03 | 程序问题，已在V1.0版本更改
