Marksman124/inverjet/(list of files, cad)

Other CAD files:
原理图/屏幕/VA-BT62613AMN.dwg
原理图/屏幕/VA-BT62613AMN-1.dwg
