Marksman124/inverjet/协议/wifi模组/模组调试数据.txt

sn：      1828246860813438978

55 AA 00 0B 01 04 00 00 00 00 08 41 00 20 DD 81 00 08 C5 DD 
00 08 39 CB 00 08 F5 D7 00 08 15 93 00 08 59 F1 00 08 00 00 
00 00 00 00 00 00 00 00 00 00 00 00 00 00 45 81 00 08 D5 96 
00 08 00 00 00 00 89 81 00 08 11 E2 00 08 F7 81 00 08 F7 81 
00 08 F7 81 00 08 F7 81 00 08 F7 81 00 08 F7 81 00 08 F7 81 
00 08 F7 81 00 08 F7 81 00 08 F7 81 00 08 F7 81 00 08 F7 81 
00 08 F7 81 00 08 6D 96 00 08 F7 81 00 08 F7 81 00 08 F7 81 
00 08 F7 81 00 08 F7 81 00 08 F7 81 00 08 F7 81 00 08 F7 81 
00 08 F7 81 00 08 F7 81 00 08 F7 81 00 08 8D E4 00 08 F7 81 
00 08 F7 81 00 08 F7 81 00 08 F7 81 00 08 99 E4 00 08 F7 81 
00 08 F7 81 00 08 F7 81 00 08 F7 81 00 08 F7 81 00 08 F7 81 
00 08 49 F0 00 08 81 F0 00 08 8D F0 00 08 F7 81 00 08 F7 81 
00 08 F7 81 00 08 F7 81 00 08 F7 81 00 08 F7 81 00 08 F7 81 
00 08 F7 81 00 08 00

第 1 包

55aa000b01040000000008410020dd810008c5dd000839cb0008f5d700081593000859f100080000000000000000000000000000000045810008d5960008000000008981000811e20008f7810008f7810008f7810008f7810008f7810008f7810008f7810008f7810008f7810008f7810008f7810008f7810008f78100086d960008f7810008f7810008f7810008f7810008f7810008f7810008f7810008f7810008f7810008f7810008f78100088de40008f7810008f7810008f7810008f781000899e40008f7810008f7810008f7810008f7810008f7810008f781000849f0000881f000088df00008f7810008f7810008f7810008f7810008f7810008f7810008f7810008f781000800

第 2 包

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

第 164 包

55aa000b010400000000141458021e140c03142a84e301a9122d12b41a37c4122d14e001461cd0022dc4123714fc032d03acb0041246142c0150141c024614580255144803461c840350c4124603acdc05122d14a4014114a0052d03bc080702c71e1a01ca0942cc1816b0046009c012802539090108850a0108310b0108e1041e8308010887041adf181ae3041a890c1ae5081a2d1c1add041a81101a85041add141ae1040910a01202120312041c010102031814020203020103020303030403050306030703fd441e390c01086b041a81041af3101af7041a2f0c1a33041af90c1a35081a69041a6d041af1101af5041a2d0c1a31049170655f066b2f363d7d077f3ff560d3f266b6fe

结束包

55aa000b010400000000b7e0f7f6774159437945714676480e4a584c5f4f73503d535e557c6268636e6474684069646e6c6f60724c75e7419543974587466748704a154cf54fc750b653755537621363736427680169236e336f03723175138c1282208b1c130cb9f810080204080305060a45100140801908115a010832024a0810180a610e0108190d010895041a0d0c1a87d41a8d041a11101a15041abd0c1a17081a91041ae9041a83101a89041a0d0c1a1304012a12011203126112621263127092710b10fc15c0f1b594
