Marksman124/inverjet/原理图/屏幕/VA-BT62613AMN Model.pdf

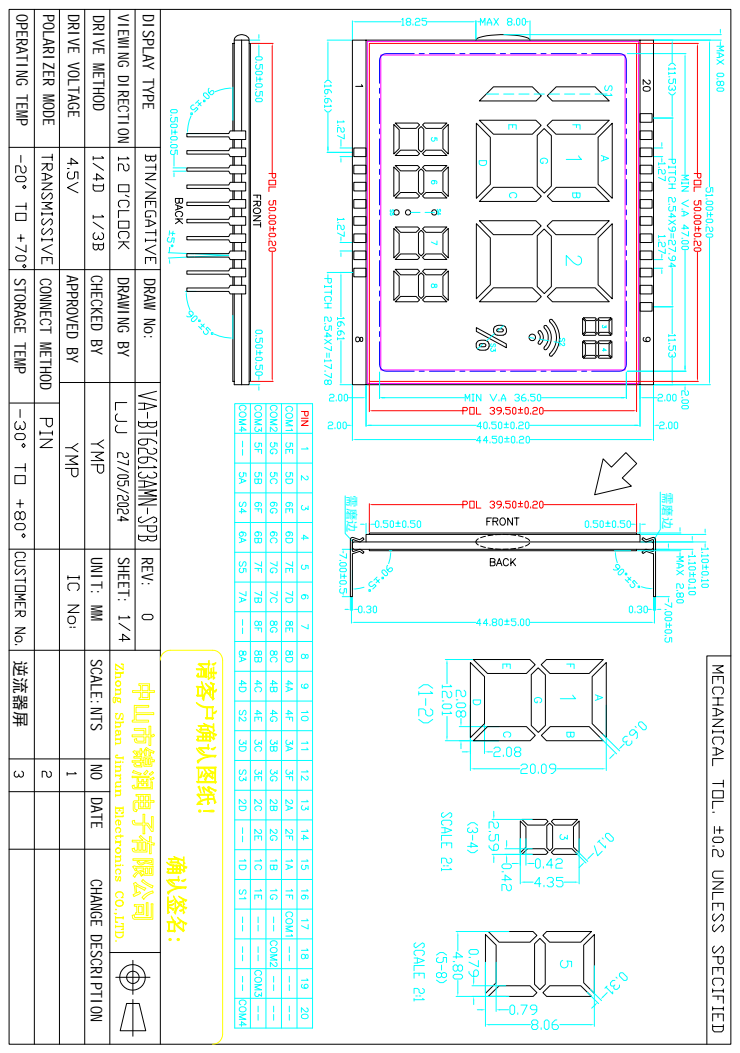
[picture p226: page 1]
POLARIZER MODE; OPERATING TEMP; DRIVE VOLTAGE; DRIVE METHOD; VIEWING DIRECTION; DISPLAY TYPE; STORAGE TEMP; CONNECT METHOD; DRAWING BY; APPROVED BY; CHECKED BY; DRAW No:; SHEET:; UNIT: MM; REV:; NO DATE; 需磨边; 逆流器屏

CHANGE DESCRIPTION SCALE:NTS

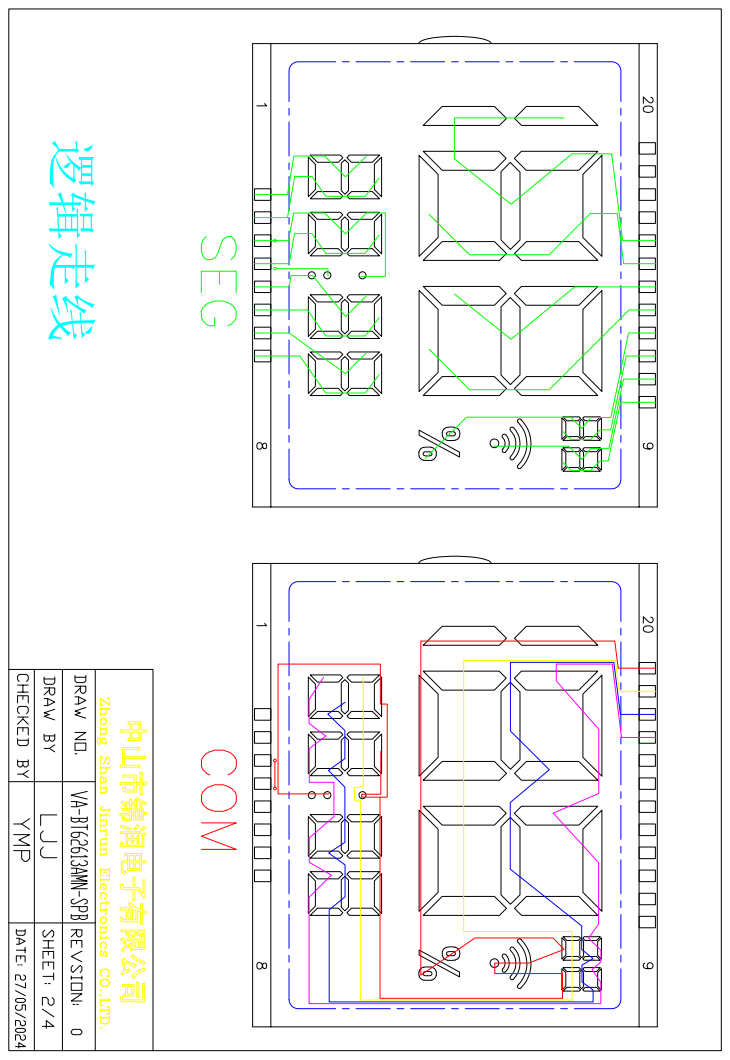
[picture p227: page 2]
逻辑走线

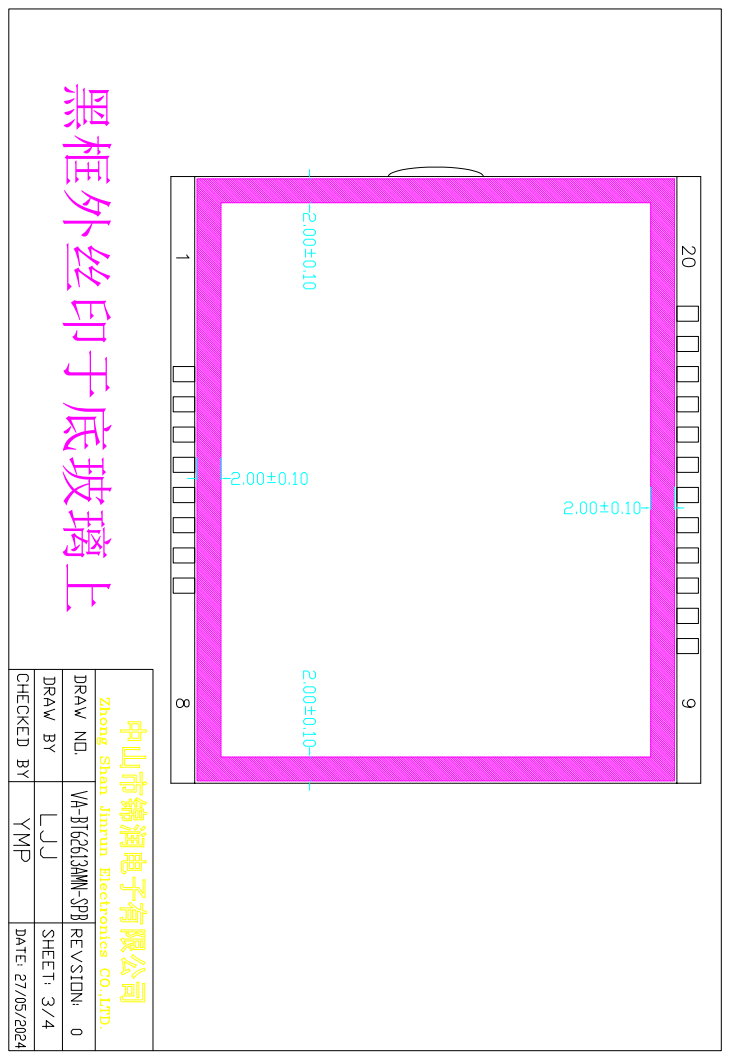
[picture p228: page 3]
黑框外丝印于底玻璃上

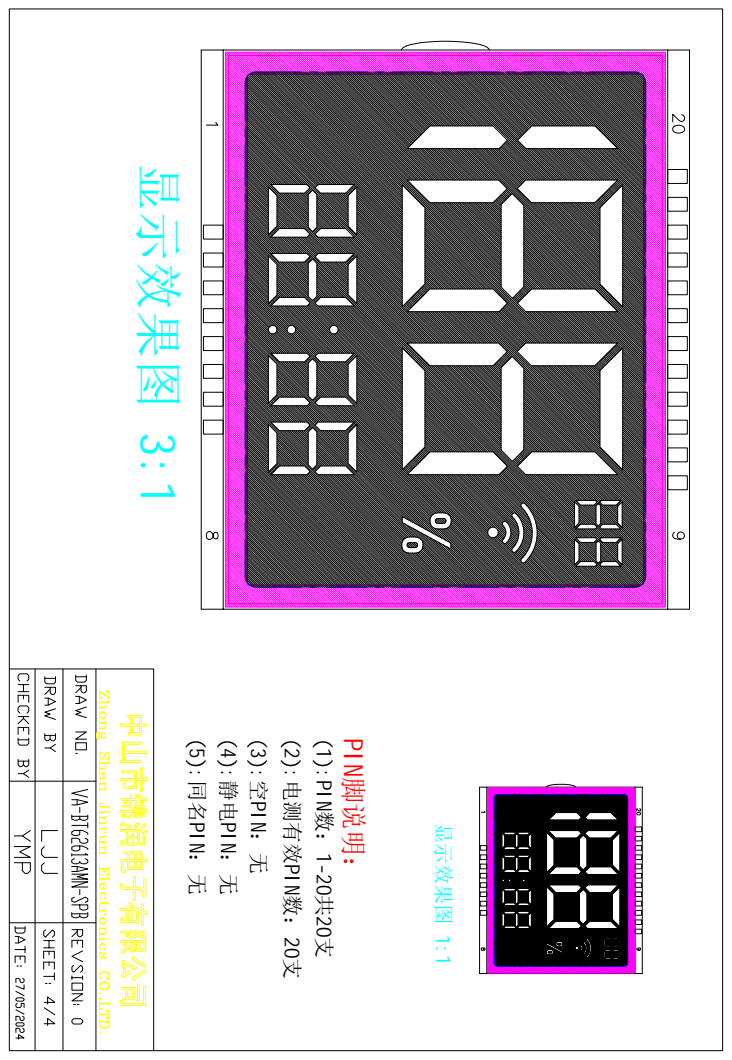
[picture p229: page 4]
PIN脚; (1):PIN数：1-20共; 测 有 效 PIN数：20支; PIN：无; 电 PIN：无; 名 PIN：无
