Marksman124/inverjet/原理图/屏幕/VA-BT62613AMN-1 Model.pdf

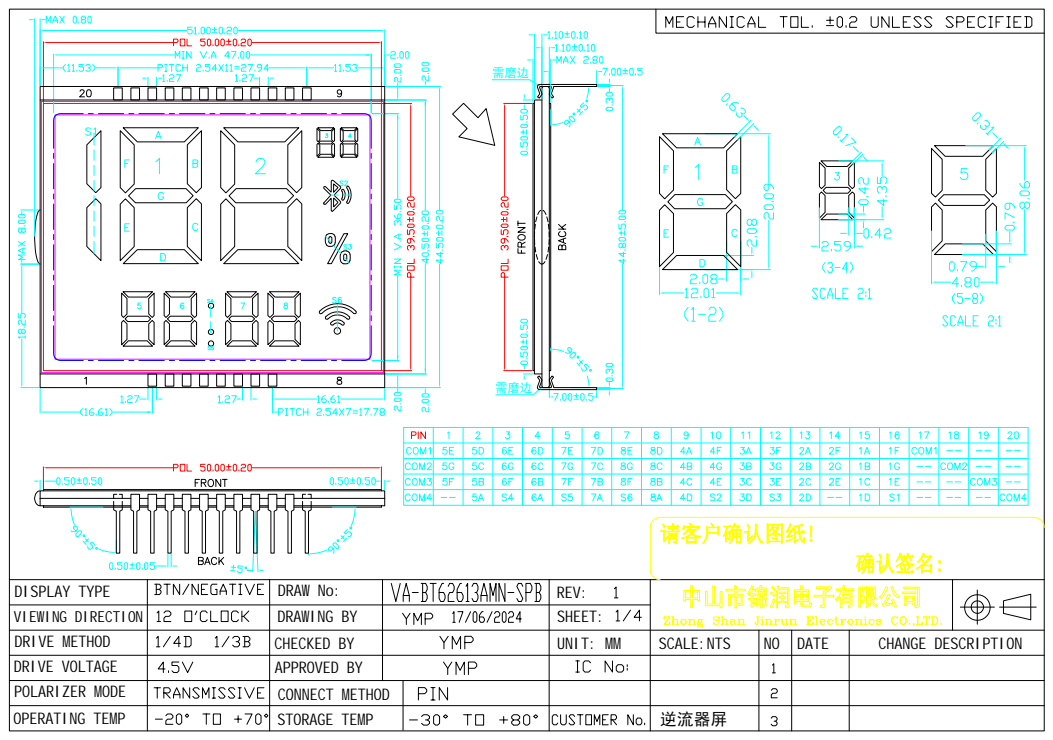
[picture p230: page 1]
SHEET:; REV:; 需磨边; 逆流器屏

DISPLAY TYPE | | | | DRAW No:
VIEWING DIRECTION | | | | | DRAWING BY
DRIVE METHOD | | CHECKED BY | UNIT: MM SCALE:NTS | NO | DATE | CHANGE DESCRIPTION
DRIVE VOLTAGE | APPROVED BY
POLARIZER MODE | | CONNECT METHOD
OPERATING TEMP | | STORAGE TEMP

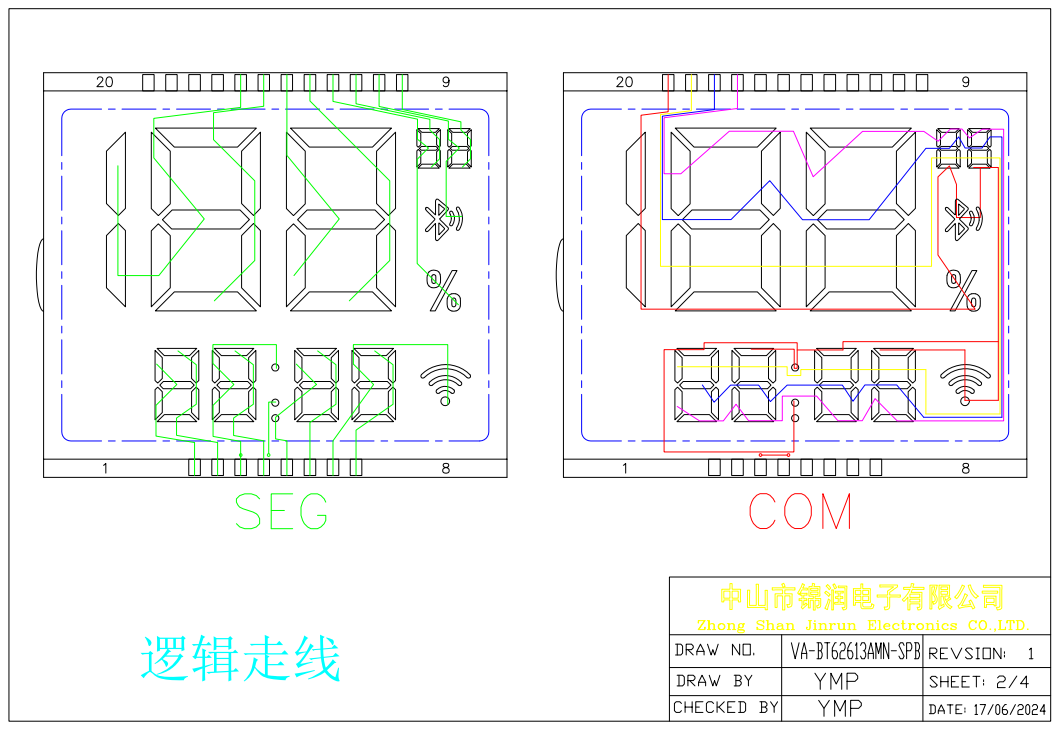
[picture p231: page 2]

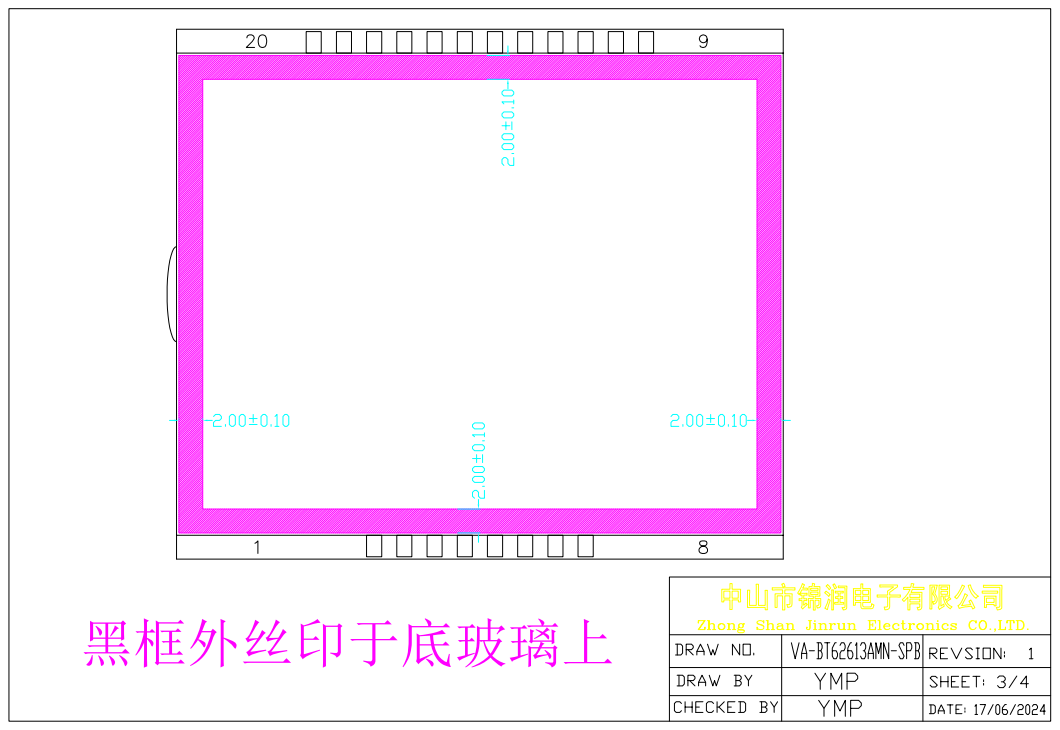
[picture p232: page 3]
黑框外丝印于底玻璃上

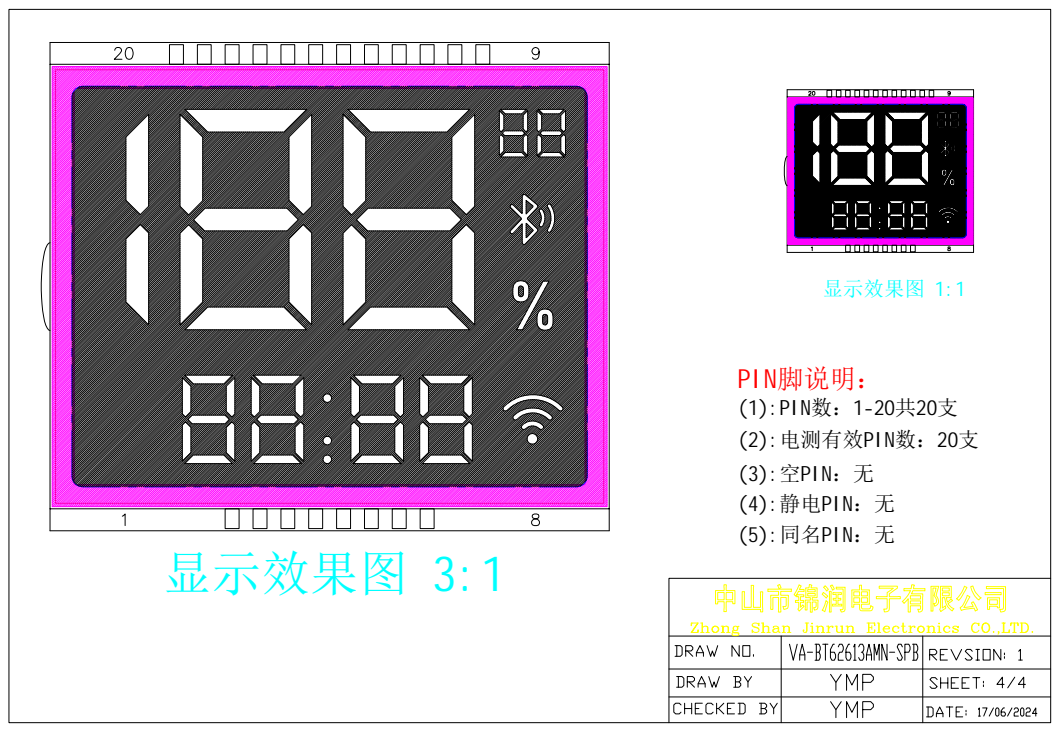
[picture p233: page 4]
PIN脚; (1):PIN数：1-20共; PIN数：20支; PIN：无
