Marksman124/inverjet/原理图/显示板(APQLCD003 V3.1)_原理图文件.pdf

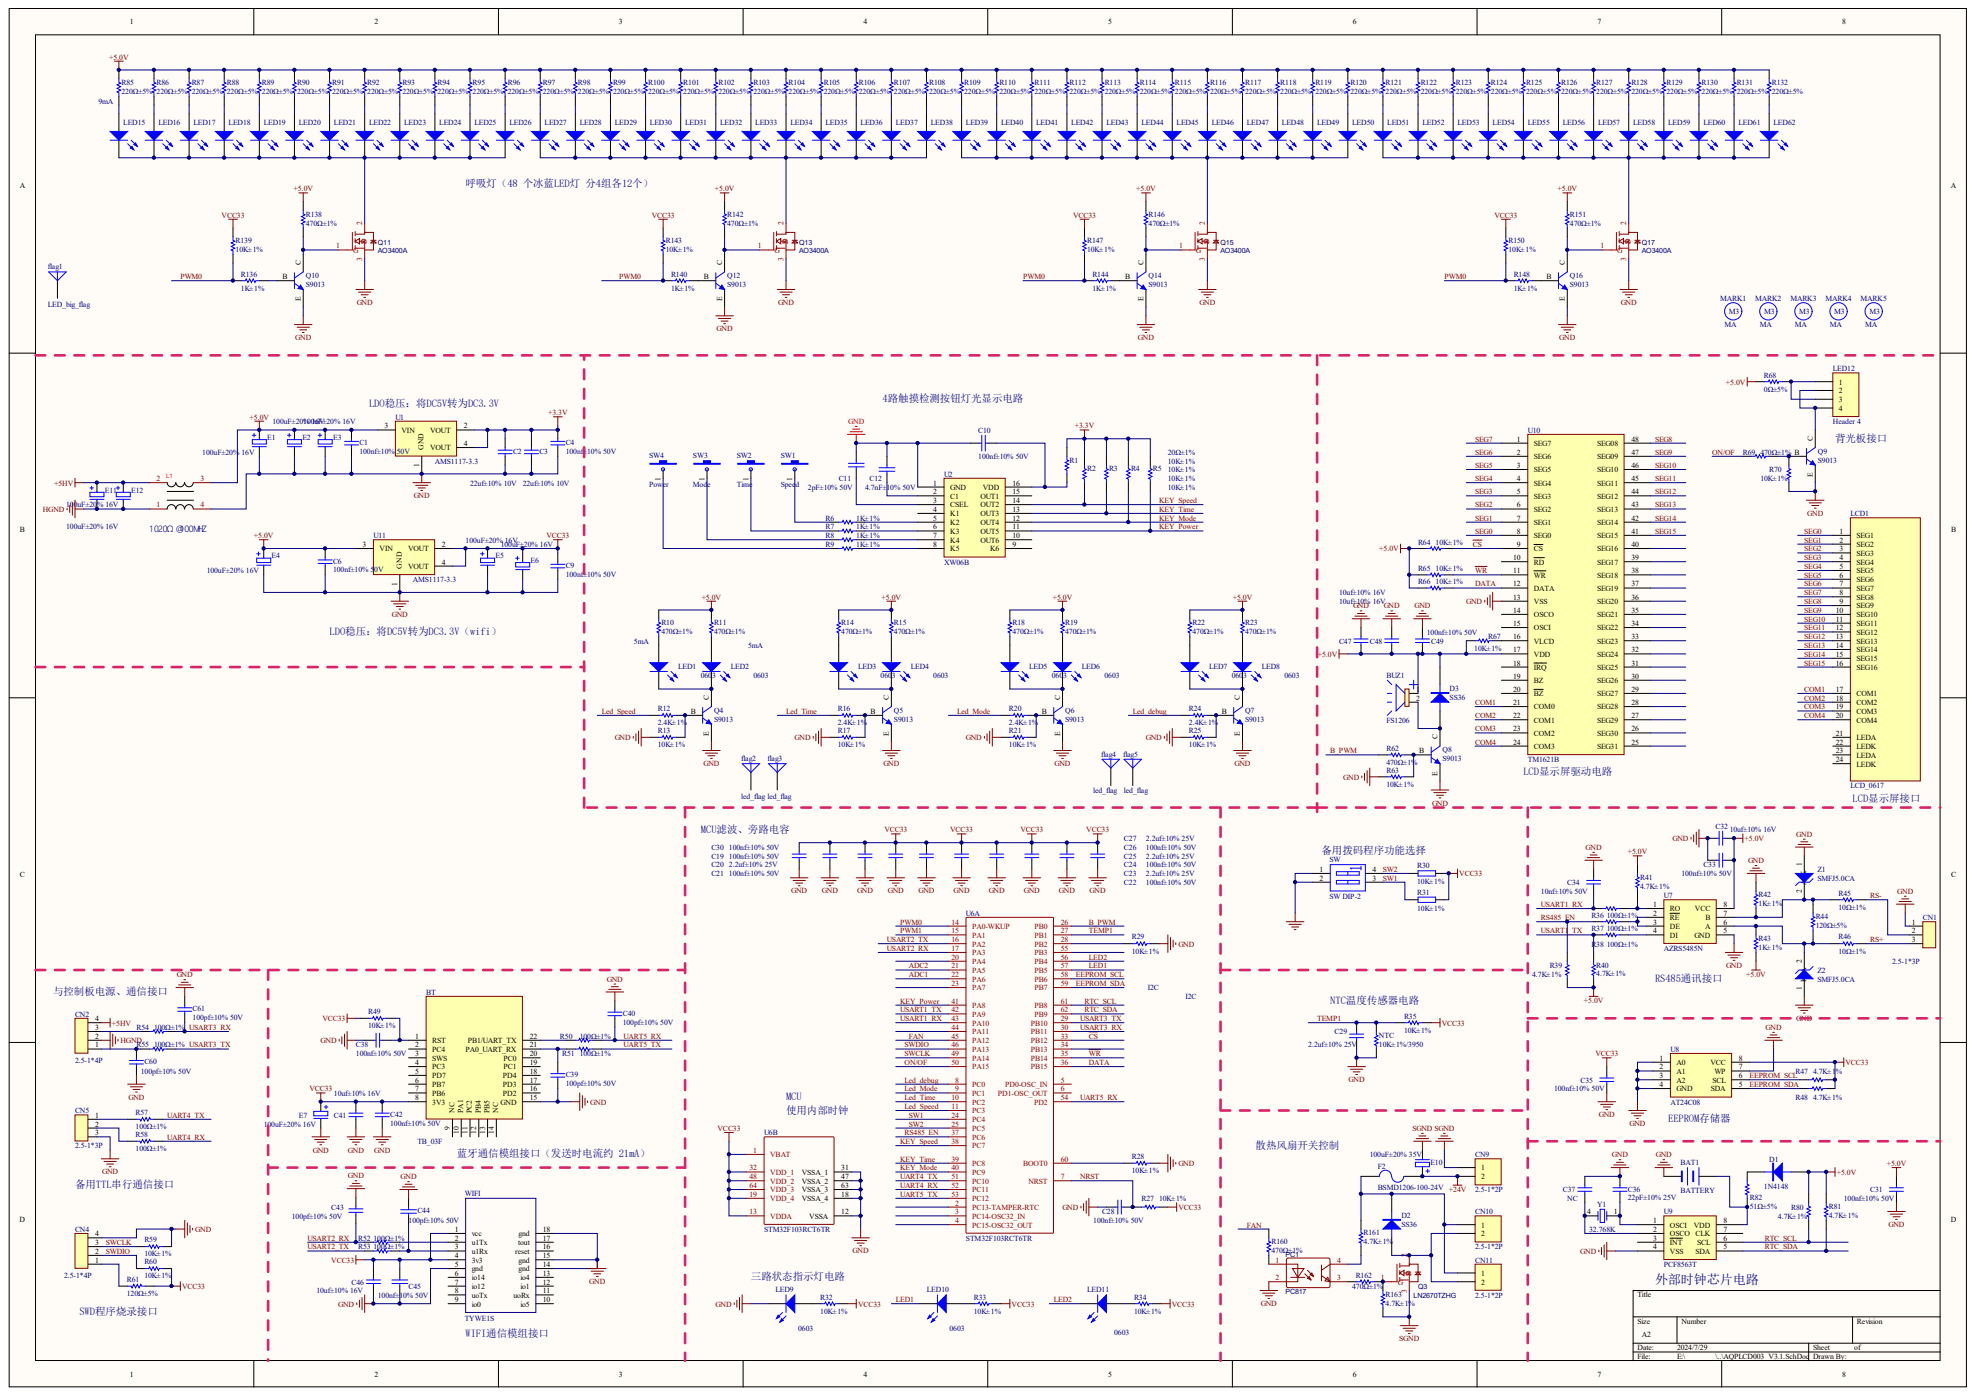
[picture p234: page 1]
