Marksman124/inverjet/原理图/逆流器显示板原理图_0704.pdf

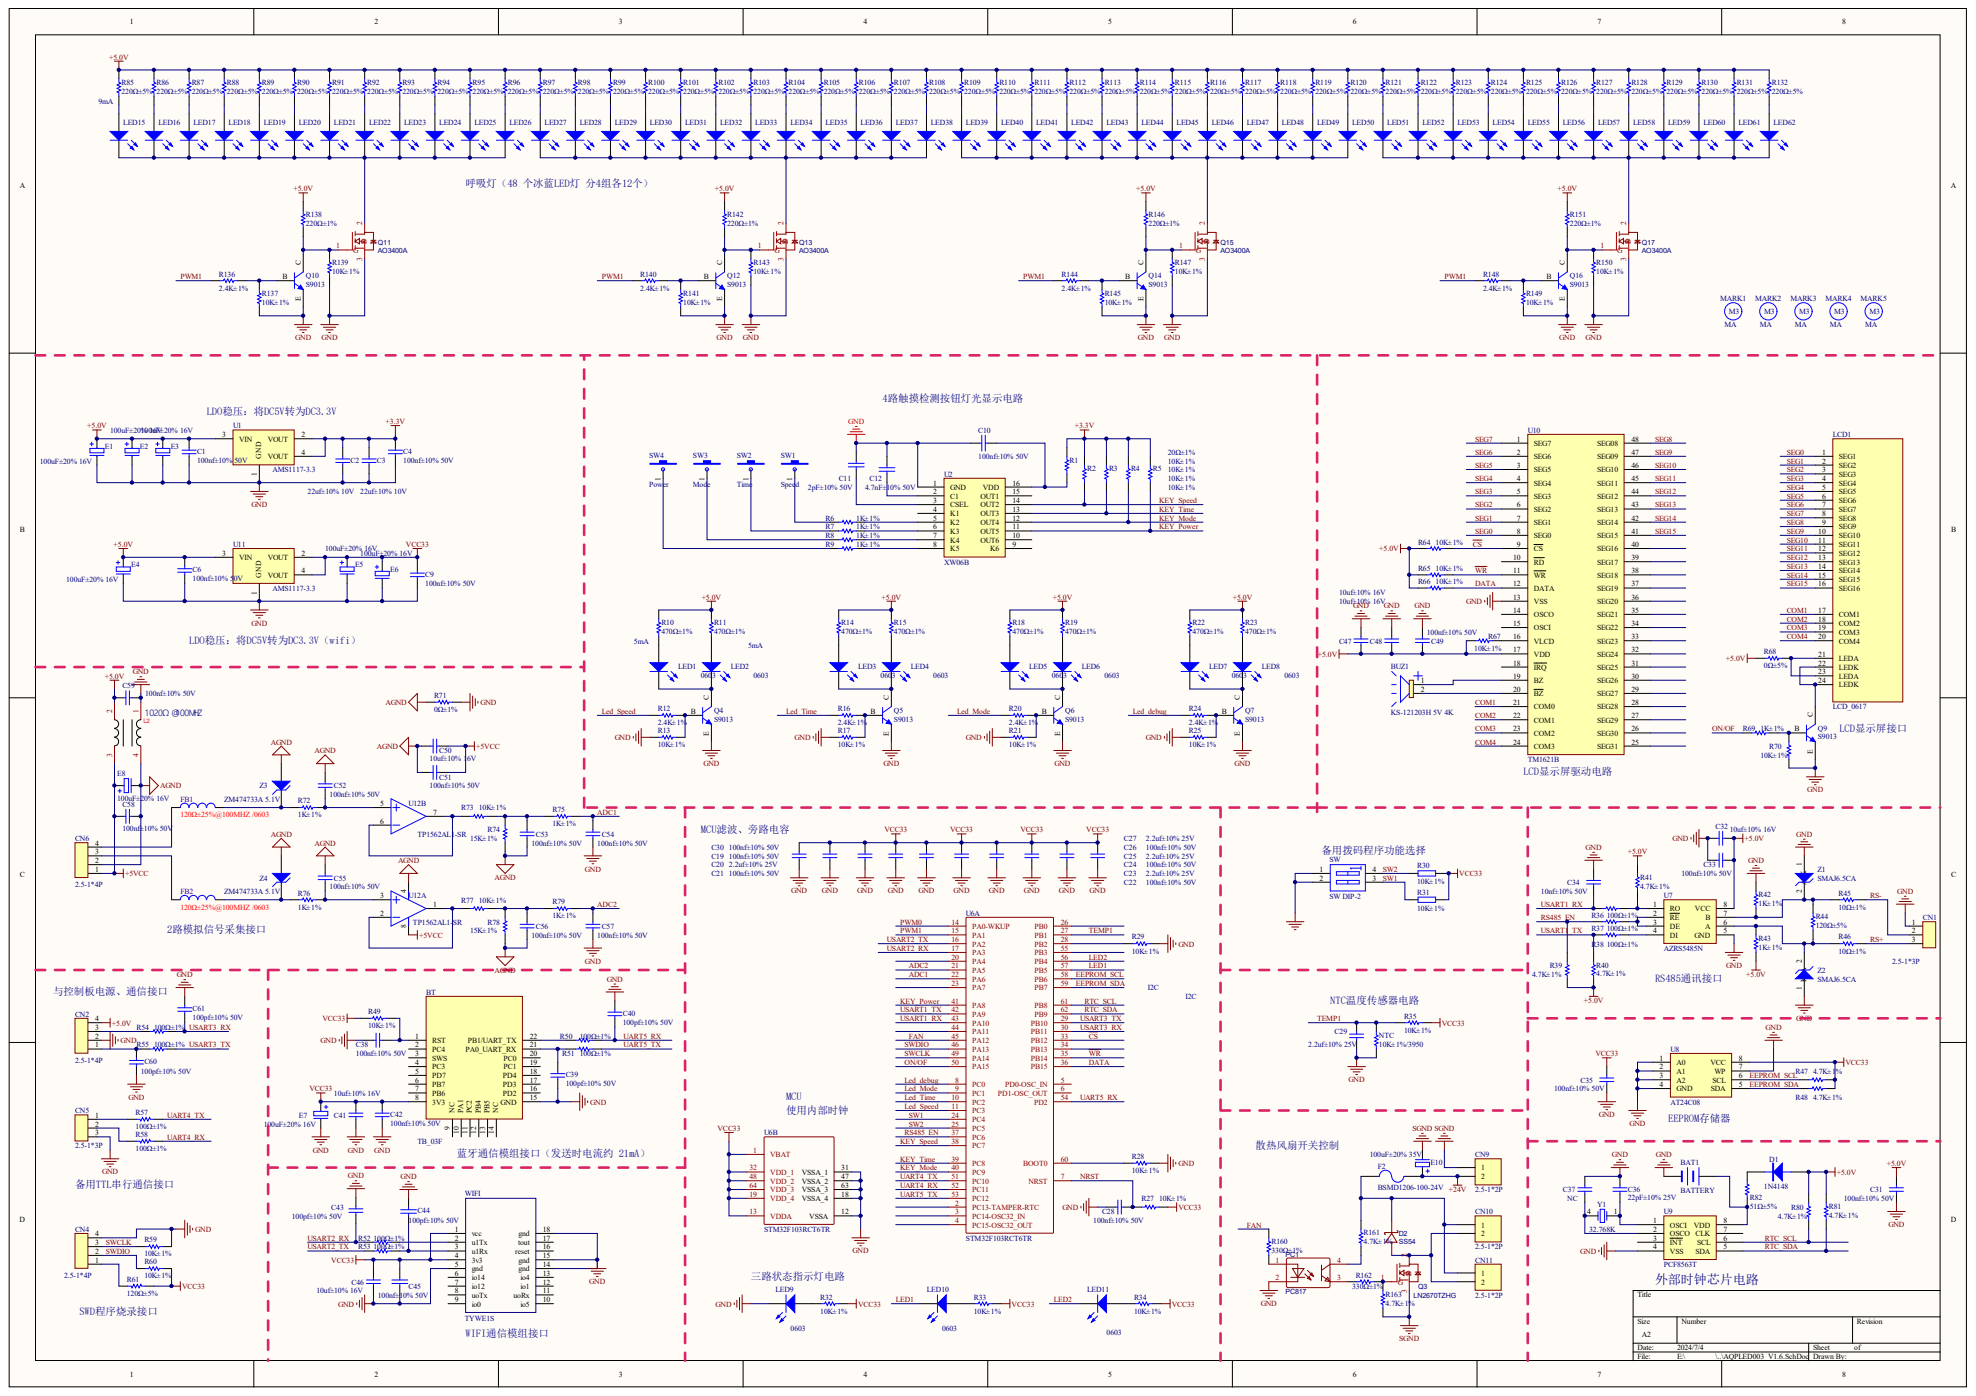
[picture p235: page 1]
