Marksman124/inverjet/inverjet_app/Core/Thread/motor.c

/**
******************************************************************************
* @file				motor.c
* @brief			电机 相关协议  控制转速命令 200ms  《老郭版》
*
* @author			WQG
* @versions		v1.0
* @date				2024-6-15
******************************************************************************
*/

/* Includes ------------------------------------------------------------------*/
#include "motor.h"
#include "debug_protocol.h"
#include "math.h"
#include "fault.h"
#include "timing.h"
#include "down_conversion.h"

/* Private includes ----------------------------------------------------------*/


/* Private typedef -----------------------------------------------------------*/

#if (MOTOR_MODULE_HUART == 3)//驱动板串口 UART句柄
UART_HandleTypeDef* p_huart_motor = &huart3;
#elif (MOTOR_MODULE_HUART == 1)
UART_HandleTypeDef* p_huart_motor = &huart1;
#elif (MOTOR_MODULE_HUART == 4)
UART_HandleTypeDef* p_huart_motor = &huart4;
#endif

/* Private define ------------------------------------------------------------*/

/* Private variables ---------------------------------------------------------*/

//**************** 收发缓冲区
uint8_t Motor_DMABuff[MOTOR_RS485_RX_BUFF_SIZE]={0};//定义一个接收缓存区
uint8_t Motor_TxBuff[MOTOR_RS485_TX_BUFF_SIZE]={0};//定义一个发送缓存区

uint8_t Motor_Speed_Now = 0;			// 电机转速 

uint8_t Motor_Speed_Target = 0;

static uint16_t Motor_Timer_Cnt=0;

//uint16_t* p_Speed_Mode; 

uint16_t Motor_Fault_State=0;//电机故障状态

static uint32_t Motor_Rx_Timer_cnt= 0;

static uint32_t Motor_Fault_Timer_cnt= 0;			// 故障计数器


//#if (MOTOR_DEVICE_PROTOCOL_VERSION == MOTOR_DEVICE_HARDWARE_TEMP001)
static uint8_t Rx_State= 0;		//从机接收状态
//#endif

static uint8_t Motor_Start_Flag = 0; 		// 启动标志
static uint16_t Motor_Start_Timer = 0; 	// 启动计时

static uint8_t Motor_ReStart_Cnt = 0; 			// 重启计数
static uint8_t Motor_ReStart_Flag = 0; 			// 重启标志
static uint16_t Motor_ReStart_Timer = 0; 		// 重启计时


static uint16_t Motor_Fault_Old = 0;
static uint8_t Motor_Loss_Cnt = 0;
	
#ifdef SYSTEM_DRIVER_BOARD_TOOL
static uint32_t Motor_Mode_Register = 0;
#endif
/* Private macro -------------------------------------------------------------*/
#define MOTOR_SPEED_STEPPING			(1)

#define GET_IN_START_UP_STAGE()				Motor_Start_Flag = 1;Motor_Start_Timer = 0
#define GET_OUT_START_UP_STAGE()			Motor_Start_Flag = 0;Motor_ReStart_Cnt=0;Motor_ReStart_Flag = 0;Motor_Start_Timer = 0
#define	IS_IN_START_UP_STAGE()				(Motor_Start_Flag ==1)

#define GET_IN_WAIT_RESTART_STAGE()				if((Motor_ReStart_Cnt < 3)&&(Motor_ReStart_Flag==0)){Motor_ReStart_Flag=1;Motor_ReStart_Timer=0;Motor_Start_Timer=0;Motor_ReStart_Cnt++;}
#define GET_OUT_WAIT_RESTART_STAGE()			Motor_ReStart_Flag = 0
#define	IS_IN_WAIT_RESTART_STAGE()				(Motor_ReStart_Flag ==1)
	
/* Private user code ---------------------------------------------------------*/

// 初始化
void Metering_Receive_Init(void)
{
	
	//p_Speed_Mode = Get_DataAddr_Pointer(MB_FUNC_READ_HOLDING_REGISTER, MB_MOTOR_SPEED_MODE );
	//__HAL_UART_ENABLE_IT(p_Metering_Module_Huart, UART_IT_RXNE); //使能IDLE中断
	__HAL_UART_ENABLE_IT(p_huart_motor, UART_IT_IDLE);//使能idle中断
	__HAL_UART_ENABLE_IT(p_huart_motor, UART_IT_ERR);//
	
  HAL_UARTEx_ReceiveToIdle_DMA(p_huart_motor,Motor_DMABuff,MOTOR_RS485_RX_BUFF_SIZE);//打开串口DMA接收
	__HAL_DMA_DISABLE_IT(&hdma_usart3_rx, DMA_IT_HT);		   // 手动关闭DMA_IT_HT中断
}
uint8_t If_Start_Up_Stable(void)
{
	uint8_t result = 0;
	
	if((System_Dial_Switch & 0x08)==0)//郭工
	{
		if(Motor_Start_Timer < 2)
			result = 1;
	}
	else
	{
		if(Motor_Start_Timer < 5)
			result = 1;
	}	
	return result;
}

uint8_t If_Start_Up_Finish(void)
{
	uint8_t result = 0;
	
	if((System_Dial_Switch & 0x08)==0)//郭工
	{
		if(Motor_Start_Timer > 20)
			result = 1;
	}
	else
	{
		if(Motor_Start_Timer > 50)
			result = 1;
	}
	
	return result;
}

// 重启等待时间
uint8_t If_Wait_Restart_Finish(void)
{
	uint8_t result = 0;
	
	if((System_Dial_Switch & 0x08)==0)//郭工
	{
		if(Motor_Start_Timer > 10)
			result = 1;
	}
	else
	{
		if(Motor_Start_Timer > 10)
			result = 1;
	}
	
	return result;
}
// 重启
void Motor_Usart_Restar(void)
{
	if(HAL_UART_DeInit(&huart3) != HAL_OK)
  {
    Error_Handler();
  }
  
  // 重新打开串口
  MX_USART3_UART_Init();
	Metering_Receive_Init();
}


// 清除故障
void Clean_Motor_OffLine_Timer(void)
{
	Motor_Rx_Timer_cnt = 0;
	
	Motor_Fault_State = 0;
}

// 1秒 执行函数
void Motor_Function_In_One_Second(void)
{
	if(IS_IN_START_UP_STAGE())
		Motor_Start_Timer ++;
	if(IS_IN_WAIT_RESTART_STAGE())
		Motor_ReStart_Timer ++;
	
	if(If_Start_Up_Finish())
	{
		GET_OUT_START_UP_STAGE();
	}
	if(If_Wait_Restart_Finish())
	{
		GET_OUT_WAIT_RESTART_STAGE();
	}
}

//------------------- 主循环函数  ----------------------------
void App_Motor_Handler(void)
{
	Thread_Activity_Sign_Set(THREAD_ACTIVITY_MOTOR);
	
	//通信故障计数器
	Motor_Rx_Timer_cnt++;  //不报故障 记得删  wuqingguang 2024-09-09
	
	if(Motor_Timer_Cnt < 9999)
		Motor_Timer_Cnt ++;
	else
		Motor_Timer_Cnt = 0;
	
	// ===================  通讯故障
#ifndef SYSTEM_DEBUG_MODE
	if(IS_CHECK_ERROR_MODE())
	{
		if(Motor_Rx_Timer_cnt > (FAULT_MOTOR_LOSS_TIME/3))
		{
			Set_Motor_Fault_State( E203_MOTOR_LOSS );							//驱动板 通讯故障
		}
	}
	else
	{
		if(Motor_Rx_Timer_cnt > FAULT_MOTOR_LOSS_TIME)
		{
			Set_Motor_Fault_State( E203_MOTOR_LOSS );							//驱动板 通讯故障
		}
	}
#endif
	// ===================  尝试重启串口
	if( ((Motor_Rx_Timer_cnt % FAULT_MOTOR_TRY_RESTAR_TIME)==0) && (Motor_Rx_Timer_cnt >= FAULT_MOTOR_TRY_RESTAR_TIME))
	{
		DEBUG_PRINT("[ERROR]\t驱动板通讯故障 cnt:\t%d\t重启串口\n",Motor_Rx_Timer_cnt);
		Motor_Usart_Restar();
	}
	if(MOTOR_DEVICE_PROTOCOL_VERSION == MOTOR_DEVICE_HARDWARE_AQPED002)
	{
	//↓↓↓↓↓↓↓↓↓↓↓↓↓↓↓↓↓↓↓↓↓↓↓↓↓↓↓↓↓↓↓↓↓↓↓↓↓↓↓↓↓↓↓↓↓↓↓↓↓↓
		//*********************************************************************************************
		//* ------ 郭工驱动板 ------ *******************************************************************
		//*********************************************************************************************
		
		// ===================  设置转速
		if((Motor_Timer_Cnt % MOTOR_POLLING_PERIOD)==MOTOR_COMMAND_CYCLE)
		{
#ifdef SYSTEM_DRIVER_BOARD_TOOL
			if(Motor_Mode_Register != 2)//&&(System_Dial_Switch == 15))
			{
				Motor_GetIn_TestMode();
			}
			else
#endif
			{
				//设置转速
				Motor_Speed_Update();
			}
		}
		// ===================  读状态
		else if((Motor_Timer_Cnt % MOTOR_POLLING_PERIOD) == MOTOR_READ_STATIC_CYCLE)
		{
				//读状态  1 s
				Motor_Read_Register();
		}
		// ===================  心跳
		else if((Motor_Timer_Cnt % MOTOR_POLLING_PERIOD) == MOTOR_HEARTBEAT_CYCLE)
		{
			//发心跳
			if((Motor_Speed_Now != 0))//驱动板要求  停机后不发心跳
			{
				//心跳 200ms
				Motor_Heartbeat_Send();
			}
		}
	//↑↑↑↑↑↑↑↑↑↑↑↑↑↑↑↑↑↑↑↑↑↑↑↑↑↑↑↑↑↑↑↑↑↑↑↑↑↑↑↑↑↑↑↑↑↑↑↑↑↑
	}
	else if(MOTOR_DEVICE_PROTOCOL_VERSION == MOTOR_DEVICE_HARDWARE_TEMP001)
	{
	//↓↓↓↓↓↓↓↓↓↓↓↓↓↓↓↓↓↓↓↓↓↓↓↓↓↓↓↓↓↓↓↓↓↓↓↓↓↓↓↓↓↓↓↓↓↓↓↓↓↓
		//*********************************************************************************************
		//* ------ 蓝工驱动板 ------ *******************************************************************
		//*********************************************************************************************
		if(Rx_State == 1)	// 接收
		{
			//Rx_State = 2;
			Motor_State_Analysis();
	//	}
	//	else if(Rx_State == 2)	// 回复
	//	{
			Rx_State = 0;
			Motor_Speed_Update();
		}
	//↑↑↑↑↑↑↑↑↑↑↑↑↑↑↑↑↑↑↑↑↑↑↑↑↑↑↑↑↑↑↑↑↑↑↑↑↑↑↑↑↑↑↑↑↑↑↑↑↑↑
	}
}

//------------------- 同步电机转速 ----------------------------
// 持续发
uint8_t Motor_Speed_Update(void)
{
	uint8_t result=1;
	uint8_t Motor_Acceleration=0;
	
	if((Get_System_State_Machine() == TRAINING_MODE_RUNNING)&&(PMode_Now == 5)&&(OP_ShowNow.time > 10))					// 训练 P5
		Motor_Acceleration = *p_Surf_Mode_Info_Acceleration;
	else
		Motor_Acceleration = MOTOR_ACCELERATION;
	
	
	if( Motor_Speed_Now > Motor_Speed_Target )
	{
		if((Motor_Speed_Target == 0) && (Motor_Speed_Now <= MOTOR_ACTUAL_SPEED_MIN))// 最低直接关
		{
			Motor_Speed_Now = 0;
		}
		else
		{
			if((Motor_Speed_Target + Motor_Acceleration) < Motor_Speed_Now)
				Motor_Speed_Now -= Motor_Acceleration;
			else
				Motor_Speed_Now = Motor_Speed_Target;
		}
		result = 1;
	}
	else if( Motor_Speed_Now < Motor_Speed_Target )
	{
		if(IS_IN_START_UP_STAGE() && If_Start_Up_Stable())
		{
			Motor_Speed_Now = MOTOR_ACTUAL_SPEED_MIN;
		}
		else if(IS_IN_WAIT_RESTART_STAGE())
		{
			Motor_Speed_Now = 0;
		}
		else if((Motor_Speed_Now == 0) && (Motor_Speed_Target >= MOTOR_ACTUAL_SPEED_MIN))// 最低直接开
		{
			Motor_Speed_Now = MOTOR_ACTUAL_SPEED_MIN;
			GET_IN_START_UP_STAGE();
		}
		else
		{
			if((Motor_Speed_Now + Motor_Acceleration) < Motor_Speed_Target)
				Motor_Speed_Now += Motor_Acceleration;
			else
				Motor_Speed_Now = Motor_Speed_Target;
		}
		result = 1;
	}
	else
	{
		result = 0;
	}
	if(MOTOR_DEVICE_PROTOCOL_VERSION == MOTOR_DEVICE_HARDWARE_AQPED002)
	{
		// 驱动板要求, 停机后不要再发控制指令
		if((Motor_Speed_Now == 0)&&(result == 0))
			return result;
	}
	
	*p_Send_Reality_Speed = Motor_Speed_To_Rpm(Motor_Speed_Now);
	//发送 驱动板
	Motor_Speed_Send(*p_Send_Reality_Speed);
	
	if(result == 1)
	{
		//测试发送串口
		DEBUG_PRINT("电气转速:\t%d\t\t转速:\t%d\t档位:\t%d%%\n",*p_Send_Reality_Speed,*p_Send_Reality_Speed/5,Motor_Speed_Now);
	}
	
	return result;
}

//------------------- 电机转速是否达到目标值 ----------------------------
uint8_t Motor_Speed_Is_Reach(void)
{
	if(Motor_Speed_Now == Motor_Speed_Target)
		return 1;
	else
		return 0;
}

//------------------- 电机转速 目标值 设置 ----------------------------
void Motor_Speed_Target_Set(uint8_t speed)
{
	if(speed > MOTOR_PERCENT_SPEED_MAX)
		speed = MOTOR_PERCENT_SPEED_MAX;
	
	if((speed < MOTOR_PERCENT_SPEED_MIX) && (speed > 0))
		speed = MOTOR_PERCENT_SPEED_MIX;

	if(Motor_Speed_Target != speed)
		Special_Status_Add(SPECIAL_BIT_SKIP_STARTING);//光圈自动判断
	
	Motor_Speed_Target = speed;
}

//------------------- 电机 快速停止 ----------------------------
void Motor_Quick_Stop(void)
{
	if(Motor_Speed_Target != 0)
		Special_Status_Add(SPECIAL_BIT_SKIP_STARTING);//光圈自动判断
	
	Motor_Speed_Target = 0;
	Motor_Speed_Now = 1;
}

//------------------- 电机转速 目标值 设置 ----------------------------
uint8_t Motor_Speed_Target_Get(void)
{
	return Motor_Speed_Target;

}
//------------------- 百分比功率 转 电机转速 ----------------------------
// 100% -->  1960 rpm
// P2/P1=(N2/N1)^3=(Q2/Q1)^3=(V1/V2)^3

uint32_t Motor_Speed_To_Rpm(uint8_t speed)
{
	double speed_rpm;
	double p = 1.0;
	double a = 1.0;
	
	if(speed > 100)
		speed = 100;
	//功率 百分比
//	p = (double)speed/100;
//  a = pow(p, 1.0 / 3);
//	
//	a = a*MOTOR_RPM_SPEED_MAX;
//	
//	speed_rpm = (uint32_t)(a);

	//转速百分比
	//speed_rpm = speed*MOTOR_RPM_CONVERSION_COEFFICIENT;
	if(speed < MOTOR_PERCENT_SPEED_MIX)
	{
		speed_rpm = speed*(MOTOR_RPM_SPEED_MIX/MOTOR_PERCENT_SPEED_MIX);
	}
	else if(speed == MOTOR_PERCENT_SPEED_MIX)
		speed_rpm = MOTOR_RPM_SPEED_MIX;
	else if(speed == MOTOR_PERCENT_SPEED_MAX)
		speed_rpm = MOTOR_RPM_SPEED_MAX;
	else
	{
		p = MOTOR_RPM_CONVERSION_COEFFICIENT;
		a = MOTOR_RPM_CONVERSION_COEFFICIENT_20;
		
		speed_rpm = (((speed-MOTOR_PERCENT_SPEED_MIX)/MOTOR_PERCENT_SPEED_MIX)*a) + ((speed%MOTOR_PERCENT_SPEED_MIX)*p)+ MOTOR_RPM_SPEED_MIX;			
	}
	
	return (uint32_t)speed_rpm;
}

uint8_t Motor_Rpm_To_Speed(uint32_t speed_rpm)
{
	uint32_t speed;
	
	if(speed_rpm > MOTOR_RPM_SPEED_MAX)
		return MOTOR_PERCENT_SPEED_MAX;

	if(speed_rpm < MOTOR_RPM_SPEED_MIX)
	{
		speed = speed_rpm/(MOTOR_RPM_SPEED_MIX/MOTOR_PERCENT_SPEED_MIX);
	}
	else if(speed_rpm == MOTOR_RPM_SPEED_MIX)
		speed = MOTOR_PERCENT_SPEED_MIX;
	else if(speed_rpm == MOTOR_RPM_SPEED_MAX)
		speed = MOTOR_PERCENT_SPEED_MAX;
	else
	{
		speed = MOTOR_PERCENT_SPEED_MIX + ((speed_rpm-MOTOR_RPM_SPEED_MIX)*80/(MOTOR_RPM_SPEED_MAX - MOTOR_RPM_SPEED_MIX));
	}
	
	return (speed&0xFF);
}

//------------------- 故障类型转换 ----------------------------
uint16_t Change_Faule_To_Upper(uint16_t type)
{
	uint16_t change_fault=0;
	
	if(type == 0)
		return 0;
	
	if(MOTOR_DEVICE_PROTOCOL_VERSION == MOTOR_DEVICE_HARDWARE_AQPED002)
	{
	//↓↓↓↓↓↓↓↓↓↓↓↓↓↓↓↓↓↓↓↓↓↓↓↓↓↓↓↓↓↓↓↓↓↓↓↓↓↓↓↓↓↓↓↓↓↓↓↓↓↓
		//if((type >= MOTOR_FAULT_CODE_START) && (type <= MOTOR_FAULT_CODE_END))
		if(type > 0)
		{
			if((type == MOTOR_FAULT_OVER_VOLTAGE ) || (type == MOTOR_FAULT_UNDER_VOLTAGE ))	//-----------母线电压 过压 | 欠压 01 02
				change_fault = E001_BUS_VOLTAGE_ABNORMAL;
			
			else if(type == MOTOR_FAULT_ABS_OVER_CURRENT)			//----------- 过流  04
				change_fault = E002_BUS_CURRENT_ABNORMAL;
			
			else if((type >= MOTOR_FAULT_HIGH_OFFSET_CURRENT_SENSOR_1) && (type <= MOTOR_FAULT_UNBALANCED_CURRENTS ) )//-----------输出三相电流不平衡  15 - 18
				change_fault = E003_BUS_CURRENT_BIAS;
			
			else if(type == MOTOR_FAULT_DRV)		//-----------短路  03
				change_fault = E004_ABNORMAL_SHORT_CIRCUIT;
			// ------ 不报上电缺相
			else if((type >= MOTOR_FAULT_OUTPUT_PHASE_A_LOSS_RUNNING) && (type <= MOTOR_FAULT_OUTPUT_PHASE_2_AND3_LOSS_RUNNING ) )//----------- 缺相 34 - 37
				change_fault = E005_LACK_PHASE;
			
			else if(type == MOTOR_FAULT_OUTPUT_LOCKROTOR)		//-----------堵转  38
				change_fault = E006_LOCK_ROTOR;
			
			else if(type == MOTOR_FAULT_OVER_TEMP_FET)			//----------- MOS 过热 05
				change_fault = E101_TEMPERATURE_MOS;

			else if((type >= MOTOR_FAULT_OUTPUT_PHASE_A_SENSOR) && (type <= MOTOR_FAULT_OUTPUT_PHASE_C_SENSOR ) )//----------- 缺相 传感器
				change_fault = E005_LACK_PHASE;
			
			else if(type == MOTOR_FAULT_MOSFET_NTC_ERR)			//----------- MOS 传感器故障 39
				change_fault = E201_TEMPERATURE_HARDWARE;
			
			else if(type == MOTOR_FAULT_IDLING_ERROR)			//----------- 空转 39
			{
				change_fault = E007_IDLING_ERROR;
				Fault_Restar_Set(1);
			}
			//----------- 其它 故障
			else
				change_fault = E202_MOTOR_DRIVER;
		}
	//↑↑↑↑↑↑↑↑↑↑↑↑↑↑↑↑↑↑↑↑↑↑↑↑↑↑↑↑↑↑↑↑↑↑↑↑↑↑↑↑↑↑↑↑↑↑↑↑↑↑
	}
	else if(MOTOR_DEVICE_PROTOCOL_VERSION == MOTOR_DEVICE_HARDWARE_TEMP001)
	{
	//↓↓↓↓↓↓↓↓↓↓↓↓↓↓↓↓↓↓↓↓↓↓↓↓↓↓↓↓↓↓↓↓↓↓↓↓↓↓↓↓↓↓↓↓↓↓↓↓↓↓
		//母线电压异常
		if(type & TEMP001_MOTOR_FAULT_BUS_VOLTAGE_ERROR)
			change_fault |= E001_BUS_VOLTAGE_ABNORMAL;
		
		//硬件故障
		if(type & TEMP001_MOTOR_FAULT_MOSFET_TEMP_HARDWARE)
			change_fault |= E201_TEMPERATURE_HARDWARE;
		
		//通信故障
		if(type & TEMP001_MOTOR_FAULT_COMM_FAULT)
			change_fault |= E203_MOTOR_LOSS;
			
		//mos temp over
		if(type & TEMP001_MOTOR_FAULT_TEMP_OVER)
			change_fault |= E101_TEMPERATURE_MOS;
		
		//偏置异常
		if(type & TEMP001_MOTOR_FAULT_BUS_CIRCUIT_BIAS)
			change_fault |= E003_BUS_CURRENT_BIAS;
		
		//硬件过流  --短路
		if(type & TEMP001_MOTOR_FAULT_HARDWARE_OVERCURRENT)
			change_fault |= E004_ABNORMAL_SHORT_CIRCUIT;
		
		//输出过流
		if(type & TEMP001_MOTOR_FAULT_OUTPUT_OVERCURRENT)
			change_fault |= E002_BUS_CURRENT_ABNORMAL;
		
		//缺相
		if(type & TEMP001_MOTOR_FAULT_LACK_PHASE)
			change_fault |= E005_LACK_PHASE;
		
		// 空转
		if(type & TEMP001_MOTOR_FAULT_IDLING_ERROR)
		{
			change_fault |= E007_IDLING_ERROR;
			Fault_Restar_Set(1);
		}
		
		//else
		if((type & TEMP001_MOTOR_FAULT_OUT_STEP_FAULT)||(type & TEMP001_MOTOR_FAULT_STARTUP_FAILED)|| (type & TEMP001_MOTOR_FAULT_BRIDGE_HARDWARE))
			change_fault |= E202_MOTOR_DRIVER;
		
	//↑↑↑↑↑↑↑↑↑↑↑↑↑↑↑↑↑↑↑↑↑↑↑↑↑↑↑↑↑↑↑↑↑↑↑↑↑↑↑↑↑↑↑↑↑↑↑↑↑↑
	}
	
	return change_fault;
}

/*-------------------- 收发处理 ----------------------------------------------*/
// crc16-XMODEM
uint16_t CRC16_XMODEM_T(uint8_t *ptr, uint16_t len)
{
    const uint16_t crc_table[256] = {
        0x0000, 0x1021, 0x2042, 0x3063, 0x4084, 0x50a5, 0x60c6, 0x70e7,
        0x8108, 0x9129, 0xa14a, 0xb16b, 0xc18c, 0xd1ad, 0xe1ce, 0xf1ef,
        0x1231, 0x0210, 0x3273, 0x2252, 0x52b5, 0x4294, 0x72f7, 0x62d6,
        0x9339, 0x8318, 0xb37b, 0xa35a, 0xd3bd, 0xc39c, 0xf3ff, 0xe3de,
        0x2462, 0x3443, 0x0420, 0x1401, 0x64e6, 0x74c7, 0x44a4, 0x5485,
        0xa56a, 0xb54b, 0x8528, 0x9509, 0xe5ee, 0xf5cf, 0xc5ac, 0xd58d,
        0x3653, 0x2672, 0x1611, 0x0630, 0x76d7, 0x66f6, 0x5695, 0x46b4,
        0xb75b, 0xa77a, 0x9719, 0x8738, 0xf7df, 0xe7fe, 0xd79d, 0xc7bc,
        0x48c4, 0x58e5, 0x6886, 0x78a7, 0x0840, 0x1861, 0x2802, 0x3823,
        0xc9cc, 0xd9ed, 0xe98e, 0xf9af, 0x8948, 0x9969, 0xa90a, 0xb92b,
        0x5af5, 0x4ad4, 0x7ab7, 0x6a96, 0x1a71, 0x0a50, 0x3a33, 0x2a12,
        0xdbfd, 0xcbdc, 0xfbbf, 0xeb9e, 0x9b79, 0x8b58, 0xbb3b, 0xab1a,
        0x6ca6, 0x7c87, 0x4ce4, 0x5cc5, 0x2c22, 0x3c03, 0x0c60, 0x1c41,
        0xedae, 0xfd8f, 0xcdec, 0xddcd, 0xad2a, 0xbd0b, 0x8d68, 0x9d49,
        0x7e97, 0x6eb6, 0x5ed5, 0x4ef4, 0x3e13, 0x2e32, 0x1e51, 0x0e70,
        0xff9f, 0xefbe, 0xdfdd, 0xcffc, 0xbf1b, 0xaf3a, 0x9f59, 0x8f78,
        0x9188, 0x81a9, 0xb1ca, 0xa1eb, 0xd10c, 0xc12d, 0xf14e, 0xe16f,
        0x1080, 0x00a1, 0x30c2, 0x20e3, 0x5004, 0x4025, 0x7046, 0x6067,
        0x83b9, 0x9398, 0xa3fb, 0xb3da, 0xc33d, 0xd31c, 0xe37f, 0xf35e,
        0x02b1, 0x1290, 0x22f3, 0x32d2, 0x4235, 0x5214, 0x6277, 0x7256,
        0xb5ea, 0xa5cb, 0x95a8, 0x8589, 0xf56e, 0xe54f, 0xd52c, 0xc50d,
        0x34e2, 0x24c3, 0x14a0, 0x0481, 0x7466, 0x6447, 0x5424, 0x4405,
        0xa7db, 0xb7fa, 0x8799, 0x97b8, 0xe75f, 0xf77e, 0xc71d, 0xd73c,
        0x26d3, 0x36f2, 0x0691, 0x16b0, 0x6657, 0x7676, 0x4615, 0x5634,
        0xd94c, 0xc96d, 0xf90e, 0xe92f, 0x99c8, 0x89e9, 0xb98a, 0xa9ab,
        0x5844, 0x4865, 0x7806, 0x6827, 0x18c0, 0x08e1, 0x3882, 0x28a3,
        0xcb7d, 0xdb5c, 0xeb3f, 0xfb1e, 0x8bf9, 0x9bd8, 0xabbb, 0xbb9a,
        0x4a75, 0x5a54, 0x6a37, 0x7a16, 0x0af1, 0x1ad0, 0x2ab3, 0x3a92,
        0xfd2e, 0xed0f, 0xdd6c, 0xcd4d, 0xbdaa, 0xad8b, 0x9de8, 0x8dc9,
        0x7c26, 0x6c07, 0x5c64, 0x4c45, 0x3ca2, 0x2c83, 0x1ce0, 0x0cc1,
        0xef1f, 0xff3e, 0xcf5d, 0xdf7c, 0xaf9b, 0xbfba, 0x8fd9, 0x9ff8,
        0x6e17, 0x7e36, 0x4e55, 0x5e74, 0x2e93, 0x3eb2, 0x0ed1, 0x1ef0
    };

    uint16_t crc = 0x0000;
    
    while(len--) 
    {
        crc = (crc << 8) ^ crc_table[(crc >> 8 ^ *ptr++) & 0xff];
    }
    
    return(crc);
}

// 校验和 取反
uint8_t CRC8_ADD(uint8_t *ptr, uint16_t len)
{
	uint8_t crc = 0x00;
    
    while(len--) 
    {
        crc = (crc + *ptr++);
    }

#ifdef SYSTEM_DEBUG_MODE
		return(crc);
#else
		return(~crc);
#endif
}

//-------------------- 电机状态解析 ----------------------------
//↓↓↓↓↓↓↓↓↓↓↓↓↓↓↓↓↓↓↓↓↓↓↓↓↓↓↓↓↓↓↓↓↓↓↓↓↓↓↓↓↓↓↓↓↓↓↓↓↓↓
void AQPED002_Motor_State_Analysis(void)
{
	uint16_t result_fault=0;
	short int Temperature=0;
	int16_t ntc_tmp[3]={0};
		
	if(Get_Motor_Fault_State()&E203_MOTOR_LOSS)
	{
		if(Motor_Loss_Cnt < 2)
		{
			if(Motor_Rx_Timer_cnt < (MOTOR_THREAD_ONE_SECOND*3))
				Motor_Loss_Cnt++;
			else
				Motor_Loss_Cnt = 0;
			Motor_Rx_Timer_cnt = 0;
			return;
		}
		else
		{
			//驱动板 通讯故障 恢复
			ReSet_Motor_Fault_State(E203_MOTOR_LOSS);
			Motor_Loss_Cnt = 0;
		}
	}
	
	Motor_Rx_Timer_cnt = 0;
	//
	// 滤波后的mosfet温度
	Temperature = Motor_State_Storage[MOTOR_ADDR_MOSFET_TEMP_OFFSET]<<8 | Motor_State_Storage[MOTOR_ADDR_MOSFET_TEMP_OFFSET+1];
	//memcpy(p_Mos_Temperature, &Temperature, 2);
	*p_Mos_Temperature = Temperature;
	// 滤波后的电机温度 改用 软件版本
	Driver_Software_Version_Read = Motor_State_Storage[MOTOR_ADDR_MOTOR_TEMP_OFFSET]<<8 | Motor_State_Storage[MOTOR_ADDR_MOTOR_TEMP_OFFSET+1];

	Set_DataAddr_Value(MB_FUNC_READ_INPUT_REGISTER , MB_DRIVER_SOFTWARE_VERSION_HIGH, Driver_Software_Version_Read/100);
	Set_DataAddr_Value(MB_FUNC_READ_INPUT_REGISTER , MB_DRIVER_SOFTWARE_VERSION_LOW, Driver_Software_Version_Read%100);
	// 电机平均电流
	double mosfet_current = Motor_State_Storage[MOTOR_ADDR_MOTOR_CURRENT_OFFSET]<<24 |Motor_State_Storage[MOTOR_ADDR_MOTOR_CURRENT_OFFSET+1]<<16 |Motor_State_Storage[MOTOR_ADDR_MOTOR_CURRENT_OFFSET+2]<<8 | Motor_State_Storage[MOTOR_ADDR_MOTOR_CURRENT_OFFSET+3];
	*p_Motor_Current = (uint16_t)(mosfet_current/1.4);
	// 当前电气转速erpm
	*p_Motor_Reality_Speed = Motor_State_Storage[MOTOR_ADDR_MOTOR_SPEED_OFFSET]<<24 |Motor_State_Storage[MOTOR_ADDR_MOTOR_SPEED_OFFSET+1]<<16 |Motor_State_Storage[MOTOR_ADDR_MOTOR_SPEED_OFFSET+2]<<8 | Motor_State_Storage[MOTOR_ADDR_MOTOR_SPEED_OFFSET+3];
	*p_Motor_Reality_Speed = *p_Motor_Reality_Speed / MOTOR_POLE_NUMBER;
	// 母线电压
	*p_Motor_Bus_Voltage = Motor_State_Storage[MOTOR_ADDR_BUS_VOLTAGE_OFFSET]<<8 | Motor_State_Storage[MOTOR_ADDR_BUS_VOLTAGE_OFFSET+1];
	// 母线电流  没有检测
	*p_Motor_Bus_Current = 0;
	// 获取电机故障
	*p_Motor_Fault_Static = Motor_State_Storage[MOTOR_ADDR_MOTOR_FAULT_OFFSET];
#ifdef SYSTEM_DRIVER_BOARD_TOOL	
	// 获取电机模式状态
	Motor_Mode_Register = Motor_State_Storage[MOTOR_ADDR_MOTOR_MODE_OFFSET]<<24 |Motor_State_Storage[MOTOR_ADDR_MOTOR_MODE_OFFSET+1]<<16 |Motor_State_Storage[MOTOR_ADDR_MOTOR_MODE_OFFSET+2]<<8 | Motor_State_Storage[MOTOR_ADDR_MOTOR_MODE_OFFSET+3];
#endif
	// 10KNTC温度1 2 3
	ntc_tmp[0] = Motor_State_Storage[MOTOR_ADDR_NTC1_TEMP_OFFSET]<<8 | Motor_State_Storage[MOTOR_ADDR_NTC1_TEMP_OFFSET+1];
	ntc_tmp[1] = Motor_State_Storage[MOTOR_ADDR_NTC2_TEMP_OFFSET]<<8 | Motor_State_Storage[MOTOR_ADDR_NTC2_TEMP_OFFSET+1];
	ntc_tmp[2] = Motor_State_Storage[MOTOR_ADDR_NTC3_TEMP_OFFSET]<<8 | Motor_State_Storage[MOTOR_ADDR_NTC3_TEMP_OFFSET+1];
	
	Set_DataAddr_Value(MB_FUNC_READ_INPUT_REGISTER , MB_MOSFET_TEMPERATURE_01, ntc_tmp[0]);
	Set_DataAddr_Value(MB_FUNC_READ_INPUT_REGISTER , MB_MOSFET_TEMPERATURE_02, ntc_tmp[1]);
	Set_DataAddr_Value(MB_FUNC_READ_INPUT_REGISTER , MB_MOSFET_TEMPERATURE_03, ntc_tmp[2]);
	
	//----- 串口打印   ------------------------------------------------------------------------------
	/*if(memcmp(Motor_State_Old, Motor_State_Storage, MOTOR_PROTOCOL_ADDR_MAX) != 0)
	{
		DEBUG_PRINT("\n\n\
		mosfet温度:\t%d.%d (°C)\n\
		驱动版本:\t%d.%d \n\
		电机电流:\t%d.%d (A)\n\
		当前转速:\t\t\t\t%d (rpm)\n\
		母线电压:\t%d.%d (V)\n\
		电机故障:\t\t%X \n\
		10KNTC温度1 2 3:\t%d.%d (°C)\t%d.%d (°C)\t%d.%d (°C)\n\n",
				Temperature/10,Temperature%10,Driver_Software_Version_Read/10,Driver_Software_Version_Read%10,*p_Motor_Current/100,*p_Motor_Current%100,
				*p_Motor_Reality_Speed,*p_Motor_Bus_Voltage/10,*p_Motor_Bus_Voltage%10,*p_Motor_Fault_Static,
				ntc_tmp[0]/10,ntc_tmp[0]%10,ntc_tmp[1]/10,ntc_tmp[1]%10,ntc_tmp[2]/10,ntc_tmp[2]%10);
		
		if((ntc_tmp[0]>Temperature)||(ntc_tmp[1]>Temperature)||(ntc_tmp[2]>Temperature))
			DEBUG_PRINT("\n mosfet温度错误 \t%d.%d (°C)\n",Temperature/10,Temperature%10);
		
		memcpy(Motor_State_Old, Motor_State_Storage, MOTOR_PROTOCOL_ADDR_MAX);
	}*/
	//===============================================================================================
	
	if(Motor_Fault_Old != *p_Motor_Fault_Static)
	{
		Motor_Fault_Old = *p_Motor_Fault_Static;
		Motor_Fault_Timer_cnt = 0;
	}
	else
	{
		if(Motor_Fault_Timer_cnt < MOTOR_CHECK_FAULT_TIMER)
			Motor_Fault_Timer_cnt ++;
		else
		{
			/*if(Motor_Fault_Old == 0)
			{
				CLEAN_MOTOR_FAULT(Motor_Fault_State);
			}
			else*/
			{
				result_fault = Change_Faule_To_Upper(*p_Motor_Fault_Static);
				Set_Motor_Fault_State(result_fault);
			}
			Motor_Fault_Timer_cnt = 0;
		}
	}
#ifdef SYSTEM_DRIVER_BOARD_TOOL
	// 温度传感器故障  
	if((ntc_tmp[0] == -2000)||(ntc_tmp[0] == -3000)||
				(ntc_tmp[1] == -2000)||(ntc_tmp[1] == -3000)||
					(ntc_tmp[2] == -2000)||(ntc_tmp[2] == -3000))
	{
		Set_Motor_Fault_State(E201_TEMPERATURE_HARDWARE);
	}
	// 母线电压故障   ±5%
	if((*p_Motor_Bus_Voltage > 228)||(*p_Motor_Bus_Voltage < 252))
	{
		Set_Motor_Fault_State(E001_BUS_VOLTAGE_ABNORMAL);
	}
#endif
	
	// 高温 		降频	mos
	Check_Down_Conversion_MOS_Temperature((*p_Mos_Temperature)/10);
	// 输出电流 	降频
	Check_Down_Conversion_Motor_Current(*p_Motor_Current/100);
	// 输出功率 		降频
	//Check_Down_Conversion_Motor_Power(*p_Motor_Reality_Power);
	
	// 驱动状态检验   电机转速
	Drive_Status_Inspection_Motor_Speed();
	// 驱动状态检验   电机电流
	Drive_Status_Inspection_Motor_Current();
	
}
//↑↑↑↑↑↑↑↑↑↑↑↑↑↑↑↑↑↑↑↑↑↑↑↑↑↑↑↑↑↑↑↑↑↑↑↑↑↑↑↑↑↑↑↑↑↑↑↑↑↑
//↓↓↓↓↓↓↓↓↓↓↓↓↓↓↓↓↓↓↓↓↓↓↓↓↓↓↓↓↓↓↓↓↓↓↓↓↓↓↓↓↓↓↓↓↓↓↓↓↓↓
void TEMP001_Motor_State_Analysis(void)
{
	uint16_t result_fault=0;
	int16_t Temperature=0;
	static uint16_t ntc_tmp[3]={0};

	if(Get_Motor_Fault_State()&E203_MOTOR_LOSS)
	{
		if(Motor_Loss_Cnt < 2)
		{
			if(Motor_Rx_Timer_cnt < (MOTOR_THREAD_ONE_SECOND*3))
				Motor_Loss_Cnt++;
			else
				Motor_Loss_Cnt = 0;
			Motor_Rx_Timer_cnt = 0;
			return;
		}
		else
		{
			//驱动板 通讯故障 恢复
			ReSet_Motor_Fault_State(E203_MOTOR_LOSS);
			Motor_Loss_Cnt = 0;
		}
	}
	
	Motor_Rx_Timer_cnt = 0;

	// 当前 转速
	*p_Motor_Reality_Speed = Motor_State_Storage[TEMP001_MOTOR_ADDR_MOTOR_SPEED_OFFSET]*10;
	// 软件版本
	Driver_Software_Version_Read = Motor_State_Storage[TEMP001_MOTOR_ADDR_MOTOR_VERSION_OFFSET];
	// 母线电压
	*p_Motor_Bus_Voltage = Motor_State_Storage[TEMP001_MOTOR_ADDR_BUS_VOLTAGE_OFFSET] *10;
	// 母线电流
	*p_Motor_Bus_Current = Motor_State_Storage[TEMP001_MOTOR_ADDR_BUS_CURRENT_OFFSET] *100;
	// 电机电流
	*p_Motor_Current = Motor_State_Storage[TEMP001_MOTOR_ADDR_MOTOR_CURRENT_OFFSET] *100;
	// mosfet温度
	if((Motor_State_Storage[TEMP001_MOTOR_ADDR_MOSFET_TEMP_NUM_OFFSET] >= 1) && (Motor_State_Storage[TEMP001_MOTOR_ADDR_MOSFET_TEMP_NUM_OFFSET] <= 3))
	{
		ntc_tmp[Motor_State_Storage[TEMP001_MOTOR_ADDR_MOSFET_TEMP_NUM_OFFSET]-1] = Motor_State_Storage[TEMP001_MOTOR_ADDR_MOSFET_TEMP_OFFSET] *10;
	}
	Temperature = (ntc_tmp[0]>ntc_tmp[1])?ntc_tmp[0]:ntc_tmp[1];
	Temperature = (Temperature>ntc_tmp[2])?Temperature:ntc_tmp[2];
	*p_Mos_Temperature = Temperature;
	// 当前功率
	*p_Motor_Reality_Power =  Motor_State_Storage[TEMP001_MOTOR_ADDR_MOTOR_POWER_OFFSET+1]<<8 | Motor_State_Storage[TEMP001_MOTOR_ADDR_MOTOR_POWER_OFFSET];
	// 电机故障
 	*p_Motor_Fault_Static = Motor_State_Storage[TEMP001_MOTOR_ADDR_MOTOR_FAULT_OFFSET+1]<<8 | Motor_State_Storage[TEMP001_MOTOR_ADDR_MOTOR_FAULT_OFFSET];
	
	//----- 串口打印   ------------------------------------------------------------------------------
	/*DEBUG_PRINT("\n\n\
	当前转速:\t\t\t%d (rpm)\n\
	驱动版本:\t%X\n\
	母线电压:\t%d.%d (V)\n\
	母线电流:\t%d.%d (A)\n\
	电机电流:\t%d.%d (A)\n\
	mosfet温度:\t\t%d.%d (°C)\n\
	10KNTC温度1 2 3:\t%d.%d (°C)\t%d.%d (°C)\t%d.%d (°C)\n\
	当前功率:\t%d (W)\n\
	电机故障:\t\t0x%X\n",

	*p_Motor_Reality_Speed,Driver_Software_Version_Read,
	*p_Motor_Bus_Voltage/10,*p_Motor_Bus_Voltage%10,
	*p_Motor_Bus_Current/100,*p_Motor_Bus_Current%100,
	*p_Motor_Current/100,*p_Motor_Current%100,
	Temperature/10,Temperature%10,
	ntc_tmp[0]/10,ntc_tmp[0]%10,ntc_tmp[1]/10,ntc_tmp[1]%10,ntc_tmp[2]/10,ntc_tmp[2]%10,
	*p_Motor_Reality_Power,*p_Motor_Fault_Static);*/
	//===============================================================================================
	if(Motor_Fault_Old != *p_Motor_Fault_Static)
	{
		Motor_Fault_Old = *p_Motor_Fault_Static;
		Motor_Fault_Timer_cnt = 0;
	}
	else
	{
		if(Motor_Fault_Timer_cnt < MOTOR_CHECK_FAULT_TIMER)
			Motor_Fault_Timer_cnt ++;
		else
		{
			/*if(Motor_Fault_Old == 0)
			{
				CLEAN_MOTOR_FAULT(Motor_Fault_State);
			}
			else*/
			{
				result_fault = Change_Faule_To_Upper(*p_Motor_Fault_Static);
				if((TEMP001_If_Faule_Need_ReStar(result_fault)==0)&&(IS_IN_START_UP_STAGE())&&(Motor_ReStart_Cnt < 3))
				{
					GET_IN_WAIT_RESTART_STAGE();
				}
				else
				{
					Set_Motor_Fault_State(result_fault);
				}
			}
			Motor_Fault_Timer_cnt = 0;
		}
	}
	
	// 高温 		降频	mos
	Check_Down_Conversion_MOS_Temperature(Temperature/10);
	// 输出电流 	降频
	Check_Down_Conversion_Motor_Current(*p_Motor_Current/100);
	// 输出功率 		降频
	Check_Down_Conversion_Motor_Power(*p_Motor_Reality_Power);
	
	// 驱动状态检验   电机转速
	Drive_Status_Inspection_Motor_Speed();
	// 驱动状态检验   电机电流
	Drive_Status_Inspection_Motor_Current();
}
//↑↑↑↑↑↑↑↑↑↑↑↑↑↑↑↑↑↑↑↑↑↑↑↑↑↑↑↑↑↑↑↑↑↑↑↑↑↑↑↑↑↑↑↑↑↑↑↑↑↑

void Motor_State_Analysis(void)
{
	if(MOTOR_DEVICE_PROTOCOL_VERSION == MOTOR_DEVICE_HARDWARE_AQPED002)
		AQPED002_Motor_State_Analysis();
	else if(MOTOR_DEVICE_PROTOCOL_VERSION == MOTOR_DEVICE_HARDWARE_TEMP001)
		TEMP001_Motor_State_Analysis();
}
//================================================== 内部调用接口

//-------------------- 驱动状态检验   电机转速 ----------------------------
void Drive_Status_Inspection_Motor_Speed(void)
{
//判断电机转速
#ifdef MOTOR_SPEED_ERROR_TIME
	static uint16_t Check_Motor_Speed_Cnt=0;		// 计时器
	static uint8_t Number_Of_Fault_Alarms = 0;	//	故障计数器
	
	if(Motor_Speed_Is_Reach())	//等转速设置稳定下来后再做判断
	{
		if(Check_Motor_Speed())
		{
			if(Check_Motor_Speed_Cnt > 0)
			{
				DEBUG_PRINT("\n[电机转速正确]\t目标转速\t%d(rpm)\t实际转速\t%d(rpm)\n",Motor_Speed_To_Rpm(Motor_Speed_Now),*p_Motor_Reality_Speed);
			}
			if(Number_Of_Fault_Alarms >= 3)//已经报故障
			{
				//电机转速不准 故障 202 驱动故障
				ReSet_Motor_Fault_State(E202_MOTOR_DRIVER);
				DEBUG_PRINT("\n[电机故障恢复]\t  实际转速\t%d(rpm)\n",*p_Motor_Reality_Speed);
			}
				
			Check_Motor_Speed_Cnt = 0;
			Number_Of_Fault_Alarms = 0;
			
		}
		else
		{
			if(Check_Motor_Speed_Cnt <= MOTOR_SPEED_ERROR_TIME)
			{
				if(Check_Motor_Speed_Cnt == 0)
				{
					DEBUG_PRINT("\n[电机转速错误]\t目标转速\t%d(rpm)\t实际转速\t%d(rpm)\t计数器\t%d\n",Motor_Speed_To_Rpm(Motor_Speed_Now),*p_Motor_Reality_Speed,Check_Motor_Speed_Cnt);
				}
				Check_Motor_Speed_Cnt++;
			}
			else
			{
				if(Number_Of_Fault_Alarms >= 3)
				{
					//电机转速不准 故障 202 驱动故障
					Set_Motor_Fault_State(E202_MOTOR_DRIVER);
					if(Number_Of_Fault_Alarms == 3)
					{
						Number_Of_Fault_Alarms ++ ;
						DEBUG_PRINT("\n[ERROR]\t电机转速不准\t目标转速\t%d(rpm)\t实际转速\t%d(rpm)\n",Motor_Speed_To_Rpm(Motor_Speed_Now),*p_Motor_Reality_Speed);
					}
				}
				else
				{
					//把当前速度同步成驱动板速度
					Motor_Speed_Now = Motor_Rpm_To_Speed(*p_Motor_Reality_Speed);
					DEBUG_PRINT("\n[把当前速度同步成驱动板速度]\t转速\t%d(rpm)\t百分比\t%d()\n",*p_Motor_Reality_Speed,Motor_Speed_Now);
				
					//Special_Status_Add(SPECIAL_BIT_SKIP_STARTING);	//光圈重新闪烁
					Number_Of_Fault_Alarms ++ ;
					Check_Motor_Speed_Cnt = 0;
				}
			}
		}
	}
//	else
//	{
//		Check_Motor_Speed_Cnt = 0;
//	}
#endif
}

//-------------------- 驱动状态检验   电机电流 ----------------------------
void Drive_Status_Inspection_Motor_Current(void)
{
//判断电机电流
#ifdef MOTOR_CANNOT_START_TIME
		static uint16_t Check_Motor_Current_Cnt=0;	// 计时器
	
	
		if(Check_Motor_Current())
		{
			Check_Motor_Current_Cnt = 0;
		}
		else
		{
			if(Check_Motor_Current_Cnt <= MOTOR_CANNOT_START_TIME)
			{
				Check_Motor_Current_Cnt ++;
				DEBUG_PRINT("\n[判断电机电流]\t目标转速\t%d(rpm)\t实际转速\t%d(rpm)\t计数器\t%d\n",Motor_Speed_To_Rpm(Motor_Speed_Now),*p_Motor_Reality_Speed,Check_Motor_Speed_Cnt);
			}
			else
			{
				//电机起不来 故障 202 驱动故障
				Set_Motor_Fault_State(E202_MOTOR_DRIVER);
			}
		}
#endif

}

//-------------------- 获取电机故障状态 ----------------------------
uint16_t Get_Motor_Fault_State(void)
{
	
	return Motor_Fault_State;
}

//-------------------- 设置电机故障状态 ----------------------------
void Set_Motor_Fault_State(uint16_t fault_bit)
{
	//-----------------  展示样机 -------------------------
#ifdef SYSTEM_SHOW_MODEL_MACHINE
		Motor_Fault_State = 0;
#else
	 Motor_Fault_State |= fault_bit;
#endif
}

//-------------------- 清除电机故障状态 ----------------------------
void ReSet_Motor_Fault_State(uint16_t fault_bit)
{
	 Motor_Fault_State &= ~fault_bit;
}

//-------------------- 硬件故障  ----------------------------
uint8_t Motor_Is_Hardware_Fault(uint16_t fault_bit)
{
	if(fault_bit & ORDINARY_FAULT_BIT)
		return 1;
	else
		return 0;
}

//-------------------- 软件故障 ----------------------------
uint8_t Motor_Is_Software_Fault(uint16_t fault_bit)
{
	//uint16_t ordinary_fault_bit = E001_BUS_VOLTAGE_ABNORMAL | E201_TEMPERATURE_HARDWARE | E203_MOTOR_LOSS;
	
	if(fault_bit & ~ORDINARY_FAULT_BIT)
		return 1;
	else
		return 0;
}

//-------------------- restar 故障 ----------------------------
uint8_t TEMP001_If_Faule_Need_ReStar(uint16_t fault_bit)
{
	//uint16_t ordinary_fault_bit = E001_BUS_VOLTAGE_ABNORMAL | E201_TEMPERATURE_HARDWARE | E203_MOTOR_LOSS;
	
	if(fault_bit & TEMP001_RESTAR_FAULT_BIT)
		return 1;
	else
		return 0;
}

//-------------------- 指定故障 ----------------------------
uint8_t Motor_Is_Specified_Fault(uint16_t fault_bit, uint16_t specified_bit)
{
	if(fault_bit & specified_bit)
		return 1;
	else
		return 0;
}

//-------------------- 发送 ----------------------------
void Motor_UART_Send(uint8_t* p_buff, uint8_t len)
{
#ifdef MOTOR_MODULE_HUART
	HAL_UART_Transmit(p_huart_motor, p_buff, len, len*10);
	
#endif
}
//-------------------- 接收 ----------------------------
void Motor_RxData(uint8_t len)
{
	if(MOTOR_DEVICE_PROTOCOL_VERSION == MOTOR_DEVICE_HARDWARE_AQPED002)
	{
	//↓↓↓↓↓↓↓↓↓↓↓↓↓↓↓↓↓↓↓↓↓↓↓↓↓↓↓↓↓↓↓↓↓↓↓↓↓↓↓↓↓↓↓↓↓↓↓↓↓↓
		uint16_t crc_value=0;
		
		// 检查 长度
		if(((Motor_DMABuff[1]+5) != len)||(Motor_DMABuff[1] < 20))
		{
			DEBUG_PRINT("[ERROR]\t接收长度错误:\t收到:\t%d   实际:\t%d\n",Motor_DMABuff[1]+5, len);
			return;
		}
		
		//检查crc
		crc_value = CRC16_XMODEM_T(&Motor_DMABuff[2], Motor_DMABuff[1] );
		//crc_read = ((Motor_DMABuff[len-2]<<8) & Motor_DMABuff[len-1]);
		if(crc_value != ((Motor_DMABuff[len-3]<<8) | Motor_DMABuff[len-2]))
		{
			DEBUG_PRINT("[ERROR]\tcrc校验错误:\t计算得到:\t%d   收到的:\t%d\n",crc_value, ((Motor_DMABuff[len-3]<<8) & Motor_DMABuff[len-2]));
			return;
		}
		
		memcpy(Motor_State_Storage, &Motor_DMABuff[MOTOR_PROTOCOL_HEADER_OFFSET], MOTOR_PROTOCOL_ADDR_MAX);
		Motor_State_Analysis();
	//↑↑↑↑↑↑↑↑↑↑↑↑↑↑↑↑↑↑↑↑↑↑↑↑↑↑↑↑↑↑↑↑↑↑↑↑↑↑↑↑↑↑↑↑↑↑↑↑↑↑
	}
	else if(MOTOR_DEVICE_PROTOCOL_VERSION == MOTOR_DEVICE_HARDWARE_TEMP001)
	{
	//↓↓↓↓↓↓↓↓↓↓↓↓↓↓↓↓↓↓↓↓↓↓↓↓↓↓↓↓↓↓↓↓↓↓↓↓↓↓↓↓↓↓↓↓↓↓↓↓↓↓
		uint8_t crc_value=0;
		
		// 检查 长度
		if(len != 13)
		{
			DEBUG_PRINT("[ERROR]\t接收长度错误:\t收到:\t%d  \n", len);
			return;
		}
		
		//检查crc
		crc_value = CRC8_ADD(&Motor_DMABuff[0], 12);
		//crc_read = ((Motor_DMABuff[len-2]<<8) & Motor_DMABuff[len-1]);
		if(crc_value != Motor_DMABuff[12])
		{
			DEBUG_PRINT("[ERROR]\tcrc校验错误:\t计算得到:\t%X   收到的:\t%X\n",crc_value, (Motor_DMABuff[12]));
			return;
		}
		
		memcpy(Motor_State_Storage, &Motor_DMABuff[TEMP001_MOTOR_PROTOCOL_HEADER_OFFSET], TEMP001_MOTOR_PROTOCOL_ADDR_MAX);
		//接收标志
		Rx_State = 1;

	//↑↑↑↑↑↑↑↑↑↑↑↑↑↑↑↑↑↑↑↑↑↑↑↑↑↑↑↑↑↑↑↑↑↑↑↑↑↑↑↑↑↑↑↑↑↑↑↑↑↑
	}
}



/*-------------------- 快速发送命令 ----------------------------------------------*/
//------------------- 设置电机转速 ----------------------------
void Motor_Speed_Send(uint32_t speed_rpm)
{
	uint32_t rpm=0;
	
	if(MOTOR_DEVICE_PROTOCOL_VERSION == MOTOR_DEVICE_HARDWARE_AQPED002)
	{
		rpm = speed_rpm*MOTOR_POLE_NUMBER;
	//↓↓↓↓↓↓↓↓↓↓↓↓↓↓↓↓↓↓↓↓↓↓↓↓↓↓↓↓↓↓↓↓↓↓↓↓↓↓↓↓↓↓↓↓↓↓↓↓↓↓
		uint8_t buffer[10]={0x02,0x05,0x08,0x00,0x00,0x00,0x00,0x00,0x00,0x03};
		uint16_t crc_value=0;
#ifdef SYSTEM_DRIVER_BOARD_TOOL
		if(Motor_Mode_Register == 2)
			buffer[2] = 0x91;
#endif
		buffer[3] = rpm>>24;
		buffer[4] = rpm>>16;
		buffer[5] = rpm>>8;
		buffer[6] = rpm & 0xFF;
		
		//crc
		
		crc_value = CRC16_XMODEM_T(&buffer[2], 5 );
		
		buffer[7] = crc_value>>8;
		buffer[8] = crc_value & 0xFF;
		
		Motor_UART_Send(buffer, 10);
	//↑↑↑↑↑↑↑↑↑↑↑↑↑↑↑↑↑↑↑↑↑↑↑↑↑↑↑↑↑↑↑↑↑↑↑↑↑↑↑↑↑↑↑↑↑↑↑↑↑↑
	}
	else if(MOTOR_DEVICE_PROTOCOL_VERSION == MOTOR_DEVICE_HARDWARE_TEMP001)
	{
	//↓↓↓↓↓↓↓↓↓↓↓↓↓↓↓↓↓↓↓↓↓↓↓↓↓↓↓↓↓↓↓↓↓↓↓↓↓↓↓↓↓↓↓↓↓↓↓↓↓↓
		uint8_t buffer[13]={0x50,0x00,0x00,0x01,0x00,0x00,0x00,0x00,0x00,0x00,0x00,0xB1,0x00};
		
		//buffer[1] = Motor_Speed_To_Frequency(speed_rpm);
		buffer[1] = speed_rpm & 0xFF;
		buffer[2] = (speed_rpm>>8) & 0xFF;
		
		buffer[3] = Get_DataAddr_Value(MB_FUNC_READ_HOLDING_REGISTER , MB_MOTOR_DRIVE_MODE) & 0xFF;	// 厂内模式
		
		buffer[11] = Get_DataAddr_Value(MB_FUNC_READ_HOLDING_REGISTER , MB_MOTOR_MODEL_CODE) & 0xFF;	// 电机型号
		
		buffer[12] =  CRC8_ADD(buffer, 12);
		
		Motor_UART_Send(buffer, 13);

	//↑↑↑↑↑↑↑↑↑↑↑↑↑↑↑↑↑↑↑↑↑↑↑↑↑↑↑↑↑↑↑↑↑↑↑↑↑↑↑↑↑↑↑↑↑↑↑↑↑↑
	}
}


//------------------- 心跳 ----------------------------
void Motor_Heartbeat_Send(void)
{
	uint8_t buffer[10]={0x02,0x01,0x1E,0xF3,0xFF,0x03};

	Motor_UART_Send(buffer, 6);
}


//-------------------- 读寄存器 ( 全读 )----------------------------
void Motor_Read_Register(void)
{
	uint8_t buffer[10]={0x02,0x01,0x04,0x40,0x84,0x03};

	Motor_UART_Send(buffer, 6);
}

#define	MOTOR_TESTMODE_MSG_SIZEOF						( 54 )

//-------------------- 下发测试参数 ( 测试 )----------------------------
void Motor_GetIn_TestMode(void)
{
	//uint8_t buffer_temp[MOTOR_TESTMODE_MSG_SIZEOF]={0x02,0x29,0x90,0x00,0x00,0x93,0x44,0x00,0x00,0x00,0x86,0x00,0x00,0x25,0xF6,0x00,0x00,0x16,0x4E,0x00,0x00,
		//0x05,0x44,0x00,0x00,0x0E,0xBE,0x01,0xD3,0xFC,0xB0,0x00,0x00,0x00,0x01,0x00,0x00,0x00,0x64,0x00,0x00,0x00,0xC8,0x14,0x53,0x03};
		
	uint8_t buffer_temp[MOTOR_TESTMODE_MSG_SIZEOF]={0x02,0x31,0x90,0x00,0x00,0x66,0x08,0x00,0x00,0x00,0xAE,0x00,0x00,0x32,0x8C,0x00,0x00,0x17,0xE9,0x00,0x00,0x06,0xD5,0x00,0x00,0x0A,
		0x34,01,0x97,0x41,0xD0,0x00,0x00,0x00,0x01,0x00,0x00,0x00,0x1E,0x00,0x00,0x00,0xC8,0x00,0x00,0x06,0x40,0x00,0x00,0x00,0x00,0x71,0x25,0x03}; 
	

	Motor_UART_Send(buffer_temp, MOTOR_TESTMODE_MSG_SIZEOF);
}

//-------------------- 检查电机电流 ----------------------------
uint8_t Check_Motor_Current(void)
{
#ifdef MOTOR_CURRENT_MIX
	if(Motor_Speed_Now >= MOTOR_PERCENT_SPEED_MIX)
	{
		if(*p_Motor_Current < MOTOR_CURRENT_MIX)
			return 0;
	}
#endif
	return 1;
}

//-------------------- 检查电机转速 ----------------------------
uint8_t Check_Motor_Speed(void)
{
#ifdef MOTOR_SPEED_VIBRATION_RANGE
	static uint32_t rpm;
	static uint32_t error_value = 0;
	
	rpm = Motor_Speed_To_Rpm(Motor_Speed_Now);
	error_value = ((rpm*MOTOR_SPEED_VIBRATION_RANGE)/100);
	
	if(rpm  > *p_Motor_Reality_Speed)
	{
		if((rpm - *p_Motor_Reality_Speed) > error_value)
			return 0;
	}
	else
	{
		if((*p_Motor_Reality_Speed - rpm) > error_value)
			return 0;
	}
#endif
	return 1;
}
