Marksman124/inverjet/inverjet_app/Core/Thread/model_parameter.h

/**
******************************************************************************
* @file    		model_parameter.h
* @brief   		型号 参数
*
*
* @author			WQG
* @versions   v1.0
* @date   		2024-10-11
******************************************************************************
*/
/* Define to prevent recursive inclusion -------------------------------------*/
#ifndef __MODEL_PARAMETER_H__
#define __MODEL_PARAMETER_H__


#ifdef __cplusplus
extern "C" {
#endif

/* Includes ------------------------------------------------------------------*/
#include <stdint.h>
#include "gpio.h"

/* Exported macro ------------------------------------------------------------*/

//--------------------------------------------------------------------------------------------------------------
//--------------------------------------------------------------------------------------------------------------
//--------------------------------------------------------------------------------------------------------------

//******************  拨码开关数量 **************************
#define MODEL_DIAL_SWITCH_NUMBER					(4)


//******************  型号选择 **************************
#define PRODUCT_MODEL_CODE_SJ230					(230)
#define PRODUCT_MODEL_CODE_SJ200					(200)
#define PRODUCT_MODEL_CODE_SJ160					(160)
#define PRODUCT_MODEL_CODE_SJ100					(100)
//*******************************************************


/*==============================================================================================================*/
//******************  接口 **************************
/*==============================================================================================================*/

// 产品机型码
#define	MACRO_SYSTEM_PRODUCT_MODEL_CODE						Get_Model_Code_Num()
// 每秒距离
#define	EVERY_1PERCENT_DISTANCE_PER_SECOND				Get_Every_1Percent_Distance_Per_Second()
// 最大转速
#define	MOTOR_RPM_SPEED_MAX												Get_Motor_Rpm_Speed_Max()
// 最小转速
#define	MOTOR_RPM_SPEED_MIX												Get_Motor_Rpm_Speed_Mix()

// 温度 降频  Mos
//*********************************************************************************************
//-------------------------------------------------------------------------------------------------
//-------------- MOS 温度报警值 85°C -------------------
#define MOS_TEMP_ALARM_VALUE								(85)		//			85
//-------------- MOS 温度 降速 80°C -------------------
#define MOS_TEMP_REDUCE_SPEED								(80)		// 降档 温度			80
#define MOS_TEMP_RESTORE_SPEED							(75)		// 恢复 温度			75
//-------------------------------------------------------------------------------------------------
// 温度 降频  机箱
//*********************************************************************************************
//-------------------------------------------------------------------------------------------------
//-------------- 机箱温度报警值 75°C -------------------
#define AMBIENT_TEMP_ALARM_VALUE									(85)		//75
//-------------- 机箱温度 降速 70°C -------------------
#define AMBIENT_TEMP_REDUCE_SPEED									(80)		// 降档 温度
#define AMBIENT_TEMP_RESTORE_SPEED								(65)		// 恢复 温度
//*********************************************************************************************
// 输出电流 降频
//*********************************************************************************************
//-------------------------------------------------------------------------------------------------
//-------------- 输出电流 报警值 70 A -------------------
#define MOTOR_CURRENT_ALARM_VALUE									(68)		//
//-------------- 输出电流 降速 60 A -------------------
#define MOTOR_CURRENT_REDUCE_SPEED								(63)		// 降档 电流
#define MOTOR_CURRENT_RESTORE_SPEED								(58)		// 恢复 电流
//*********************************************************************************************


// 功率 降频
//*********************************************************************************************
//-------------- 电机功率报警值 -------------------
#define MOTOR_POWER_ALARM_VALUE								Get_Motor_Power_Alarm_Value()
//-------------- 电机功率 降速 -------------------
#define MOTOR_POWER_REDUCE_SPEED							Get_Motor_Power_Reduce_Speed()		// 降档
#define MOTOR_POWER_RESTORE_SPEED							Get_Motor_Power_Restore_Speed()		// 恢复
//*********************************************************************************************
// 电流 降频7761
//*********************************************************************************************
////-------------- 输出电流 报警值 -------------------
//#define MOTOR_CURRENT_ALARM_VALUE								Get_Motor_Current_Alarm_Value()
////-------------- 输出电流 降速 -------------------
//#define MOTOR_CURRENT_REDUCE_SPEED							Get_Motor_Current_Reduce_Speed()		// 降档
//#define MOTOR_CURRENT_RESTORE_SPEED							Get_Motor_Current_Restore_Speed()		// 恢复
//*********************************************************************************************

/*==============================================================================================================*/
/*==============================================================================================================*/



/**
  ******************************************************************************
  * 所有型号的参数宏定义
  ******************************************************************************
  */
	
/*==============================================================================================================*/
//******************  SJ230 **********************************************************************************
/*==============================================================================================================*/
#ifdef PRODUCT_MODEL_CODE_SJ230

// 1.5米处 流速 1.8m/s   出水口流速 4m/s    流量 230 
#define	SJ230_EVERY_1PERCENT_DISTANCE_PER_SECOND								(180)

//====== < 700 >  < 1012 >   < 1324 >   < 1637 >   < 1950 > =============================== 1.1.7 以前
//====== < 700 >  < 1000 >   < 1300 >   < 1600 >   < 1900 > =============================== 1.1.8
//最大转速 100%
#define	SJ230_MOTOR_RPM_SPEED_MAX								(1950)		// 9750
//最低转速 100%
#define	SJ230_MOTOR_RPM_SPEED_MIX								(700)			// 3500

// 功率 降频
//*********************************************************************************************
//-------------- 电机功率 报警值  -------------------
#define SJ230_MOTOR_POWER_ALARM_VALUE								(1450)		//1450
//-------------- 电机功率 降速  -------------------
#define SJ230_MOTOR_POWER_REDUCE_SPEED							(1350)		// 降档		1350
#define SJ230_MOTOR_POWER_RESTORE_SPEED							(1250)		// 恢复		1250
//*********************************************************************************************

// 电流 降频
//*********************************************************************************************
//-------------- 输出电流 报警值  -------------------
#define SJ230_MOTOR_CURRENT_ALARM_VALUE								(70)		// 70
//-------------- 输出电流 降速  -------------------
#define SJ230_MOTOR_CURRENT_REDUCE_SPEED							(65)		// 降档	65
#define SJ230_MOTOR_CURRENT_RESTORE_SPEED							(60)		// 恢复	60
//*********************************************************************************************
#endif
/////////////////////////////////////////////////////////////////////////////////////////////////////////////////
//////////////////////////////////////////////////////////////////////////////////////////////////////////////////
//////////////////////////////////////////////////////////////////////////////////////////////////////////////////



/*==============================================================================================================*/
//******************  SJ200 **********************************************************************************
/*==============================================================================================================*/
#ifdef PRODUCT_MODEL_CODE_SJ200
// 1.5米处 流速 1.6m/s   出水口流速 3.45m/s    流量 200 
#define	SJ200_EVERY_1PERCENT_DISTANCE_PER_SECOND								(160)

//====== < 700 >  < 950 >   < 1200 >   < 1450 >   < 1700 > =============================== 
//最大转速 100%
#define	SJ200_MOTOR_RPM_SPEED_MAX								(1700)
//最低转速 100%
#define	SJ200_MOTOR_RPM_SPEED_MIX								(700)

// 功率 降频
//*********************************************************************************************
//-------------- 电机功率报警值 -------------------
#define SJ200_MOTOR_POWER_ALARM_VALUE								(1050)
//-------------- 电机功率 降速 -------------------
#define SJ200_MOTOR_POWER_REDUCE_SPEED							(950)		// 降档
#define SJ200_MOTOR_POWER_RESTORE_SPEED							(850)		// 恢复
//*********************************************************************************************

// 电流 降频
//*********************************************************************************************
//-------------- 输出电流 报警值  -------------------
#define SJ200_MOTOR_CURRENT_ALARM_VALUE								(70)
//-------------- 输出电流 降速  -------------------
#define SJ200_MOTOR_CURRENT_REDUCE_SPEED							(65)		// 降档
#define SJ200_MOTOR_CURRENT_RESTORE_SPEED							(60)		// 恢复
//*********************************************************************************************
#endif
//////////////////////////////////////////////////////////////////////////////////////////////////////////////////
//////////////////////////////////////////////////////////////////////////////////////////////////////////////////
//////////////////////////////////////////////////////////////////////////////////////////////////////////////////



/*==============================================================================================================*/
//******************  SJ160 **********************************************************************************
/*==============================================================================================================*/
#ifdef PRODUCT_MODEL_CODE_SJ160
// 1.5米处 流速 1.38m/s   出水口流速 2.94m/s    流量 170 
#define	SJ160_EVERY_1PERCENT_DISTANCE_PER_SECOND								(130)

//====== < 700 >  < 892 >   < 1084 >   < 1277 >   < 1470 > =============================== 
//最大转速 100%
#define	SJ160_MOTOR_RPM_SPEED_MAX								(1470)
//最低转速 100%
#define	SJ160_MOTOR_RPM_SPEED_MIX								(700)

// 功率 降频
//*********************************************************************************************
//-------------- 电机功率报警值 -------------------
#define SJ160_MOTOR_POWER_ALARM_VALUE								(750)
//-------------- 电机功率 降速  -------------------
#define SJ160_MOTOR_POWER_REDUCE_SPEED							(650)		// 降档
#define SJ160_MOTOR_POWER_RESTORE_SPEED							(550)		// 恢复
//*********************************************************************************************

// 电流 降频
//*********************************************************************************************
//-------------- 输出电流 报警值  -------------------
#define SJ160_MOTOR_CURRENT_ALARM_VALUE								(70)
//-------------- 输出电流 降速  -------------------
#define SJ160_MOTOR_CURRENT_REDUCE_SPEED							(65)		// 降档
#define SJ160_MOTOR_CURRENT_RESTORE_SPEED							(60)		// 恢复
//*********************************************************************************************
#endif
//////////////////////////////////////////////////////////////////////////////////////////////////////////////////
//////////////////////////////////////////////////////////////////////////////////////////////////////////////////
//////////////////////////////////////////////////////////////////////////////////////////////////////////////////



/*==============================================================================================================*/
//******************  SJ100 (140)**********************************************************************************
/*==============================================================================================================*/
#ifdef PRODUCT_MODEL_CODE_SJ100
// 1.5米处 流速 1.38m/s   出水口流速 2.94m/s    流量 140 
#define	SJ100_EVERY_1PERCENT_DISTANCE_PER_SECOND								(108)

//====== < 700 >  < 820 >   < 940 >   < 1060 >   < 1180 > =============================== 
//最大转速 100%
#define	SJ100_MOTOR_RPM_SPEED_MAX								(1180)
//最低转速 100%
#define	SJ100_MOTOR_RPM_SPEED_MIX								(700)

// 功率 降频
//*********************************************************************************************
//-------------- 电机功率报警值 -------------------
#define SJ100_MOTOR_POWER_ALARM_VALUE								(750)
//-------------- 电机功率 降速  -------------------
#define SJ100_MOTOR_POWER_REDUCE_SPEED							(650)		// 降档
#define SJ100_MOTOR_POWER_RESTORE_SPEED							(550)		// 恢复
//*********************************************************************************************

// 电流 降频
//*********************************************************************************************
//-------------- 输出电流 报警值  -------------------
#define SJ100_MOTOR_CURRENT_ALARM_VALUE								(70)
//-------------- 输出电流 降速  -------------------
#define SJ100_MOTOR_CURRENT_REDUCE_SPEED							(65)		// 降档
#define SJ100_MOTOR_CURRENT_RESTORE_SPEED							(60)		// 恢复
//*********************************************************************************************
#endif
//////////////////////////////////////////////////////////////////////////////////////////////////////////////////
//////////////////////////////////////////////////////////////////////////////////////////////////////////////////
//////////////////////////////////////////////////////////////////////////////////////////////////////////////////

/* Private defines -----------------------------------------------------------*/
// 拨码开关
extern uint8_t System_Dial_Switch;


#ifdef __cplusplus
}
#endif

#endif /* __MODEL_PARAMETER_H__ */
