Marksman124/inverjet/inverjet_app/Core/Inc/main.h

#define MODBUS_USART								MACRO_MODBUS_USART
#define THREAD_PERIOD_RS485_MODBUS_TASK					MODBUS_THREAD_LIFECYCLE
#define THREAD_PERIOD_MAIN_TASK									TIMING_THREAD_LIFECYCLE
#define POWER_ON_WAITE_TIME_TASK								MACRO_POWER_ON_WAITE_TIME_TASK
#define Led_Power_Pin GPIO_PIN_0
#define Led_Power_GPIO_Port GPIOC
#define Led_Mode_Pin GPIO_PIN_1
#define Led_Mode_GPIO_Port GPIOC
#define Led_Time_Pin GPIO_PIN_2
#define Led_Time_GPIO_Port GPIOC
#define Led_Speed_Pin GPIO_PIN_3
#define Led_Speed_GPIO_Port GPIOC
#define RS485_A_Pin GPIO_PIN_2
#define RS485_A_GPIO_Port GPIOA
#define RS485_B_Pin GPIO_PIN_3
#define RS485_B_GPIO_Port GPIOA
#define SW_3_Pin GPIO_PIN_4
#define SW_3_GPIO_Port GPIOA
#define ADC_CN6_Pin GPIO_PIN_5
#define ADC_CN6_GPIO_Port GPIOA
#define ADC_CN6A6_Pin GPIO_PIN_6
#define ADC_CN6A6_GPIO_Port GPIOA
#define SW_4_Pin GPIO_PIN_7
#define SW_4_GPIO_Port GPIOA
#define SW_1_Pin GPIO_PIN_4
#define SW_1_GPIO_Port GPIOC
#define SW_2_Pin GPIO_PIN_5
#define SW_2_GPIO_Port GPIOC
#define BZ_PWM_Pin GPIO_PIN_0
#define BZ_PWM_GPIO_Port GPIOB
#define ADC_TEMP_Pin GPIO_PIN_1
#define ADC_TEMP_GPIO_Port GPIOB
#define SPI1_CS_Pin GPIO_PIN_2
#define SPI1_CS_GPIO_Port GPIOB
#define CS_Pin GPIO_PIN_12
#define CS_GPIO_Port GPIOB
#define DI_Key_Power_Pin GPIO_PIN_13
#define DI_Key_Power_GPIO_Port GPIOB
#define WR_Pin GPIO_PIN_14
#define WR_GPIO_Port GPIOB
#define DATA_Pin GPIO_PIN_15
#define DATA_GPIO_Port GPIOB
#define RS485_EN_Pin GPIO_PIN_6
#define RS485_EN_GPIO_Port GPIOC
#define Key_Speed_Pin GPIO_PIN_7
#define Key_Speed_GPIO_Port GPIOC
#define Key_Time_Pin GPIO_PIN_8
#define Key_Time_GPIO_Port GPIOC
#define Key_Mode_Pin GPIO_PIN_9
#define Key_Mode_GPIO_Port GPIOC
#define Key_Power_Pin GPIO_PIN_8
#define Key_Power_GPIO_Port GPIOA
#define DI_Key_Up_Pin GPIO_PIN_11
#define DI_Key_Up_GPIO_Port GPIOA
#define DI_Key_Down_Pin GPIO_PIN_12
#define DI_Key_Down_GPIO_Port GPIOA
#define LCD_BackLight_Pin GPIO_PIN_15
#define LCD_BackLight_GPIO_Port GPIOA
#define Main_RS485_EN_Pin GPIO_PIN_3
#define Main_RS485_EN_GPIO_Port GPIOB
#define Debug_Led_02_Pin GPIO_PIN_4
#define Debug_Led_02_GPIO_Port GPIOB
#define Debug_Led_01_Pin GPIO_PIN_5
#define Debug_Led_01_GPIO_Port GPIOB
#define Debug_IO_01_Pin GPIO_PIN_8
#define Debug_IO_01_GPIO_Port GPIOB
#define Debug_IO_02_Pin GPIO_PIN_9
#define Debug_IO_02_GPIO_Port GPIOB
