Marksman124/inverjet/inverjet_app/Core/Thread/modbus.c

/**
******************************************************************************
* @file    		modbus.c
* @brief   		Modbus 接口
*
*
* @author			WQG
* @versions   v1.0
* @date   		2024-1-5
******************************************************************************
*/
/* Includes ------------------------------------------------------------------*/
#include "modbus.h"
#include "dev.h"
#include "key.h"
/* Private variables ---------------------------------------------------------*/
ULONG OTA_Pack_Len=0;					// 总长度

uint32_t ModbusTimerCnt=0;



/* ----------------------- Static variables ---------------------------------*/
//USHORT   usRegHoldingStart = REG_HOLDING_START;
USHORT   usRegHoldingBuf[REG_HOLDING_NREGS+1];

//USHORT   usRegInputStart = REG_INPUT_START;
USHORT   usRegInputBuf[REG_INPUT_NREGS+1] = {0};

USHORT		MB_Data_Addr_Need_CallOut[] = {
	MB_SLAVE_NODE_ADDRESS,MB_SLAVE_BAUD_RATE,
	MB_SYSTEM_WORKING_MODE,MB_SYSTEM_WORKING_STATUS,MB_MOTOR_CURRENT_SPEED,MB_SYSTEM_SELF_TEST_STATE,
	//MB_MOTOR_CURRENT_SPEED,MB_MOTOR_CURRENT_TIME,
};

BOOL Dmx512_Data_Change_Sign =0;
/* ----------------------- Start implementation -----------------------------*/
extern TIM_HandleTypeDef htim1;

void Clean_ModbusTimerCnt()
{
	ModbusTimerCnt = 0;
}

BOOL 
Check_Need_CallOut(USHORT addr)
{
	USHORT sum,i;
	
	sum = sizeof(MB_Data_Addr_Need_CallOut)/sizeof(MB_Data_Addr_Need_CallOut[0]);
	
	for(i=0; i<sum; i++)
	{
		if(addr == MB_Data_Addr_Need_CallOut[i])
			return TRUE;
	}
	
	return FALSE;
}

// Call Out
void
HoldingCallOut( USHORT usAddress )
{
	//uint16_t iRegIndex;
	//uint32_t message_info=0;
	
	//iRegIndex = ( usAddress );
	
	if(usAddress == MB_SLAVE_NODE_ADDRESS) // 从机地址
	{
		MB_Node_Address_Set(*p_Local_Address);
	}
	else if(usAddress == MB_SLAVE_BAUD_RATE) // 设置波特率
	{
		__HAL_UART_DISABLE(p_huart_mb);
#if MODBUS_USART == 1
		MX_USART1_UART_Init();
#elif MODBUS_USART == 3
		MX_USART3_UART_Init();
#elif MODBUS_USART == 4
		MX_UART4_Init();
#elif MODBUS_USART == 5
		MX_UART5_Init();
#endif
		__HAL_UART_ENABLE(p_huart_mb);
	}
	else if(usAddress == MB_SYSTEM_WORKING_MODE) //	系统工作模式  高位::0：P1\2\3  低位:0：自由:1：定时:2：训练
	{
		System_Para_Set_PMode(usRegHoldingBuf[MB_SYSTEM_WORKING_MODE], CTRL_FROM_RS485);
	}
	else if(usAddress == MB_SYSTEM_WORKING_STATUS) //	状态机
	{
		System_Para_Set_Status(usRegHoldingBuf[MB_SYSTEM_WORKING_STATUS], CTRL_FROM_RS485);
	}
	else if(usAddress == MB_MOTOR_CURRENT_SPEED)
	{
		System_Para_Set_Speed(usRegHoldingBuf[MB_MOTOR_CURRENT_SPEED], CTRL_FROM_RS485);
	}
	else if(usAddress == MB_MOTOR_CURRENT_TIME)
	{
		System_Para_Set_Time(usRegHoldingBuf[MB_MOTOR_CURRENT_TIME], CTRL_FROM_RS485);
	}
	else if(usAddress == MB_SYSTEM_SELF_TEST_STATE)
	{
		if(usRegHoldingBuf[MB_SYSTEM_SELF_TEST_STATE] == 0xAA )
		{
			if(IS_SELF_TEST_MODE() == 0)
			{
				IN_CHECK_ERROR_MODE();
				usRegHoldingBuf[MB_SYSTEM_SELF_TEST_STATE] = 0;
				//Write_MbBuffer_Now();
			}
		}
		else if(usRegHoldingBuf[MB_SYSTEM_SELF_TEST_STATE] == 0xA070 )
		{
			static uint8_t auto_runing_cnt=0;
				
			if(auto_runing_cnt++ > 3)
			{
				IN_AUTO_RUNNING_MODE();
				usRegHoldingBuf[MB_SYSTEM_SELF_TEST_STATE] = 0;
			}
		}
			
	}
}


eMBErrorCode
eMBRegInputCB( UCHAR * pucRegBuffer, USHORT usAddress, USHORT usNRegs )
{
    eMBErrorCode    eStatus = MB_ENOERR;
    int             iRegIndex;

	Clean_ModbusTimerCnt();
	
    if( usAddress + usNRegs <= REG_INPUT_START + REG_INPUT_NREGS )
    {
        //iRegIndex = ( int )( usAddress - usRegInputStart );
				iRegIndex = ( int )( usAddress );
        while( usNRegs > 0 )
        {
					*pucRegBuffer++ = ( unsigned char )( usRegInputBuf[iRegIndex] >> 8 );
					*pucRegBuffer++ = ( unsigned char )( usRegInputBuf[iRegIndex] & 0xFF );
					iRegIndex++;
					usNRegs--;
        }
    }
    else
    {
        eStatus = MB_ENOREG;
    }
    return eStatus;
}

eMBErrorCode
eMBRegHoldingCB( UCHAR * pucRegBuffer, USHORT usAddress, USHORT usNRegs,
                 eMBRegisterMode eMode )
{
  eMBErrorCode    eStatus = MB_ENOERR;
    int             iRegIndex;
	
		Clean_ModbusTimerCnt();
	
    if( usAddress + usNRegs <= REG_HOLDING_START + REG_HOLDING_NREGS ) 
    {
				//iRegIndex = ( int )( usAddress - usRegHoldingStart );
        iRegIndex = ( int )( usAddress );
        switch ( eMode )
        {
        case MB_REG_READ:
            while( usNRegs > 0 )
            {
							*pucRegBuffer++ = ( unsigned char )( usRegHoldingBuf[iRegIndex] >> 8 );
							*pucRegBuffer++ = ( unsigned char )( usRegHoldingBuf[iRegIndex] & 0xFF );
              iRegIndex++;
              usNRegs--;
            }
            break;

        case MB_REG_WRITE:
						if(If_Accept_External_Control(BLOCK_MODBUS_CONTROL))
						{
							while( usNRegs > 0 )
							{
								//状态机
								if((iRegIndex == MB_SYSTEM_WORKING_STATUS) && ( *(pucRegBuffer+1) > TRAINING_MODE_STOP ))
								{
									pucRegBuffer++;
									pucRegBuffer++;
								}
								else
								{
									usRegHoldingBuf[iRegIndex] = *pucRegBuffer++ << 8;
									usRegHoldingBuf[iRegIndex] |= *pucRegBuffer++;
								}
								
								if(Check_Need_CallOut(iRegIndex))
								{
									HoldingCallOut(iRegIndex);
								}
								
								iRegIndex++;
								usNRegs--;
							}
//							if(Check_Need_CallOut(usAddress))
//							{
//								HoldingCallOut(usAddress);
//							}
							//保存
							Write_MbBuffer_Later();
						}
						break;
        }
    }
    else
    {
        eStatus = MB_ENOREG;
    }
    return eStatus;
}

eMBErrorCode
eMBRegFileCB( UCHAR * pucRegBuffer, USHORT fileNumber, USHORT fileLength,
                 eMBRegisterMode eMode )
{
  eMBErrorCode    eStatus = MB_ENOERR;
	ULONG write_addr=0;						// flash 写入地址
	ULONG sign=0;
	
	Clean_ModbusTimerCnt();
	
	if( (( fileNumber <= REG_FILE_NUMBER_MAX ) || ( fileNumber == REG_FILE_NUMBER_END )) && ( fileLength <= REG_FILE_LENTH_MAX ) )
	{
		switch ( eMode )
		{
		case MB_REG_READ:
			break;
		case MB_REG_WRITE:
			if(fileNumber == REG_FILE_NUMBER_STAR) // 起始包
			{OTA_Pack_Len = 0;}
			
			taskENTER_CRITICAL();
			write_addr = (FLASH_APP_PATCH_ADDR + OTA_Pack_Len);
			iap_write_appbin(write_addr,pucRegBuffer,fileLength);
			OTA_Pack_Len += (fileLength*2);
			taskEXIT_CRITICAL();
			
			if(fileNumber == REG_FILE_NUMBER_END)//最后一帧
			{
				STMFLASH_Write(BOOT_FLASH_ADDR_OTA_PACK_LEN,(uint16_t*)&OTA_Pack_Len,2); // 写包长度 (含crc)
				sign = PRODUCT_BOOT_PASSWORD;
				STMFLASH_Write(BOOT_FLASH_ADDR_OTA_PASSWORD,(uint16_t*)&sign,2); // 进入OTA 

				SysSoftReset();// 软件复位
			}
			break;
		}
	}
	else
	{
			eStatus = MB_ENOREG;
	}
	return eStatus;
}

eMBErrorCode
eMBRegCoilsCB( UCHAR * pucRegBuffer, USHORT usAddress, USHORT usNCoils,
               eMBRegisterMode eMode )
{
	Clean_ModbusTimerCnt();
	//错误状态
	eMBErrorCode eStatus = MB_ENOERR;
//	//寄存器个数
//	int16_t iNCoils = ( int16_t )usNCoils;
//	//寄存器偏移量
//	int16_t usBitOffset;

//	//检查寄存器是否在指定范围内
//	if( ( (int16_t)usAddress >= REG_COILS_START ) &&
//	( usAddress + usNCoils <= REG_COILS_START + REG_COILS_SIZE ) )
//	{
//	//计算寄存器偏移量
//	usBitOffset = ( int16_t )( usAddress - REG_COILS_START );
//	switch ( eMode )
//	{
//	//读操作
//	case MB_REG_READ:
//	while( iNCoils > 0 )
//	{
//	*pucRegBuffer++ = xMBUtilGetBits( ucRegCoilsBuf, usBitOffset,
//	( uint8_t )( iNCoils > 8 ? 8 : iNCoils ) );
//	iNCoils -= 8;
//	usBitOffset += 8;
//	}
//	break;

//	//写操作
//	case MB_REG_WRITE:
//	while( iNCoils > 0 )
//	{
//	xMBUtilSetBits( ucRegCoilsBuf, usBitOffset,
//	( uint8_t )( iNCoils > 8 ? 8 : iNCoils ),
//	*pucRegBuffer++ );
//	iNCoils -= 8;
//	}
//	break;
//	}

//	}
//	else
//	{
//	eStatus = MB_ENOREG;
//	}
	return eStatus;
}

eMBErrorCode
eMBRegDiscreteCB( UCHAR * pucRegBuffer, USHORT usAddress, USHORT usNDiscrete )
{
	Clean_ModbusTimerCnt();
	//错误状态
	eMBErrorCode eStatus = MB_ENOERR;
//	//操作寄存器个数
//	int16_t iNDiscrete = ( int16_t )usNDiscrete;
//	//偏移量
//	uint16_t usBitOffset;

//	//判断寄存器时候再制定范围内
//	if( ( (int16_t)usAddress >= REG_DISCRETE_START ) &&
//	( usAddress + usNDiscrete <= REG_DISCRETE_START + REG_DISCRETE_SIZE ) )
//	{
//	//获得偏移量
//	usBitOffset = ( uint16_t )( usAddress - REG_DISCRETE_START );

//	while( iNDiscrete > 0 )
//	{
//	*pucRegBuffer++ = xMBUtilGetBits( ucRegDiscreteBuf, usBitOffset,
//	( uint8_t)( iNDiscrete > 8 ? 8 : iNDiscrete ) );
//	iNDiscrete -= 8;
//	usBitOffset += 8;
//	}

//	}
//	else
//	{
//	eStatus = MB_ENOREG;
//	}
	return eStatus;
}




void Modbus_Init(void)
{
	// 先写死 0xAA  wuqingguang
	if( (*p_Local_Address >= 0xFF) || (*p_Local_Address == 0) )
	{
		*p_Local_Address = MODBUS_LOCAL_ADDRESS;	// 默认 0xAA
	}
	eMBInit( MB_RTU, *p_Local_Address, 0, Dev_BaudRate_Get(MODBUS_USART), MB_PAR_ODD);//初始化modbus，走modbusRTU，从站地址为0xAA，串口为2。
	eMBEnable(  );//使能modbus
	
}

void Modbus_Handle_Task(void)
{
	ModbusTimerCnt ++;
	Thread_Activity_Sign_Set(THREAD_ACTIVITY_RS485_MODBUS);
	
	( void )eMBPoll(  );//启动modbus侦听
	
	if(ModbusTimerCnt > MODBUS_RESTART_TIMEOUT)
	{
		ModbusTimerCnt = 0;
		vMBPortSerialEnable( TRUE, FALSE );
	}
}



// *********  Buf 相关数据接口  *************************************

void Modbus_Buffer_Init(void)
{
	STMFLASH_Read(FLASH_APP_PARAM_ADDR, usRegHoldingBuf, REG_HOLDING_NREGS );// REG_HOLDING_NREGS
	
}

void MB_Flash_Buffer_Write(void)
{
	DEBUG_LED2_ON();
	taskENTER_CRITICAL();
	//扇区是2048， 整个 usRegHoldingBuf 一起写
	STMFLASH_Write(FLASH_APP_PARAM_ADDR, usRegHoldingBuf, REG_HOLDING_NREGS );
	taskEXIT_CRITICAL();
	//Eeprom_I2C_Write(FLASH_APP_PARAM_ADDR, usRegHoldingBuf, REG_HOLDING_NREGS );
	DEBUG_LED2_OFF();
}

void MB_Flash_Buffer_Read(void)
{
	//扇区是2048， 整个 usRegHoldingBuf 一起写
	STMFLASH_Read(FLASH_APP_PARAM_ADDR, usRegHoldingBuf, REG_HOLDING_NREGS );
	
	//Eeprom_I2C_Write(FLASH_APP_PARAM_ADDR, usRegHoldingBuf, REG_HOLDING_NREGS );
}

uint16_t* Get_DataAddr_Pointer(UCHAR ucFunctionCode, USHORT addr)
{
	if(ucFunctionCode == MB_FUNC_READ_HOLDING_REGISTER)
	{
		if(addr <= REG_HOLDING_NREGS)
		{
			return &usRegHoldingBuf[addr];
		}
	}
	else if(ucFunctionCode == MB_FUNC_READ_INPUT_REGISTER)
	{
		if(addr <= REG_INPUT_NREGS)
		{
			return &usRegInputBuf[addr];
		}
	}
	
	return NULL;
}


uint16_t Get_DataAddr_Value(UCHAR ucFunctionCode, USHORT addr)
{
	if(ucFunctionCode == MB_FUNC_READ_HOLDING_REGISTER)
	{
		if(addr <= REG_HOLDING_NREGS)
		{
			return usRegHoldingBuf[addr];
		}
	}
	else if(ucFunctionCode == MB_FUNC_READ_INPUT_REGISTER)
	{
		if(addr <= REG_INPUT_NREGS)
		{
			return usRegInputBuf[addr];
		}
	}
	
	return NULL;
}

void Set_DataAddr_Value(UCHAR ucFunctionCode, USHORT addr, uint16_t value)
{
	if(ucFunctionCode == MB_FUNC_READ_HOLDING_REGISTER)
	{
		if(addr <= REG_HOLDING_NREGS)
		{
			usRegHoldingBuf[addr] = value;
		}
	}
	else if(ucFunctionCode == MB_FUNC_READ_INPUT_REGISTER)
	{
		if(addr <= REG_INPUT_NREGS)
		{
			usRegInputBuf[addr] = value;
		}
	}
}

void Set_DataValue_U32(UCHAR ucFunctionCode, USHORT addr, uint32_t value)
{
	Set_DataAddr_Value( ucFunctionCode, addr, value>>16 );
	Set_DataAddr_Value( ucFunctionCode, addr+1, value&0xFFFF );
}

void Set_DataValue_Len(UCHAR ucFunctionCode, USHORT addr, uint8_t* p_data, uint8_t len)
{
	if(ucFunctionCode == MB_FUNC_READ_HOLDING_REGISTER)
	{
		memcpy(&usRegHoldingBuf[addr], p_data, len);
	}
	else if(ucFunctionCode == MB_FUNC_READ_INPUT_REGISTER)
	{
		memcpy(&usRegInputBuf[addr], p_data, len);
	}
}


//================= 冲浪模式 全局 参数 ================================
void Surf_Mode_Info_Get_Mapping(void)
{
	// ----------------------------------------------------------------------------------------------
	p_Surf_Mode_Info_Acceleration = Get_DataAddr_Pointer(MB_FUNC_READ_HOLDING_REGISTER,		MB_SURF_MODE_INFO_ACCELERATION);		//	冲浪模式 -- 加速度
	p_Surf_Mode_Info_Prepare_Time = Get_DataAddr_Pointer(MB_FUNC_READ_HOLDING_REGISTER,		MB_SURF_MODE_INFO_PREPARE_TIME);		//	冲浪模式 -- 准备时间
	p_Surf_Mode_Info_Low_Speed		= Get_DataAddr_Pointer(MB_FUNC_READ_HOLDING_REGISTER,		MB_SURF_MODE_INFO_LOW_SPEED);				//	冲浪模式 -- 低速档 -- 速度
	p_Surf_Mode_Info_Low_Time 		= Get_DataAddr_Pointer(MB_FUNC_READ_HOLDING_REGISTER,		MB_SURF_MODE_INFO_LOW_TIME);				//	冲浪模式 -- 低速档 -- 时间
	p_Surf_Mode_Info_High_Speed 	= Get_DataAddr_Pointer(MB_FUNC_READ_HOLDING_REGISTER,		MB_SURF_MODE_INFO_HIGH_SPEED);			//	冲浪模式 -- 高速档 -- 速度
	p_Surf_Mode_Info_High_Time 		= Get_DataAddr_Pointer(MB_FUNC_READ_HOLDING_REGISTER,		MB_SURF_MODE_INFO_HIGH_TIME);				//	冲浪模式 -- 高速档 -- 时间
	// ----------------------------------------------------------------------------------------------
}



void MB_Get_Mapping_Register(void)
{
	p_OP_ShowLater = 		(Operating_Parameters*)Get_DataAddr_Pointer(MB_FUNC_READ_HOLDING_REGISTER , MB_MOTOR_LEATER_SPEED);
	p_OP_Free_Mode = 		(Operating_Parameters*)Get_DataAddr_Pointer(MB_FUNC_READ_HOLDING_REGISTER , MB_USER_FREE_MODE_SPEED);
	p_OP_Timing_Mode = 	(Operating_Parameters*)Get_DataAddr_Pointer(MB_FUNC_READ_HOLDING_REGISTER , MB_USER_TIME_MODE_SPEED);
	p_OP_PMode =				(Operating_Parameters(*)[TRAINING_MODE_PERIOD_MAX])Get_DataAddr_Pointer(MB_FUNC_READ_HOLDING_REGISTER , MB_USER_TRAIN_MODE_SPEED_P1_1);
	//光圈亮度
	p_Breath_Light_Max = Get_DataAddr_Pointer(MB_FUNC_READ_HOLDING_REGISTER , MB_MOTOR_BREATH_LIGHT_MAX);
	if(*p_Breath_Light_Max > 500)
		*p_Breath_Light_Max = 500;

	p_Motor_Pole_Number = Get_DataAddr_Pointer(MB_FUNC_READ_HOLDING_REGISTER,MB_MOTOR_POLE_NUMBER);
	
	//系统 故障状态
	p_System_Fault_Static = Get_DataAddr_Pointer(MB_FUNC_READ_INPUT_REGISTER , MB_SYSTEM_FAULT_STATUS);
	//电机 故障状态
	p_Motor_Fault_Static = Get_DataAddr_Pointer(MB_FUNC_READ_INPUT_REGISTER,MB_MOTOR_FAULT_STATUS);
	//mos 温度
	p_Mos_Temperature = (int16_t*)Get_DataAddr_Pointer(MB_FUNC_READ_INPUT_REGISTER,MB_MOS_TEMPERATURE);
	//电箱 温度
	p_Box_Temperature = (int16_t*)Get_DataAddr_Pointer(MB_FUNC_READ_INPUT_REGISTER,MB_BOX_TEMPERATURE);
	//电机 电流
	p_Motor_Current = (uint32_t*)Get_DataAddr_Pointer(MB_FUNC_READ_INPUT_REGISTER,MB_MOTOR_CURRENT);
	//电机 实际 转速
	p_Motor_Reality_Speed = (uint32_t*)Get_DataAddr_Pointer(MB_FUNC_READ_INPUT_REGISTER,MB_MOTOR_REALITY_SPEED);
	//电机 下发 实际 转速
	p_Send_Reality_Speed = (uint32_t*)Get_DataAddr_Pointer(MB_FUNC_READ_INPUT_REGISTER,MB_SEND_REALITY_SPEED);
	
	//电机 实际 功率
	p_Motor_Reality_Power = (uint32_t*)Get_DataAddr_Pointer(MB_FUNC_READ_INPUT_REGISTER,MB_MOTOR_REALITY_POWER);
	
	//母线 电压
	p_Motor_Bus_Voltage = Get_DataAddr_Pointer(MB_FUNC_READ_INPUT_REGISTER,MB_MOTOR_BUS_VOLTAGE);
	//母线 电流
	p_Motor_Bus_Current = Get_DataAddr_Pointer(MB_FUNC_READ_INPUT_REGISTER,MB_MOTOR_BUS_CURRENT);

	//--------------------------- 系统属性
	// 状态机
	p_System_State_Machine = Get_DataAddr_Pointer(MB_FUNC_READ_HOLDING_REGISTER,MB_SYSTEM_WORKING_STATUS);
	// 当前模式
	p_PMode_Now = Get_DataAddr_Pointer(MB_FUNC_READ_HOLDING_REGISTER,MB_SYSTEM_WORKING_MODE);
	// 当前速度
	p_OP_ShowNow_Speed = Get_DataAddr_Pointer(MB_FUNC_READ_HOLDING_REGISTER,MB_MOTOR_CURRENT_SPEED);
	// 当前时间
	p_OP_ShowNow_Time = Get_DataAddr_Pointer(MB_FUNC_READ_HOLDING_REGISTER,MB_MOTOR_CURRENT_TIME);

	//****************************************************************************************************************************************
	//--------------------------- 临时 用于故障等界面记录返回值
	// 状态机
	p_System_State_Machine_Memory = Get_DataAddr_Pointer(MB_FUNC_READ_INPUT_REGISTER,MB_SYSTEM_WORKING_STATUS_MEMORY);
	// 当前模式
	p_PMode_Now_Memory = Get_DataAddr_Pointer(MB_FUNC_READ_INPUT_REGISTER,MB_SYSTEM_WORKING_MODE_MEMORY);
	// 当前速度
	p_OP_ShowNow_Speed_Memory = Get_DataAddr_Pointer(MB_FUNC_READ_INPUT_REGISTER,MB_MOTOR_CURRENT_SPEED_MEMORY);
	// 当前时间
	p_OP_ShowNow_Time_Memory = Get_DataAddr_Pointer(MB_FUNC_READ_INPUT_REGISTER,MB_MOTOR_CURRENT_TIME_MEMORY);
	//****************************************************************************************************************************************

	//--------------------------- 调试 使用
	// 系统时间
	p_System_Runing_Second_Cnt = (uint32_t *)Get_DataAddr_Pointer(MB_FUNC_READ_INPUT_REGISTER, MB_SYSTEM_RUNNING_TIME);		// 系统时间
	// 无人操作时间
	p_No_Operation_Second_Cnt = (uint32_t *)Get_DataAddr_Pointer(MB_FUNC_READ_INPUT_REGISTER, MB_NO_OPERATION_TIME);		// 无人操作
	// 启动时间
	p_System_Startup_Second_Cnt = (uint32_t *)Get_DataAddr_Pointer(MB_FUNC_READ_INPUT_REGISTER, MB_SYSTEM_SLEEP_TIME);		// 休眠时间
	
	//--------------------------- 
	p_Analog_key_Value = Get_DataAddr_Pointer(MB_FUNC_READ_HOLDING_REGISTER,MB_ANALOG_KEY_VALUE);
	
	//--------------------------- 完成统计 (APP要)
	p_Finish_Statistics_Time 	= Get_DataAddr_Pointer(MB_FUNC_READ_INPUT_REGISTER,MB_FINISH_STATISTICS_TIME);			//	完成统计 --> 时长
	p_Finish_Statistics_Speed = Get_DataAddr_Pointer(MB_FUNC_READ_INPUT_REGISTER,MB_FINISH_STATISTICS_SPEED);			//	完成统计 --> 强度
	p_Finish_Statistics_Distance = (uint32_t*)Get_DataAddr_Pointer(MB_FUNC_READ_INPUT_REGISTER,MB_FINISH_STATISTICS_DISTANCE);	//	完成统计 --> 游泳距离
	p_Preparation_Time_BIT 		= Get_DataAddr_Pointer(MB_FUNC_READ_HOLDING_REGISTER,MB_PREPARATION_TIME_BIT);			//	准备时间 Bit: 定时模式 P1-P6
	
	p_Thread_Activity_Sign 	= Get_DataAddr_Pointer(MB_FUNC_READ_INPUT_REGISTER,MB_THREAD_ACTIVITY_SGIN);			//	线程 活动 标志位

	p_Wifi_Timing_Value = 			(uint32_t*)Get_DataAddr_Pointer(MB_FUNC_READ_INPUT_REGISTER,MB_WIFI_TIMING_VALUE);						//	wifi 系统时间
	p_Wifi_Timing_Value_Old = 	(uint32_t*)Get_DataAddr_Pointer(MB_FUNC_READ_INPUT_REGISTER,MB_WIFI_TIMING_VALUE_OLD);				//	wifi 系统时间
	p_Check_Timing_Add_More = 	Get_DataAddr_Pointer(MB_FUNC_READ_INPUT_REGISTER,MB_CHECK_TIMING_ADD_MORE);
	p_Check_Timing_Minus_More = Get_DataAddr_Pointer(MB_FUNC_READ_INPUT_REGISTER,MB_CHECK_TIMING_MINUS_MORE);				//
	p_Check_Timing_Error_Cnt = 	Get_DataAddr_Pointer(MB_FUNC_READ_INPUT_REGISTER,MB_CHECK_TIMING_ERROR_CNT);				//
	//================= 冲浪模式 全局 参数 ================================
	Surf_Mode_Info_Get_Mapping();
	
	
	p_BLE_Pair_Finish = 	Get_DataAddr_Pointer(MB_FUNC_READ_HOLDING_REGISTER, MB_BT_CONNECT_DONE);
	//================= 信号值  ================================
	p_BLE_Rssi = 	Get_DataAddr_Pointer(MB_FUNC_READ_HOLDING_REGISTER, MB_COMM_TEST_BLUETOOTH);
	p_WIFI_Rssi = Get_DataAddr_Pointer(MB_FUNC_READ_HOLDING_REGISTER, MB_COMM_TEST_WIFI);
	
	//================= ota 大小  ================================
	Set_DataAddr_Value(MB_FUNC_READ_HOLDING_REGISTER,MB_DEBUG_OTA_PAGE_SIZE,*(uint16_t *)BOOT_FLASH_ADDR_OTA_PACK_LEN);
	//Set_DataAddr_Value(MB_FUNC_READ_HOLDING_REGISTER,MB_DEBUG_OTA_PAGE_SIZE,*(uint16_t *)BOOT_FLASH_ADDR_DOWNLOAD_PACK_SIZE);
	//================= 信号值  ================================
	p_Wifi_DP_Upload_Level = 	Get_DataAddr_Pointer(MB_FUNC_READ_HOLDING_REGISTER, MB_WIFI_DP_UPLOAD_LEVEL);
	
}

void MB_HoldBuffer_Temp_Clean(void)
{
	memset(&usRegHoldingBuf[MB_ANALOG_KEY_VALUE],0, (MB_DEBUG_OTA_FAIL_PROGRESS-MB_ANALOG_KEY_VALUE)*2 );
}

void MB_InputBuffer_Init(void)
{
	memset(usRegInputBuf,sizeof(usRegInputBuf),0);
}
