Marksman124/inverjet/inverjet_app/Core/fyld_mcu_sdk/protocol.c

/**********************************Copyright (c)**********************************
**                       版权所有 (C), 2015-2020, 菲亚兰德AIOT部科技
**
**                             http://www.tuya.com
**
*********************************************************************************/
/**
 * @file    protocol.c
 * @author  菲亚兰德AIOT部综合协议开发组
 * @version v2.5.6
 * @date    2020.12.16
 * @brief                
 *                       *******非常重要，一定要看哦！！！********
 *          1. 用户在此文件中实现数据下发/上报功能
 *          2. DP的ID/TYPE及数据处理函数都需要用户按照实际定义实现
 *          3. 当开始某些宏定义后需要用户实现代码的函数内部有#err提示,完成函数后请删除该#err
 */

/****************************** 免责声明 ！！！ *******************************
由于MCU类型和编译环境多种多样，所以此代码仅供参考，用户请自行把控最终代码质量，
菲亚兰德AIOT部不对MCU功能结果负责。
******************************************************************************/

/******************************************************************************
                                移植须知:
1:MCU必须在while中直接调用mcu_api.c内的wifi_uart_service()函数
2:程序正常初始化完成后,建议不进行关串口中断,如必须关中断,关中断时间必须短,关中断会引起串口数据包丢失
3:请勿在中断/定时器中断内调用上报函数
******************************************************************************/

#include "wifi.h"
#include "usart.h"
#include "macro_definition.h"
#include "data.h"
#include "iap.h"
#include "modbus.h"
#include "key.h"

#ifdef WEATHER_ENABLE
/**
 * @var    weather_choose
 * @brief  天气数据参数选择数组
 * @note   用户可以自定义需要的参数，注释或者取消注释即可，注意更改
 */
const char *weather_choose[WEATHER_CHOOSE_CNT] = {
    "temp",
    "humidity",
    "condition",
    "pm25",
    /*"pressure",
    "realFeel",
    "uvi",
    "tips",
    "windDir",
    "windLevel",
    "windSpeed",
    "sunRise",
    "sunSet",
    "aqi",
    "so2 ",
    "rank",
    "pm10",
    "o3",
    "no2",
    "co",
    "conditionNum",*/
};
#endif

unsigned long Wifi_OTA_Pack_Len=0;					// 总长度

unsigned char pack_cnt=0;
unsigned char pack_sum=0;

unsigned char Ota_Chan=0;

/******************************************************************************
                              第一步:初始化
1:在需要使用到wifi相关文件的文件中include "wifi.h"
2:在MCU初始化中调用mcu_api.c文件中的wifi_protocol_init()函数
3:将MCU串口单字节发送函数填入protocol.c文件中uart_transmit_output函数内,并删除#error
4:在MCU串口接收函数中调用mcu_api.c文件内的uart_receive_input函数,并将接收到的字节作为参数传入
5:单片机进入while循环后调用mcu_api.c文件内的wifi_uart_service()函数
******************************************************************************/

/******************************************************************************
                        1:dp数据点序列类型对照表
          **此为自动生成代码,如在开发平台有相关修改请重新下载MCU_SDK**         
******************************************************************************/
const DOWNLOAD_CMD_S download_cmd[] =
{
    {DPID_INVERJET_MODEL_NO, DP_TYPE_ENUM},
    {DPID_PREPARATION_TIME, DP_TYPE_VALUE},
    {DPID_DEVICE_ERROR_CODE, DP_TYPE_VALUE},
    {DPID_GET_SYSTEM_FAULT_STATUS, DP_TYPE_BITMAP},
    {DPID_GET_MOS_TEMPERATURE, DP_TYPE_VALUE},
    {DPID_GET_BOX_TEMPERATURE, DP_TYPE_VALUE},
    {DPID_GET_MOTOR_CURRENT, DP_TYPE_VALUE},
    {DPID_MOTOR_REALITY_SPEED, DP_TYPE_VALUE},
    {DPID_MOTOR_BUS_VOLTAGE, DP_TYPE_VALUE},
    {DPID_SEND_REALITY_SPEED, DP_TYPE_VALUE},
    {DPID_MOTOR_POWER, DP_TYPE_VALUE},
    {DPID_MOTOR_BUS_CURRENTE, DP_TYPE_VALUE},
    {DPID_OTA_PACK_SIZE, DP_TYPE_VALUE},
    {DPID_SYSTEM_RUNNING_TIME, DP_TYPE_VALUE},
    {DPID_NO_OPERATION_TIME, DP_TYPE_VALUE},
    {DPID_SYSTEM_STARTUP_TIME, DP_TYPE_VALUE},
    {DPID_THREAD_ACTIVITY_SIGN, DP_TYPE_VALUE},
    {DPID_SYSTEM_STATUS_MODE, DP_TYPE_RAW},
    {DPID_SYSTEM_WORKING_MODE, DP_TYPE_ENUM},
    {DPID_SYSTEM_WORKING_STATUS, DP_TYPE_ENUM},
    {DPID_MOTOR_CURRENT_SPEED, DP_TYPE_VALUE},
    {DPID_MOTOR_CURRENT_TIME, DP_TYPE_VALUE},
    {DPID_MODE_STATUS_SPEED_TIME, DP_TYPE_RAW},
    {DPID_FREE_MODE_SPEEN, DP_TYPE_VALUE},
    {DPID_TIMING_MODE_SPEEN, DP_TYPE_VALUE},
    {DPID_TIMING_MODE_TIME, DP_TYPE_VALUE},
    {DPID_SET_TRAIN_PLAN_01, DP_TYPE_RAW},
    {DPID_SET_TRAIN_PLAN_02, DP_TYPE_RAW},
    {DPID_SET_TRAIN_PLAN_03, DP_TYPE_RAW},
    {DPID_SET_TRAIN_PLAN_04, DP_TYPE_RAW},
    {DPID_SET_TRAIN_PLAN_05, DP_TYPE_RAW},
    {DPID_CUSTOM_TRAIN_PLAN_01, DP_TYPE_RAW},
    {DPID_CUSTOM_TRAIN_PLAN_02, DP_TYPE_RAW},
    {DPID_CUSTOM_TRAIN_PLAN_03, DP_TYPE_RAW},
    {DPID_FINISH_STATISTICS_TIME, DP_TYPE_VALUE},
    {DPID_FINISH_STATISTICS_SEED, DP_TYPE_VALUE},
    {DPID_FINISH_STATISTICS_DISTANCE, DP_TYPE_VALUE},
    {DPID_DRIVE_NTC_TEMP_01, DP_TYPE_VALUE},
    {DPID_DRIVE_NTC_TEMP_02, DP_TYPE_VALUE},
    {DPID_DRIVE_NTC_TEMP_03, DP_TYPE_VALUE},
    {DPID_WIFI_DP_UPLOAD_LEVEL, DP_TYPE_VALUE},
    
};

/******************************************************************************
                           2:串口单字节发送函数
请将MCU串口发送函数填入该函数内,并将接收到的数据作为参数传入串口发送函数
******************************************************************************/

/**
 * @brief  串口发送数据
 * @param[in] {value} 串口要发送的1字节数据
 * @return Null
 */
void uart_transmit_output(unsigned char value)
{
    //#error "请将MCU串口发送函数填入该函数,并删除该行"
    HAL_UART_Transmit(&huart2, &value, 1, 5);
/*
    //Example:
    extern void Uart_PutChar(unsigned char value);
    Uart_PutChar(value);	                                //串口发送函数
*/
}

/******************************************************************************
                           第二步:实现具体用户函数
1:APP下发数据处理
2:数据上报处理
******************************************************************************/

/******************************************************************************
                            1:所有数据上报处理
当前函数处理全部数据上报(包括可下发/可上报和只上报)
  需要用户按照实际情况实现:
  1:需要实现可下发/可上报数据点上报
  2:需要实现只上报数据点上报
此函数为MCU内部必须调用
用户也可调用此函数实现全部数据上报
******************************************************************************/

//自动化生成数据上报函数

/**
 * @brief  系统所有dp点信息上传,实现APP和muc数据同步
 * @param  Null
 * @return Null
 * @note   此函数SDK内部需调用，MCU必须实现该函数内数据上报功能，包括只上报和可上报可下发型数据
 */
void all_data_update(void)
{
    //#error "请在此处理可下发可上报数据及只上报数据示例,处理完成后删除该行"
    /*
    //此代码为平台自动生成，请按照实际数据修改每个可下发可上报函数和只上报函数
    mcu_dp_enum_update(DPID_INVERJET_MODEL_NO,当前机型); //枚举型数据上报;
    mcu_dp_value_update(DPID_PREPARATION_TIME,当前预备时间（标志位）); //VALUE型数据上报;
    mcu_dp_value_update(DPID_DEVICE_ERROR_CODE,当前驱动板故障); //VALUE型数据上报;
    mcu_dp_fault_update(DPID_GET_SYSTEM_FAULT_STATUS,当前读系统故障); //故障型数据上报;
    mcu_dp_value_update(DPID_GET_MOS_TEMPERATURE,当前MOS温度); //VALUE型数据上报;
    mcu_dp_value_update(DPID_GET_BOX_TEMPERATURE,当前电箱温度); //VALUE型数据上报;
    mcu_dp_value_update(DPID_GET_MOTOR_CURRENT,当前电机电流(输出)); //VALUE型数据上报;
    mcu_dp_value_update(DPID_MOTOR_REALITY_SPEED,当前电机实际转速); //VALUE型数据上报;
    mcu_dp_value_update(DPID_MOTOR_BUS_VOLTAGE,当前母线电压(输入)); //VALUE型数据上报;
    mcu_dp_value_update(DPID_SEND_REALITY_SPEED,当前下发转速); //VALUE型数据上报;
    mcu_dp_value_update(DPID_MOTOR_POWER,当前电机功率); //VALUE型数据上报;
    mcu_dp_value_update(DPID_MOTOR_BUS_CURRENTE,当前母线电流); //VALUE型数据上报;
    mcu_dp_value_update(DPID_OTA_PACK_SIZE,当前OTA包大小); //VALUE型数据上报;
    mcu_dp_value_update(DPID_SYSTEM_RUNNING_TIME,当前系统运行时间 (调试用)); //VALUE型数据上报;
    mcu_dp_value_update(DPID_NO_OPERATION_TIME,当前无操作时间 (调试用)); //VALUE型数据上报;
    mcu_dp_value_update(DPID_SYSTEM_STARTUP_TIME,当前启动时间 (调试用)); //VALUE型数据上报;
    mcu_dp_value_update(DPID_THREAD_ACTIVITY_SIGN,当前线程活动标准); //VALUE型数据上报;
    mcu_dp_raw_update(DPID_SYSTEM_STATUS_MODE,当前模式+状态指针,当前模式+状态数据长度); //RAW型数据上报;
    mcu_dp_enum_update(DPID_SYSTEM_WORKING_MODE,当前工作模式); //枚举型数据上报;
    mcu_dp_enum_update(DPID_SYSTEM_WORKING_STATUS,当前系统状态机); //枚举型数据上报;
    mcu_dp_value_update(DPID_MOTOR_CURRENT_SPEED,当前当前转速); //VALUE型数据上报;
    mcu_dp_value_update(DPID_MOTOR_CURRENT_TIME,当前当前时间); //VALUE型数据上报;
    mcu_dp_raw_update(DPID_MODE_STATUS_SPEED_TIME,当前模式+状态+速度+时间指针,当前模式+状态+速度+时间数据长度); //RAW型数据上报;
    mcu_dp_value_update(DPID_FREE_MODE_SPEEN,当前自由模式默认速度); //VALUE型数据上报;
    mcu_dp_value_update(DPID_TIMING_MODE_SPEEN,当前定时模式默认速度); //VALUE型数据上报;
    mcu_dp_value_update(DPID_TIMING_MODE_TIME,当前定时模式默认时间); //VALUE型数据上报;
    mcu_dp_raw_update(DPID_SET_TRAIN_PLAN_01,当前训练计划01指针,当前训练计划01数据长度); //RAW型数据上报;
    mcu_dp_raw_update(DPID_SET_TRAIN_PLAN_02,当前训练计划02指针,当前训练计划02数据长度); //RAW型数据上报;
    mcu_dp_raw_update(DPID_SET_TRAIN_PLAN_03,当前训练计划03指针,当前训练计划03数据长度); //RAW型数据上报;
    mcu_dp_raw_update(DPID_SET_TRAIN_PLAN_04,当前训练计划04指针,当前训练计划04数据长度); //RAW型数据上报;
    mcu_dp_raw_update(DPID_SET_TRAIN_PLAN_05,当前训练计划05指针,当前训练计划05数据长度); //RAW型数据上报;
    mcu_dp_raw_update(DPID_CUSTOM_TRAIN_PLAN_01,当前自定义训练计划_01指针,当前自定义训练计划_01数据长度); //RAW型数据上报;
    mcu_dp_raw_update(DPID_CUSTOM_TRAIN_PLAN_02,当前自定义训练计划_02指针,当前自定义训练计划_02数据长度); //RAW型数据上报;
    mcu_dp_raw_update(DPID_CUSTOM_TRAIN_PLAN_03,当前自定义训练计划_03指针,当前自定义训练计划_03数据长度); //RAW型数据上报;
    mcu_dp_value_update(DPID_FINISH_STATISTICS_TIME,当前完成统计_时长); //VALUE型数据上报;
    mcu_dp_value_update(DPID_FINISH_STATISTICS_SEED,当前完成统计_游泳强度); //VALUE型数据上报;
    mcu_dp_value_update(DPID_FINISH_STATISTICS_DISTANCE,当前完成统计_距离); //VALUE型数据上报;
    
    mcu_dp_value_update(DPID_DRIVE_NTC_TEMP_01,当前驱动板NTC温度_01); //VALUE型数据上报;
		mcu_dp_value_update(DPID_DRIVE_NTC_TEMP_02,当前驱动板NTC温度_02); //VALUE型数据上报;
		mcu_dp_value_update(DPID_DRIVE_NTC_TEMP_03,当前驱动板NTC温度_03); //VALUE型数据上报;
    */	
		
DEBUG_IO_02_OFF(); // 需要 1.4s
		
		mcu_dp_value_update(DPID_PREPARATION_TIME,				*p_Preparation_Time_BIT); 			// 准备时间(APP管理,本地只负责保存)
		mcu_dp_value_update(DPID_DEVICE_ERROR_CODE,				*p_Motor_Fault_Static); 				// 驱动板故障
    mcu_dp_fault_update(DPID_GET_SYSTEM_FAULT_STATUS,	*p_System_Fault_Static); 				// 系统 故障型数据上报
    mcu_dp_value_update(DPID_GET_MOS_TEMPERATURE,			*p_Mos_Temperature); 						// MOS温度
    mcu_dp_value_update(DPID_GET_BOX_TEMPERATURE,			*p_Box_Temperature); 						// 机箱温度
		//osDelay(THREAD_PERIOD_WIFI_TASK);		// 退出
    mcu_dp_value_update(DPID_GET_MOTOR_CURRENT,				*p_Motor_Current); 							// 输出电流（电机)
    mcu_dp_value_update(DPID_MOTOR_REALITY_SPEED,			*p_Motor_Reality_Speed); 			// 实际转速;
    mcu_dp_value_update(DPID_MOTOR_BUS_VOLTAGE,				*p_Motor_Bus_Voltage); 					// 输入电压（母线）;
    mcu_dp_value_update(DPID_SEND_REALITY_SPEED,			*p_Send_Reality_Speed); 			// 下发转速;
    mcu_dp_value_update(DPID_MOTOR_POWER,							*p_Motor_Reality_Power); 				// 当前功率;
		//osDelay(THREAD_PERIOD_WIFI_TASK);		// 退出
    mcu_dp_value_update(DPID_MOTOR_BUS_CURRENTE,			*p_Motor_Bus_Current); 					// 输入电流（母线）;
    mcu_dp_raw_update(DPID_SYSTEM_STATUS_MODE,				(unsigned char *)p_PMode_Now,	4);		// 合并上传;
		mcu_dp_enum_update(DPID_SYSTEM_WORKING_MODE,			Get_System_State_Mode());						// 工作模式;
		mcu_dp_enum_update(DPID_SYSTEM_WORKING_STATUS,		Get_System_State_Machine());				// 状态机;
		mcu_dp_value_update(DPID_MOTOR_CURRENT_SPEED,			*p_OP_ShowNow_Speed);								// 当前速度;
		//osDelay(THREAD_PERIOD_WIFI_TASK);		// 退出
		mcu_dp_value_update(DPID_MOTOR_CURRENT_TIME,			*p_OP_ShowNow_Time);								// 当前时间;
		mcu_dp_value_update(DPID_FREE_MODE_SPEEN,					p_OP_Free_Mode->speed);					// 自由模式 速度;
		mcu_dp_value_update(DPID_TIMING_MODE_SPEEN,				p_OP_Timing_Mode->speed);				// 定时模式 速度;
		mcu_dp_value_update(DPID_TIMING_MODE_TIME,				p_OP_Timing_Mode->time);				// 定时模式 时间;
		mcu_dp_enum_update(DPID_INVERJET_MODEL_NO,				Get_DataAddr_Value(MB_FUNC_READ_INPUT_REGISTER , MB_MACHINE_MODEL_CODE));	//	机型码); //枚举型数据上报;
		//osDelay(THREAD_PERIOD_WIFI_TASK);		// 退出
		mcu_dp_value_update(DPID_OTA_PACK_SIZE,						Get_DataAddr_Value(MB_FUNC_READ_HOLDING_REGISTER,MB_DEBUG_OTA_PAGE_SIZE)); // ota 包大小
		mcu_dp_value_update(DPID_SYSTEM_RUNNING_TIME,			*p_System_Runing_Second_Cnt); 	// 运行时间;
		mcu_dp_value_update(DPID_NO_OPERATION_TIME,				*p_No_Operation_Second_Cnt);		// 无操作时间;
		mcu_dp_value_update(DPID_SYSTEM_STARTUP_TIME,			*p_System_Startup_Second_Cnt);	// 启动 时间;
		//mcu_dp_value_update(DPID_THREAD_ACTIVITY_SIGN,		*p_Thread_Activity_Sign);						//线程活动标志;
		//osDelay(THREAD_PERIOD_WIFI_TASK);		// 退出
		mcu_dp_raw_update(DPID_SET_TRAIN_PLAN_01,			(unsigned char *)p_OP_PMode[0],	TRAINING_MODE_PERIOD_MAX*4); // 训练计划 P1
		//osDelay(THREAD_PERIOD_WIFI_TASK);		// 退出
		mcu_dp_raw_update(DPID_SET_TRAIN_PLAN_02,			(unsigned char *)p_OP_PMode[1],	TRAINING_MODE_PERIOD_MAX*4); // 训练计划 P2
		//osDelay(THREAD_PERIOD_WIFI_TASK);		// 退出
		mcu_dp_raw_update(DPID_SET_TRAIN_PLAN_03,			(unsigned char *)p_OP_PMode[2],	TRAINING_MODE_PERIOD_MAX*4); // 训练计划 P3
		//osDelay(THREAD_PERIOD_WIFI_TASK);		// 退出
		mcu_dp_raw_update(DPID_SET_TRAIN_PLAN_04,			(unsigned char *)p_OP_PMode[3],	TRAINING_MODE_PERIOD_MAX*4); // 训练计划 P4
		//mcu_dp_raw_update(DPID_SET_TRAIN_PLAN_05,	(unsigned char *)p_OP_PMode[4],	TRAINING_MODE_PERIOD_MAX*4); // 训练计划 P5

		//mcu_dp_raw_update(DPID_CUSTOM_TRAIN_PLAN_01,(unsigned char *),TRAINING_MODE_PERIOD_MAX*4); // 自定义训练计划_01;
		//mcu_dp_raw_update(DPID_CUSTOM_TRAIN_PLAN_02,当前自定义训练计划_02指针,TRAINING_MODE_PERIOD_MAX*4); //自定义训练计划_02;
		//mcu_dp_raw_update(DPID_CUSTOM_TRAIN_PLAN_03,当前自定义训练计划_03指针,TRAINING_MODE_PERIOD_MAX*4); //自定义训练计划_03;
	
		//mcu_dp_value_update(DPID_FINISH_STATISTICS_TIME,			*p_Finish_Statistics_Time); 			// 当前完成统计_时长
    //mcu_dp_value_update(DPID_FINISH_STATISTICS_SEED,			*p_Finish_Statistics_Speed); 			// 当前完成统计_游泳强度
    //mcu_dp_value_update(DPID_FINISH_STATISTICS_DISTANCE,	*p_Finish_Statistics_Distance); 	// 当前完成统计_距离
		
		//mcu_dp_value_update(DPID_DRIVE_NTC_TEMP_01,Get_DataAddr_Value(MB_FUNC_READ_INPUT_REGISTER , MB_MOSFET_TEMPERATURE_01)); //VALUE型数据上报;
		//mcu_dp_value_update(DPID_DRIVE_NTC_TEMP_02,Get_DataAddr_Value(MB_FUNC_READ_INPUT_REGISTER , MB_MOSFET_TEMPERATURE_02)); //VALUE型数据上报;
		//mcu_dp_value_update(DPID_DRIVE_NTC_TEMP_03,Get_DataAddr_Value(MB_FUNC_READ_INPUT_REGISTER , MB_MOSFET_TEMPERATURE_03)); //VALUE型数据上报;
DEBUG_IO_02_ON();
}


/******************************************************************************
                                WARNING!!!    
                            2:所有数据上报处理
自动化代码模板函数,具体请用户自行实现数据处理
******************************************************************************/

/*****************************************************************************
函数名称 : dp_download_preparation_time_handle
功能描述 : 针对DPID_PREPARATION_TIME的处理函数
输入参数 : value:数据源数据
        : length:数据长度
返回参数 : 成功返回:SUCCESS/失败返回:ERROR
使用说明 : 可下发可上报类型,需要在处理完数据后上报处理结果至app
*****************************************************************************/
static unsigned char dp_download_preparation_time_handle(const unsigned char value[], unsigned short length)
{
    //示例:当前DP类型为VALUE
    unsigned char ret;
    unsigned long preparation_time;

    preparation_time = mcu_get_dp_download_value(value,length);
    /*
    //VALUE type data processing

    */
		if(*p_Preparation_Time_BIT != preparation_time )
		{
			*p_Preparation_Time_BIT = preparation_time;
			//保存
			Write_MbBuffer_Later();
		}
    //There should be a report after processing the DP
    ret = mcu_dp_value_update(DPID_PREPARATION_TIME,*p_Preparation_Time_BIT);
    if(ret == SUCCESS)
        return SUCCESS;
    else
        return ERROR;
}
/*****************************************************************************
函数名称 : dp_download_system_status_mode_handle
功能描述 : 针对DPID_SYSTEM_STATUS_MODE的处理函数
输入参数 : value:数据源数据
        : length:数据长度
返回参数 : 成功返回:SUCCESS/失败返回:ERROR
使用说明 : 可下发可上报类型,需要在处理完数据后上报处理结果至app
*****************************************************************************/
static unsigned char dp_download_system_status_mode_handle(const unsigned char value[], unsigned short length)
{
    //示例:当前DP类型为RAW
    unsigned char ret;
		unsigned char system_working_mode;
		unsigned char system_working_status;
    /*
    //RAW type data processing
    */
		if(If_Accept_External_Control(BLOCK_WIFI_CONTROL))
		{
			system_working_mode = value[0] | value[1]<<8;
			system_working_status = value[2] | value[3]<<8;
			
			Set_System_State_Mode(system_working_mode);
			
			if(system_working_status <= TRAINING_MODE_STOP)
			{
				//	切换模式时
				if(Is_Change_System_Mode(system_working_status))
				{
					Set_System_State_Machine(system_working_status);
					Check_OP_All();		// 确保参数合法
				}
				else
				{
					Set_System_State_Machine(system_working_status);
					OP_Update_Mode();
				}
				Set_Ctrl_Mode_Type(CTRL_FROM_WIFI);//标记控制来源
			}
		}
    //There should be a report after processing the DP
    //ret = mcu_dp_raw_update(DPID_SYSTEM_STATUS_MODE,value,length);
		ret = mcu_dp_raw_update(DPID_SYSTEM_STATUS_MODE,(unsigned char *)p_PMode_Now,	4);
    if(ret == SUCCESS)
        return SUCCESS;
    else
        return ERROR;
}
/*****************************************************************************
函数名称 : dp_download_system_working_mode_handle
功能描述 : 针对DPID_SYSTEM_WORKING_MODE的处理函数
输入参数 : value:数据源数据
        : length:数据长度
返回参数 : 成功返回:SUCCESS/失败返回:ERROR
使用说明 : 可下发可上报类型,需要在处理完数据后上报处理结果至app
*****************************************************************************/
static unsigned char dp_download_system_working_mode_handle(const unsigned char value[], unsigned short length)
{
    //示例:当前DP类型为ENUM
    unsigned char ret;
    unsigned char system_working_mode;

    system_working_mode = mcu_get_dp_download_enum(value,length);
	
		System_Para_Set_PMode(system_working_mode,CTRL_FROM_WIFI);

    //There should be a report after processing the DP
    ret = mcu_dp_enum_update(DPID_SYSTEM_WORKING_MODE, Get_System_State_Mode());
    if(ret == SUCCESS)
        return SUCCESS;
    else
        return ERROR;
}
/*****************************************************************************
函数名称 : dp_download_system_working_status_handle
功能描述 : 针对DPID_SYSTEM_WORKING_STATUS的处理函数
输入参数 : value:数据源数据
        : length:数据长度
返回参数 : 成功返回:SUCCESS/失败返回:ERROR
使用说明 : 可下发可上报类型,需要在处理完数据后上报处理结果至app
*****************************************************************************/
static unsigned char dp_download_system_working_status_handle(const unsigned char value[], unsigned short length)
{
    //示例:当前DP类型为ENUM
    unsigned char ret;
    unsigned char system_working_status;

    system_working_status = mcu_get_dp_download_enum(value,length);
	
		System_Para_Set_Status(system_working_status, CTRL_FROM_WIFI);
	
    //There should be a report after processing the DP
    ret = mcu_dp_enum_update(DPID_SYSTEM_WORKING_STATUS, Get_System_State_Machine());
    if(ret == SUCCESS)
        return SUCCESS;
    else
        return ERROR;
}
/*****************************************************************************
函数名称 : dp_download_motor_current_speed_handle
功能描述 : 针对DPID_MOTOR_CURRENT_SPEED的处理函数
输入参数 : value:数据源数据
        : length:数据长度
返回参数 : 成功返回:SUCCESS/失败返回:ERROR
使用说明 : 可下发可上报类型,需要在处理完数据后上报处理结果至app
*****************************************************************************/
static unsigned char dp_download_motor_current_speed_handle(const unsigned char value[], unsigned short length)
{
    //示例:当前DP类型为VALUE
    unsigned char ret;
    unsigned long motor_current_speed;

    motor_current_speed = mcu_get_dp_download_value(value,length);
    /*
    //VALUE type data processing
    */
		System_Para_Set_Speed(motor_current_speed, CTRL_FROM_WIFI);
    //There should be a report after processing the DP
    ret = mcu_dp_value_update(DPID_MOTOR_CURRENT_SPEED,*p_OP_ShowNow_Speed);
    if(ret == SUCCESS)
        return SUCCESS;
    else
        return ERROR;
}
/*****************************************************************************
函数名称 : dp_download_motor_current_time_handle
功能描述 : 针对DPID_MOTOR_CURRENT_TIME的处理函数
输入参数 : value:数据源数据
        : length:数据长度
返回参数 : 成功返回:SUCCESS/失败返回:ERROR
使用说明 : 可下发可上报类型,需要在处理完数据后上报处理结果至app
*****************************************************************************/
static unsigned char dp_download_motor_current_time_handle(const unsigned char value[], unsigned short length)
{
    //示例:当前DP类型为VALUE
    unsigned char ret;
    unsigned long motor_current_time;

    motor_current_time = mcu_get_dp_download_value(value,length);
    /*
    //VALUE type data processing
    */
		System_Para_Set_Time(motor_current_time, CTRL_FROM_WIFI);

    //There should be a report after processing the DP
    ret = mcu_dp_value_update(DPID_MOTOR_CURRENT_TIME,*p_OP_ShowNow_Time);
    if(ret == SUCCESS)
        return SUCCESS;
    else
        return ERROR;
}
/*****************************************************************************
函数名称 : dp_download_mode_status_speed_time_handle
功能描述 : 针对DPID_MODE_STATUS_SPEED_TIME的处理函数
输入参数 : value:数据源数据
        : length:数据长度
返回参数 : 成功返回:SUCCESS/失败返回:ERROR
使用说明 : 可下发可上报类型,需要在处理完数据后上报处理结果至app
*****************************************************************************/
static unsigned char dp_download_mode_status_speed_time_handle(const unsigned char value[], unsigned short length)
{
    //示例:当前DP类型为RAW
    unsigned char ret;
		unsigned short system_working_mode;
		unsigned short system_working_status;
		unsigned short system_working_speed;
		unsigned short system_working_time;
    /*
    //RAW type data processing
    */
		if(If_Accept_External_Control(BLOCK_WIFI_CONTROL))
		{
			system_working_mode 	= value[0] | value[1]<<8;
			system_working_status = value[2] | value[3]<<8;
			system_working_speed 	= value[4] | value[5]<<8;
			system_working_time 	= value[6] | value[7]<<8;
			
			if(system_working_status <= TRAINING_MODE_STOP)
			{
				Set_System_State_Machine(system_working_status);
				
				Set_System_State_Mode(system_working_mode);
				
				if((system_working_speed < MOTOR_PERCENT_SPEED_MIX)&&(system_working_speed > 0))
				*p_OP_ShowNow_Speed = MOTOR_PERCENT_SPEED_MIX;
				else if(system_working_speed > MOTOR_PERCENT_SPEED_MAX)
					*p_OP_ShowNow_Speed = MOTOR_PERCENT_SPEED_MAX;
				else
					*p_OP_ShowNow_Speed = system_working_speed;
			
				if(system_working_time >= MOTOR_TIME_SHOW_MAX)
					system_working_time = MOTOR_TIME_SHOW_MAX - 1;
				*p_OP_ShowNow_Time = system_working_time;
				
				if(System_is_Power_Off())
				{
					System_Power_Off();
				}
				Set_Ctrl_Mode_Type(CTRL_FROM_WIFI);//标记控制来源
			}
		}
    //There should be a report after processing the DP
    ret = mcu_dp_raw_update(DPID_MODE_STATUS_SPEED_TIME,value,length);
    if(ret == SUCCESS)
        return SUCCESS;
    else
        return ERROR;
}
/*****************************************************************************
函数名称 : dp_download_free_mode_speen_handle
功能描述 : 针对DPID_FREE_MODE_SPEEN的处理函数
输入参数 : value:数据源数据
        : length:数据长度
返回参数 : 成功返回:SUCCESS/失败返回:ERROR
使用说明 : 可下发可上报类型,需要在处理完数据后上报处理结果至app
*****************************************************************************/
static unsigned char dp_download_free_mode_speen_handle(const unsigned char value[], unsigned short length)
{
    //示例:当前DP类型为VALUE
    unsigned char ret;
    unsigned long free_mode_speen;

    free_mode_speen = mcu_get_dp_download_value(value,length);
    /*
    //VALUE type data processing
    */
	if(p_OP_Free_Mode->speed != free_mode_speen)
	{
		if(free_mode_speen < MOTOR_PERCENT_SPEED_MIX)
			p_OP_Free_Mode->speed = MOTOR_PERCENT_SPEED_MIX;
		else if(free_mode_speen > MOTOR_PERCENT_SPEED_MAX)
			p_OP_Free_Mode->speed = MOTOR_PERCENT_SPEED_MAX;
		else
			p_OP_Free_Mode->speed = free_mode_speen;
		p_OP_Free_Mode->time = 0;
		//保存
		Write_MbBuffer_Later();
	}
    //There should be a report after processing the DP
    ret = mcu_dp_value_update(DPID_FREE_MODE_SPEEN,p_OP_Free_Mode->speed);
    if(ret == SUCCESS)
        return SUCCESS;
    else
        return ERROR;
}
/*****************************************************************************
函数名称 : dp_download_timing_mode_speen_handle
功能描述 : 针对DPID_TIMING_MODE_SPEEN的处理函数
输入参数 : value:数据源数据
        : length:数据长度
返回参数 : 成功返回:SUCCESS/失败返回:ERROR
使用说明 : 可下发可上报类型,需要在处理完数据后上报处理结果至app
*****************************************************************************/
static unsigned char dp_download_timing_mode_speen_handle(const unsigned char value[], unsigned short length)
{
    //示例:当前DP类型为VALUE
    unsigned char ret;
    unsigned long timing_mode_speen;

    timing_mode_speen = mcu_get_dp_download_value(value,length);
    /*
    //VALUE type data processing
    */
	if(p_OP_Timing_Mode->speed != timing_mode_speen)
	{
		if(timing_mode_speen < MOTOR_PERCENT_SPEED_MIX)
			p_OP_Timing_Mode->speed = MOTOR_PERCENT_SPEED_MIX;
		else if(timing_mode_speen > MOTOR_PERCENT_SPEED_MAX)
			p_OP_Timing_Mode->speed = MOTOR_PERCENT_SPEED_MAX;
		else
			p_OP_Timing_Mode->speed = timing_mode_speen;
		//保存
		Write_MbBuffer_Later();
	}
    //There should be a report after processing the DP
    ret = mcu_dp_value_update(DPID_TIMING_MODE_SPEEN,p_OP_Timing_Mode->speed);
    if(ret == SUCCESS)
        return SUCCESS;
    else
        return ERROR;
}
/*****************************************************************************
函数名称 : dp_download_timing_mode_time_handle
功能描述 : 针对DPID_TIMING_MODE_TIME的处理函数
输入参数 : value:数据源数据
        : length:数据长度
返回参数 : 成功返回:SUCCESS/失败返回:ERROR
使用说明 : 可下发可上报类型,需要在处理完数据后上报处理结果至app
*****************************************************************************/
static unsigned char dp_download_timing_mode_time_handle(const unsigned char value[], unsigned short length)
{
    //示例:当前DP类型为VALUE
    unsigned char ret;
    unsigned long timing_mode_time;

    timing_mode_time = mcu_get_dp_download_value(value,length);
    /*
    //VALUE type data processing
    */
	if(p_OP_Timing_Mode->time != timing_mode_time)
	{
		if(timing_mode_time < 180)
			p_OP_Timing_Mode->time = 180;
		else if(timing_mode_time >= MOTOR_TIME_SHOW_MAX)
			p_OP_Timing_Mode->time = (MOTOR_TIME_SHOW_MAX-1);
		else
			p_OP_Timing_Mode->time = timing_mode_time;
		//保存
		Write_MbBuffer_Later();
	}
    //There should be a report after processing the DP
    ret = mcu_dp_value_update(DPID_TIMING_MODE_TIME,p_OP_Timing_Mode->time);
    if(ret == SUCCESS)
        return SUCCESS;
    else
        return ERROR;
}
/*****************************************************************************
函数名称 : dp_download_set_train_plan_01_handle
功能描述 : 针对DPID_SET_TRAIN_PLAN_01的处理函数
输入参数 : value:数据源数据
        : length:数据长度
返回参数 : 成功返回:SUCCESS/失败返回:ERROR
使用说明 : 可下发可上报类型,需要在处理完数据后上报处理结果至app
*****************************************************************************/
static unsigned char dp_download_set_train_plan_01_handle(const unsigned char value[], unsigned short length)
{
    //示例:当前DP类型为RAW
    unsigned char ret;
    /*
    //RAW type data processing
    */
		my_memcpy(p_OP_PMode[0], value, length);
		//保存
	
    //There should be a report after processing the DP
    ret = mcu_dp_raw_update(DPID_SET_TRAIN_PLAN_01,value,length);
    if(ret == SUCCESS)
        return SUCCESS;
    else
        return ERROR;
}
/*****************************************************************************
函数名称 : dp_download_set_train_plan_02_handle
功能描述 : 针对DPID_SET_TRAIN_PLAN_02的处理函数
输入参数 : value:数据源数据
        : length:数据长度
返回参数 : 成功返回:SUCCESS/失败返回:ERROR
使用说明 : 可下发可上报类型,需要在处理完数据后上报处理结果至app
*****************************************************************************/
static unsigned char dp_download_set_train_plan_02_handle(const unsigned char value[], unsigned short length)
{
    //示例:当前DP类型为RAW
    unsigned char ret;
    /*
    //RAW type data processing
    */
		my_memcpy(p_OP_PMode[1], value, length);
		//保存
	
    //There should be a report after processing the DP
    ret = mcu_dp_raw_update(DPID_SET_TRAIN_PLAN_02,value,length);
    if(ret == SUCCESS)
        return SUCCESS;
    else
        return ERROR;
}
/*****************************************************************************
函数名称 : dp_download_set_train_plan_03_handle
功能描述 : 针对DPID_SET_TRAIN_PLAN_03的处理函数
输入参数 : value:数据源数据
        : length:数据长度
返回参数 : 成功返回:SUCCESS/失败返回:ERROR
使用说明 : 可下发可上报类型,需要在处理完数据后上报处理结果至app
*****************************************************************************/
static unsigned char dp_download_set_train_plan_03_handle(const unsigned char value[], unsigned short length)
{
    //示例:当前DP类型为RAW
    unsigned char ret;
    /*
    //RAW type data processing
    */
		my_memcpy(p_OP_PMode[2], value, length);
		//保存
	
    //There should be a report after processing the DP
    ret = mcu_dp_raw_update(DPID_SET_TRAIN_PLAN_03,value,length);
    if(ret == SUCCESS)
        return SUCCESS;
    else
        return ERROR;
}
/*****************************************************************************
函数名称 : dp_download_set_train_plan_04_handle
功能描述 : 针对DPID_SET_TRAIN_PLAN_04的处理函数
输入参数 : value:数据源数据
        : length:数据长度
返回参数 : 成功返回:SUCCESS/失败返回:ERROR
使用说明 : 可下发可上报类型,需要在处理完数据后上报处理结果至app
*****************************************************************************/
static unsigned char dp_download_set_train_plan_04_handle(const unsigned char value[], unsigned short length)
{
    //示例:当前DP类型为RAW
    unsigned char ret;
    /*
    //RAW type data processing
    */
		my_memcpy(p_OP_PMode[3], value, length);
		//保存
	
    //There should be a report after processing the DP
    ret = mcu_dp_raw_update(DPID_SET_TRAIN_PLAN_04,value,length);
    if(ret == SUCCESS)
        return SUCCESS;
    else
        return ERROR;
}
/*****************************************************************************
函数名称 : dp_download_set_train_plan_05_handle
功能描述 : 针对DPID_SET_TRAIN_PLAN_05的处理函数
输入参数 : value:数据源数据
        : length:数据长度
返回参数 : 成功返回:SUCCESS/失败返回:ERROR
使用说明 : 可下发可上报类型,需要在处理完数据后上报处理结果至app
*****************************************************************************/
static unsigned char dp_download_set_train_plan_05_handle(const unsigned char value[], unsigned short length)
{
    //示例:当前DP类型为RAW
    unsigned char ret;
    /*
    //RAW type data processing

    */
		my_memcpy(p_OP_PMode[4], value, length);
		//保存
	
    //There should be a report after processing the DP
    ret = mcu_dp_raw_update(DPID_SET_TRAIN_PLAN_05,value,length);
    if(ret == SUCCESS)
        return SUCCESS;
    else
        return ERROR;
}
/*****************************************************************************
函数名称 : dp_download_custom_train_plan_01_handle
功能描述 : 针对DPID_CUSTOM_TRAIN_PLAN_01的处理函数
输入参数 : value:数据源数据
        : length:数据长度
返回参数 : 成功返回:SUCCESS/失败返回:ERROR
使用说明 : 可下发可上报类型,需要在处理完数据后上报处理结果至app
*****************************************************************************/
static unsigned char dp_download_custom_train_plan_01_handle(const unsigned char value[], unsigned short length)
{
    //示例:当前DP类型为RAW
    unsigned char ret;
    /*
    //RAW type data processing

    */

    //There should be a report after processing the DP
    ret = mcu_dp_raw_update(DPID_CUSTOM_TRAIN_PLAN_01,value,length);
    if(ret == SUCCESS)
        return SUCCESS;
    else
        return ERROR;
}
/*****************************************************************************
函数名称 : dp_download_custom_train_plan_02_handle
功能描述 : 针对DPID_CUSTOM_TRAIN_PLAN_02的处理函数
输入参数 : value:数据源数据
        : length:数据长度
返回参数 : 成功返回:SUCCESS/失败返回:ERROR
使用说明 : 可下发可上报类型,需要在处理完数据后上报处理结果至app
*****************************************************************************/
static unsigned char dp_download_custom_train_plan_02_handle(const unsigned char value[], unsigned short length)
{
    //示例:当前DP类型为RAW
    unsigned char ret;
    /*
    //RAW type data processing

    */

    //There should be a report after processing the DP
    ret = mcu_dp_raw_update(DPID_CUSTOM_TRAIN_PLAN_02,value,length);
    if(ret == SUCCESS)
        return SUCCESS;
    else
        return ERROR;
}
/*****************************************************************************
函数名称 : dp_download_custom_train_plan_03_handle
功能描述 : 针对DPID_CUSTOM_TRAIN_PLAN_03的处理函数
输入参数 : value:数据源数据
        : length:数据长度
返回参数 : 成功返回:SUCCESS/失败返回:ERROR
使用说明 : 可下发可上报类型,需要在处理完数据后上报处理结果至app
*****************************************************************************/
static unsigned char dp_download_custom_train_plan_03_handle(const unsigned char value[], unsigned short length)
{
    //示例:当前DP类型为RAW
    unsigned char ret;
    /*
    //RAW type data processing

    */

    //There should be a report after processing the DP
    ret = mcu_dp_raw_update(DPID_CUSTOM_TRAIN_PLAN_03,value,length);
    if(ret == SUCCESS)
        return SUCCESS;
    else
        return ERROR;
}
/*****************************************************************************
函数名称 : dp_download_wifi_dp_upload_level_handle
功能描述 : 针对DPID_WIFI_DP_UPLOAD_LEVEL的处理函数
输入参数 : value:数据源数据
        : length:数据长度
返回参数 : 成功返回:SUCCESS/失败返回:ERROR
使用说明 : 可下发可上报类型,需要在处理完数据后上报处理结果至app
*****************************************************************************/
static unsigned char dp_download_wifi_dp_upload_level_handle(const unsigned char value[], unsigned short length)
{
    //示例:当前DP类型为VALUE
    unsigned char ret;
    unsigned long wifi_dp_upload_level;

    wifi_dp_upload_level = mcu_get_dp_download_value(value,length);
    /*
    //VALUE type data processing

    */
		*p_Wifi_DP_Upload_Level = wifi_dp_upload_level;
	
    //There should be a report after processing the DP
    ret = mcu_dp_value_update(DPID_WIFI_DP_UPLOAD_LEVEL,wifi_dp_upload_level);
    if(ret == SUCCESS)
        return SUCCESS;
    else
        return ERROR;
}




/******************************************************************************
                                WARNING!!!                     
此部分函数用户请勿修改!!
******************************************************************************/

/**
 * @brief  dp下发处理函数
 * @param[in] {dpid} dpid 序号
 * @param[in] {value} dp数据缓冲区地址
 * @param[in] {length} dp数据长度
 * @return dp处理结果
 * -           0(ERROR): 失败
 * -           1(SUCCESS): 成功
 * @note   该函数用户不能修改
 */
unsigned char dp_download_handle(unsigned char dpid,const unsigned char value[], unsigned short length)
{
    /*********************************
    当前函数处理可下发/可上报数据调用                    
    具体函数内需要实现下发数据处理
    完成用需要将处理结果反馈至APP端,否则APP会认为下发失败
    ***********************************/
    unsigned char ret;
    switch(dpid) {
        case DPID_PREPARATION_TIME:
            //预备时间（标志位）处理函数
            ret = dp_download_preparation_time_handle(value,length);
        break;
        case DPID_SYSTEM_STATUS_MODE:
            //模式+状态处理函数
            ret = dp_download_system_status_mode_handle(value,length);
        break;
        case DPID_SYSTEM_WORKING_MODE:
            //工作模式处理函数
            ret = dp_download_system_working_mode_handle(value,length);
        break;
        case DPID_SYSTEM_WORKING_STATUS:
            //系统状态机处理函数
            ret = dp_download_system_working_status_handle(value,length);
        break;
        case DPID_MOTOR_CURRENT_SPEED:
            //当前转速处理函数
            ret = dp_download_motor_current_speed_handle(value,length);
        break;
        case DPID_MOTOR_CURRENT_TIME:
            //当前时间处理函数
            ret = dp_download_motor_current_time_handle(value,length);
        break;
        case DPID_MODE_STATUS_SPEED_TIME:
            //模式+状态+速度+时间处理函数
            ret = dp_download_mode_status_speed_time_handle(value,length);
        break;
        case DPID_FREE_MODE_SPEEN:
            //自由模式默认速度处理函数
            ret = dp_download_free_mode_speen_handle(value,length);
        break;
        case DPID_TIMING_MODE_SPEEN:
            //定时模式默认速度处理函数
            ret = dp_download_timing_mode_speen_handle(value,length);
        break;
        case DPID_TIMING_MODE_TIME:
            //定时模式默认时间处理函数
            ret = dp_download_timing_mode_time_handle(value,length);
        break;
        case DPID_SET_TRAIN_PLAN_01:
            //训练计划01处理函数
            ret = dp_download_set_train_plan_01_handle(value,length);
        break;
        case DPID_SET_TRAIN_PLAN_02:
            //训练计划02处理函数
            ret = dp_download_set_train_plan_02_handle(value,length);
        break;
        case DPID_SET_TRAIN_PLAN_03:
            //训练计划03处理函数
            ret = dp_download_set_train_plan_03_handle(value,length);
        break;
        case DPID_SET_TRAIN_PLAN_04:
            //训练计划04处理函数
            ret = dp_download_set_train_plan_04_handle(value,length);
        break;
        case DPID_SET_TRAIN_PLAN_05:
            //训练计划05处理函数
            ret = dp_download_set_train_plan_05_handle(value,length);
        break;
        case DPID_CUSTOM_TRAIN_PLAN_01:
            //自定义训练计划_01处理函数
            ret = dp_download_custom_train_plan_01_handle(value,length);
        break;
        case DPID_CUSTOM_TRAIN_PLAN_02:
            //自定义训练计划_02处理函数
            ret = dp_download_custom_train_plan_02_handle(value,length);
        break;
        case DPID_CUSTOM_TRAIN_PLAN_03:
            //自定义训练计划_03处理函数
            ret = dp_download_custom_train_plan_03_handle(value,length);
        break;
        case DPID_WIFI_DP_UPLOAD_LEVEL:
            //上传等级处理函数
            ret = dp_download_wifi_dp_upload_level_handle(value,length);
        break;

        
        default:
        break;
    }
    return ret;
}

/**
 * @brief  获取所有dp命令总和
 * @param[in] Null
 * @return 下发命令总和
 * @note   该函数用户不能修改
 */
unsigned char get_download_cmd_total(void)
{
    return(sizeof(download_cmd) / sizeof(download_cmd[0]));
}


/******************************************************************************
                                WARNING!!!                     
此代码为SDK内部调用,请按照实际dp数据实现函数内部数据
******************************************************************************/

#ifdef SUPPORT_MCU_FIRM_UPDATE
/**
 * @brief  升级包大小选择
 * @param[in] {package_sz} 升级包大小
 * @ref           0x00: 256byte (默认)
 * @ref           0x01: 512byte
 * @ref           0x02: 1024byte
 * @return Null
 * @note   MCU需要自行实现该功能
 */
void upgrade_package_choose(unsigned char chan, unsigned char way, unsigned long package_sz)
{
	//#error "请自行实现请自行实现升级包大小选择代码,完成后请删除该行"
	unsigned short send_len = 0;
	if((way == OTA_WAY_APP_CONFIRM) || (System_To_OTA() == SUCCESS))
	{
		send_len = set_wifi_uart_byte(send_len, PACKAGE_SIZE);
		wifi_uart_write_frame(UPDATE_START_CMD, MCU_TX_VER, send_len);
		
		pack_sum = package_sz/1024;
		if(package_sz % 1024)
			pack_sum ++;
				
		Set_System_State_Machine(OTA_UPGRADE_STATUS);
		Data_Set_Current_Speed(0);//注意,需要在切完运行状态后再设置速度,如"暂停"
	
		Out_Of_Upgradation();
		Lcd_Show_Upgradation(pack_sum,0);
		Ota_Chan = chan;//bootloader
		Freertos_TaskSuspend_Wifi();
	}
}

/**
 * @brief  MCU进入固件升级模式
 * @param[in] {value} 固件缓冲区
 * @param[in] {position} 当前数据包在于固件位置
 * @param[in] {length} 当前固件包长度(固件包长度为0时,表示固件包发送完成)
 * @return Null
 * @note   MCU需要自行实现该功能
 */
unsigned char mcu_firm_update_handle(const unsigned char value[],unsigned long position,unsigned short length)
{
    //#error "请自行完成MCU固件升级代码,完成后请删除该行"
		unsigned long write_addr=0;						// flash 写入地址
		unsigned long sign=0;
		
		if(Ota_Chan == 0)
			return ERROR;
	
    if(length == 0) {
			if(Ota_Chan == 10)
			{
				STMFLASH_Write(BOOT_FLASH_ADDR_OTA_PACK_LEN,(uint16_t*)&Wifi_OTA_Pack_Len,2); // 写包长度 (含crc)
				iap_Bootloader_Process();
			}
			else
			{
				taskENTER_CRITICAL();
        //固件数据发送完成
				STMFLASH_Write(BOOT_FLASH_ADDR_OTA_PACK_LEN,(uint16_t*)&Wifi_OTA_Pack_Len,2); // 写包长度 (含crc)
				sign = PRODUCT_BOOT_PASSWORD;
				STMFLASH_Write(BOOT_FLASH_ADDR_OTA_PASSWORD,(uint16_t*)&sign,2); 		// 进入OTA
				sign = FLASH_APP_PATCH_ADDR;
				STMFLASH_Write(BOOT_FLASH_ADDR_OTA_PACK_ADDR,(uint16_t*)&sign,2); 	// 程序升级包 地址
				sign = FLASH_APP_PARAM_ADDR;
				STMFLASH_Write(BOOT_FLASH_ADDR_APP_PARAM_ADDR,(uint16_t*)&sign,2); 	// app 程序参数 地址
				sign = FLASH_APP_PROGRAM_PAGE;
				STMFLASH_Write(BOOT_FLASH_ADDR_OTA_PACK_SIZE,(uint16_t*)&sign,2); 	// 程序升级包 大小
				taskEXIT_CRITICAL();
			}
			
			SysSoftReset();// 软件复位
    }else {
        //固件数据处理
      if(position == REG_FILE_NUMBER_STAR) // 起始包
			{Wifi_OTA_Pack_Len = 0;}
			
			taskENTER_CRITICAL();
			write_addr = (FLASH_APP_PATCH_ADDR + Wifi_OTA_Pack_Len);
			iap_write_appbin(write_addr,(unsigned char*)value,length/2);
			Wifi_OTA_Pack_Len += (length);
			taskEXIT_CRITICAL();
    }
		Lcd_Show_Upgradation(pack_sum,(++pack_cnt*100)/pack_sum);//(num*100)/sum;
		
    return SUCCESS;
}
#endif

#ifdef SUPPORT_GREEN_TIME
/**
 * @brief  获取到的格林时间
 * @param[in] {time} 获取到的格林时间数据
 * @return Null
 * @note   MCU需要自行实现该功能
 */
void mcu_get_greentime(unsigned char time[])
{
    //#error "请自行完成相关代码,并删除该行"
    /*
    time[0] 为是否获取时间成功标志，为 0 表示失败，为 1表示成功
    time[1] 为年份，0x00 表示 2000 年
    time[2] 为月份，从 1 开始到12 结束
    time[3] 为日期，从 1 开始到31 结束
    time[4] 为时钟，从 0 开始到23 结束
    time[5] 为分钟，从 0 开始到59 结束
    time[6] 为秒钟，从 0 开始到59 结束
    */
    if(time[0] == 1) {
        //正确接收到wifi模块返回的格林数据
        *p_Wifi_Timing_Value = time[6];  //要秒就好
    }else {
        //获取格林时间出错,有可能是当前wifi模块未联网
    }
}
#endif

#ifdef SUPPORT_MCU_RTC_CHECK
/**
 * @brief  MCU校对本地RTC时钟
 * @param[in] {time} 获取到的格林时间数据
 * @return Null
 * @note   MCU需要自行实现该功能
 */
void mcu_write_rtctime(unsigned char time[])
{
    //#error "请自行完成RTC时钟写入代码,并删除该行"
    /*
    Time[0] 为是否获取时间成功标志，为 0 表示失败，为 1表示成功
    Time[1] 为年份，0x00 表示 2000 年
    Time[2] 为月份，从 1 开始到12 结束
    Time[3] 为日期，从 1 开始到31 结束
    Time[4] 为时钟，从 0 开始到23 结束
    Time[5] 为分钟，从 0 开始到59 结束
    Time[6] 为秒钟，从 0 开始到59 结束
    Time[7] 为星期，从 1 开始到 7 结束，1代表星期一
   */
    if(time[0] == 1) {
        //正确接收到wifi模块返回的本地时钟数据
     *p_Wifi_Timing_Value = time[6] + time[5]*60 + time[4]*60*60;  //要秒就好
    }else {
        //获取本地时钟数据出错,有可能是当前wifi模块未联网
    }
}
#endif

#ifdef WIFI_TEST_ENABLE
/**
 * @brief  wifi功能测试反馈
 * @param[in] {result} wifi功能测试结果
 * @ref       0: 失败
 * @ref       1: 成功
 * @param[in] {rssi} 测试成功表示wifi信号强度/测试失败表示错误类型
 * @return Null
 * @note   MCU需要自行实现该功能
 */
void wifi_test_result(unsigned char result,unsigned char rssi)
{
    //#error "请自行实现wifi功能测试成功/失败代码,完成后请删除该行"
	
	if(result == 0) {
        //测试失败
        if(rssi == 0x00) {
            //未扫描到名称为tuya_mdev_test路由器,请检查
        }else if(rssi == 0x01) {
            //模块未授权
        }
    }else {
        //测试成功
        //rssi为信号强度(0-100, 0信号最差，100信号最强)
    }
		
		*p_WIFI_Rssi = rssi;
}
#endif

#ifdef WEATHER_ENABLE
/**
* @brief  mcu打开天气服务
 * @param  Null
 * @return Null
 */
void mcu_open_weather(void)
{
    int i = 0;
    char buffer[13] = {0};
    unsigned char weather_len = 0;
    unsigned short send_len = 0;
    
    weather_len = sizeof(weather_choose) / sizeof(weather_choose[0]);
      
    for(i=0;i<weather_len;i++) {
        buffer[0] = sprintf(buffer+1,"w.%s",weather_choose[i]);
        send_len = set_wifi_uart_buffer(send_len, (unsigned char *)buffer, buffer[0]+1);
    }
    
    #error "请根据提示，自行完善打开天气服务代码，完成后请删除该行"
    /*
    //当获取的参数有和时间有关的参数时(如:日出日落)，需要搭配t.unix或者t.local使用，需要获取的参数数据是按照格林时间还是本地时间
    buffer[0] = sprintf(buffer+1,"t.unix"); //格林时间   或使用  buffer[0] = sprintf(buffer+1,"t.local"); //本地时间
    send_len = set_wifi_uart_buffer(send_len, (unsigned char *)buffer, buffer[0]+1);
    */

    buffer[0] = sprintf(buffer+1,"w.date.%d",WEATHER_FORECAST_DAYS_NUM);
    send_len = set_wifi_uart_buffer(send_len, (unsigned char *)buffer, buffer[0]+1);
    
    wifi_uart_write_frame(WEATHER_OPEN_CMD, MCU_TX_VER, send_len);
}

/**
 * @brief  打开天气功能返回用户自处理函数
 * @param[in] {res} 打开天气功能返回结果
 * @ref       0: 失败
 * @ref       1: 成功
 * @param[in] {err} 错误码
 * @return Null
 * @note   MCU需要自行实现该功能
 */
void weather_open_return_handle(unsigned char res, unsigned char err)
{
    #error "请自行完成打开天气功能返回数据处理代码,完成后请删除该行"
    unsigned char err_num = 0;
    
    if(res == 1) {
        //打开天气返回成功
    }else if(res == 0) {
        //打开天气返回失败
        //获取错误码
        err_num = err; 
    }
}

/**
 * @brief  天气数据用户自处理函数
 * @param[in] {name} 参数名
 * @param[in] {type} 参数类型
 * @ref       0: int 型
 * @ref       1: string 型
 * @param[in] {data} 参数值的地址
 * @param[in] {day} 哪一天的天气  0:表示当天 取值范围: 0~6
 * @ref       0: 今天
 * @ref       1: 明天
 * @return Null
 * @note   MCU需要自行实现该功能
 */
void weather_data_user_handle(char *name, unsigned char type, const unsigned char *data, char day)
{
    #error "这里仅给出示例，请自行完善天气数据处理代码,完成后请删除该行"
    int value_int;
    char value_string[50];//由于有的参数内容较多，这里默认为50。您可以根据定义的参数，可以适当减少该值
    
    my_memset(value_string, '\0', 50);
    
    //首先获取数据类型
    if(type == 0) { //参数是INT型
        value_int = data[0] << 24 | data[1] << 16 | data[2] << 8 | data[3];
    }else if(type == 1) {
        my_strcpy(value_string, data);
    }
    
    //注意要根据所选参数类型来获得参数值！！！
    if(my_strcmp(name, "temp") == 0) {
        printf("day:%d temp value is:%d\r\n", day, value_int);          //int 型
    }else if(my_strcmp(name, "humidity") == 0) {
        printf("day:%d humidity value is:%d\r\n", day, value_int);      //int 型
    }else if(my_strcmp(name, "pm25") == 0) {
        printf("day:%d pm25 value is:%d\r\n", day, value_int);          //int 型
    }else if(my_strcmp(name, "condition") == 0) {
        printf("day:%d condition value is:%s\r\n", day, value_string);  //string 型
    }
}
#endif

#ifdef MCU_DP_UPLOAD_SYN
/**
 * @brief  状态同步上报结果
 * @param[in] {result} 结果
 * @ref       0: 失败
 * @ref       1: 成功
 * @return Null
 * @note   MCU需要自行实现该功能
 */
void get_upload_syn_result(unsigned char result)
{
    #error "请自行完成状态同步上报结果代码,并删除该行"
      
    if(result == 0) {
        //同步上报出错
    }else {
        //同步上报成功
    }
}
#endif

#ifdef GET_WIFI_STATUS_ENABLE
/**
 * @brief  获取 WIFI 状态结果
 * @param[in] {result} 指示 WIFI 工作状态
 * @ref       0x00: wifi状态 1 smartconfig 配置状态
 * @ref       0x01: wifi状态 2 AP 配置状态
 * @ref       0x02: wifi状态 3 WIFI 已配置但未连上路由器
 * @ref       0x03: wifi状态 4 WIFI 已配置且连上路由器
 * @ref       0x04: wifi状态 5 已连上路由器且连接到云端
 * @ref       0x05: wifi状态 6 WIFI 设备处于低功耗模式
 * @ref       0x06: wifi状态 7 WIFI 设备处于smartconfig&AP配置状态
 * @return Null
 * @note   MCU需要自行实现该功能
 */
void get_wifi_status(unsigned char result)
{
  #error "请自行完成获取 WIFI 状态结果代码,并删除该行"
 
    switch(result) {
        case 0:
            //wifi工作状态1
        break;
    
        case 1:
            //wifi工作状态2
        break;
        
        case 2:
            //wifi工作状态3
        break;
        
        case 3:
            //wifi工作状态4
        break;
        
        case 4:
            //wifi工作状态5
        break;
        
        case 5:
            //wifi工作状态6
        break;
      
        case 6:
            //wifi工作状态7
        break;
        
        default:break;
    }
}
#endif

#ifdef WIFI_STREAM_ENABLE
/**
 * @brief  流服务发送结果
 * @param[in] {result} 结果
 * @ref       0x00: 成功
 * @ref       0x01: 流服务功能未开启
 * @ref       0x02: 流服务器未连接成功
 * @ref       0x03: 数据推送超时
 * @ref       0x04: 传输的数据长度错误
 * @return Null
 * @note   MCU需要自行实现该功能
 */
void stream_trans_send_result(unsigned char result)
{
    #error "这里仅给出示例，请自行完善流服务发送结果处理代码,完成后请删除该行"
    switch(result) {
        case 0x00:
            //成功
        break;
        
        case 0x01:
            //流服务功能未开启
        break;
        
        case 0x02:
            //流服务器未连接成功
        break;
        
        case 0x03:
            //数据推送超时
        break;
        
        case 0x04:
            //传输的数据长度错误
        break;
        
        default:break;
    }
}

/**
 * @brief  多地图流服务发送结果
 * @param[in] {result} 结果
 * @ref       0x00: 成功
 * @ref       0x01: 失败
 * @return Null
 * @note   MCU需要自行实现该功能
 */
void maps_stream_trans_send_result(unsigned char result)
{
    #error "这里仅给出示例，请自行完善多地图流服务发送结果处理代码,完成后请删除该行"
    switch(result) {
        case 0x00:
            //成功
        break;
        
        case 0x01:
            //失败
        break;
        
        default:break;
    }
}
#endif

#ifdef WIFI_CONNECT_TEST_ENABLE
/**
 * @brief  路由信息接收结果通知
 * @param[in] {result} 模块是否成功接收到正确的路由信息
 * @ref       0x00: 失败
 * @ref       0x01: 成功
 * @return Null
 * @note   MCU需要自行实现该功能
 */
void wifi_connect_test_result(unsigned char result)
{
    #error "请自行实现wifi功能测试成功/失败代码,完成后请删除该行"
    if(result == 0) {
        //路由信息接收失败，请检查发出的路由信息包是否是完整的JSON数据包
    }else {
        //路由信息接收成功，产测结果请注意WIFI_STATE_CMD指令的wifi工作状态
    }
}
#endif

#ifdef GET_MODULE_MAC_ENABLE
/**
 * @brief  获取模块mac结果
 * @param[in] {mac} 模块 MAC 数据
 * @ref       mac[0]: 为是否获取mac成功标志，0x00 表示成功，0x01 表示失败
 * @ref       mac[1]~mac[6]: 当获取 MAC地址标志位如果mac[0]为成功，则表示模块有效的MAC地址
 * @return Null
 * @note   MCU需要自行实现该功能
 */
void mcu_get_mac(unsigned char mac[])
{
    #error "请自行完成mac获取代码,并删除该行"
    /*
    mac[0]为是否获取mac成功标志，0x00 表示成功，为0x01表示失败
    mac[1]~mac[6]:当获取 MAC地址标志位如果mac[0]为成功，则表示模块有效的MAC地址
   */
   
    if(mac[0] == 1) {
        //获取mac出错
    }else {
        //正确接收到wifi模块返回的mac地址
    }
}
#endif

#ifdef GET_IR_STATUS_ENABLE
/**
 * @brief  获取红外状态结果
 * @param[in] {result} 指示红外状态
 * @ref       0x00: 红外状态 1 正在发送红外码
 * @ref       0x01: 红外状态 2 发送红外码结束
 * @ref       0x02: 红外状态 3 红外学习开始
 * @ref       0x03: 红外状态 4 红外学习结束
 * @return Null
 * @note   MCU需要自行实现该功能
 */
void get_ir_status(unsigned char result)
{
    #error "请自行完成红外状态代码,并删除该行"
    switch(result) {
        case 0:
            //红外状态 1
        break;
      
        case 1:
            //红外状态 2
        break;
          
        case 2:
            //红外状态 3
        break;
          
        case 3:
            //红外状态 4
        break;
          
        default:break;
    }
    
    wifi_uart_write_frame(GET_IR_STATUS_CMD, MCU_TX_VER, 0);
}
#endif

#ifdef IR_TX_RX_TEST_ENABLE
/**
 * @brief  红外进入收发产测结果通知
 * @param[in] {result} 模块是否成功接收到正确的信息
 * @ref       0x00: 失败
 * @ref       0x01: 成功
 * @return Null
 * @note   MCU需要自行实现该功能
 */
void ir_tx_rx_test_result(unsigned char result)
{
    #error "请自行实现红外进入收发产测功能测试成功/失败代码,完成后请删除该行"
    if(result == 0) {
        //红外进入收发产测成功
    }else {
        //红外进入收发产测失败，请检查发出的数据包
    }
}
#endif

#ifdef FILE_DOWNLOAD_ENABLE
/**
 * @brief  文件下载包大小选择
 * @param[in] {package_sz} 文件下载包大小
 * @ref       0x00: 256 byte (默认)
 * @ref       0x01: 512 byte
 * @ref       0x02: 1024 byte
 * @return Null
 * @note   MCU需要自行实现该功能
 */
void file_download_package_choose(unsigned char package_sz)
{
    #error "请自行实现请自行实现文件下载包大小选择代码,完成后请删除该行"
    unsigned short send_len = 0;
    send_len = set_wifi_uart_byte(send_len, package_sz);
    wifi_uart_write_frame(FILE_DOWNLOAD_START_CMD, MCU_TX_VER, send_len);
}

/**
 * @brief  文件包下载模式
 * @param[in] {value} 数据缓冲区
 * @param[in] {position} 当前数据包在于文件位置
 * @param[in] {length} 当前文件包长度(长度为0时,表示文件包发送完成)
 * @return 数据处理结果
 * -           0(ERROR): 失败
 * -           1(SUCCESS): 成功
 * @note   MCU需要自行实现该功能
 */
unsigned char file_download_handle(const unsigned char value[],unsigned long position,unsigned short length)
{
    #error "请自行完成文件包下载代码,完成后请删除该行"
    if(length == 0) {
        //文件包数据发送完成
        
    }else {
        //文件包数据处理
      
    }
    
    return SUCCESS;
}
#endif

#ifdef MODULE_EXPANDING_SERVICE_ENABLE
/**
 * @brief  打开模块时间服务通知结果
 * @param[in] {value} 数据缓冲区
 * @param[in] {length} 数据长度
 * @return Null
 * @note   MCU需要自行实现该功能
 */
void open_module_time_serve_result(const unsigned char value[], unsigned short length)
{
    #error "请自行实现模块时间服务通知结果代码,完成后请删除该行"
    unsigned char sub_cmd = value[0];
    
    switch(sub_cmd) {
        case 0x01: { //子命令  打开模块时间服务通知
            if(0x02 != length) {
                //数据长度错误
                return;
            }
            
            if(value[1] == 0) {
                //服务开启成功
            }else {
                //服务开启失败
            }
        }
        break;
        
        case 0x02: {  //子命令  模块时间服务通知
            if(0x09 != length) {
                //数据长度错误
                return;
            }
            
            unsigned char time_type = value[1]; //0x00:格林时间  0x01:本地时间
            unsigned char time_data[7];
            
            my_memcpy(time_data, value + 2, length - 2);
            /*
            Data[0]为年份, 0x00表示2000年
            Data[1]为月份，从1开始到12结束
            Data[2]为日期，从1开始到31结束
            Data[3]为时钟，从0开始到23结束
            Data[4]为分钟，从0开始到59结束
            Data[5]为秒钟，从0开始到15结束
            Data[6]为星期，从1开始到7结束，1代表星期一
            */
            
            //在此处添加时间数据处理代码，time_type为时间类型
            
            unsigned short send_len = 0;
            send_len = set_wifi_uart_byte(send_len,sub_cmd);
            wifi_uart_write_frame(MODULE_EXTEND_FUN_CMD, MCU_TX_VER, send_len);
        }
        break;
        
        case 0x03: {  //子命令  主动请求天气服务数据
            if(0x02 != length) {
                //数据长度错误
                return;
            }
            
            if(value[1] == 0) {
                //成功
            }else {
                //失败
            }
        }
        break;
        
        case 0x04: {  //子命令  打开模块重置状态通知
            if(0x02 != length) {
                //数据长度错误
                return;
            }
            
            if(value[1] == 0) {
                //成功
            }else {
                //失败
            }
        }
        break;
        
        case 0x05: {  //子命令  模块重置状态通知
            if(0x02 != length) {
                //数据长度错误
                return;
            }
            
            switch(value[1]) {
                case 0x00:
                    //模块本地重置
                    
                break;
                case 0x01:
                    //APP远程重置
                    
                break;
                case 0x02:
                    //APP恢复出厂重置
                    
                break;
                default:break;
            }
            
            unsigned short send_len = 0;
            send_len = set_wifi_uart_byte(send_len, sub_cmd);
            wifi_uart_write_frame(MODULE_EXTEND_FUN_CMD, MCU_TX_VER, send_len);
        }
        break;
        
        default:break;
    }
}
#endif

#ifdef BLE_RELATED_FUNCTION_ENABLE
/**
 * @brief  蓝牙功能性测试结果
 * @param[in] {value} 数据缓冲区
 * @param[in] {length} 数据长度
 * @return Null
 * @note   MCU需要自行实现该功能
 */
void BLE_test_result(const unsigned char value[], unsigned short length)
{
    #error "请自行实现蓝牙功能性测试结果代码,完成后请删除该行"
    unsigned char sub_cmd = value[0];
    
    if(0x03 != length) {
        //数据长度错误
        return;
    }
    
    if(0x01 != sub_cmd) {
        //子命令错误
        return;
    }
    
    unsigned char result = value[1];
    unsigned char rssi = value[2];
        
    if(result == 0) {
        //测试失败
        if(rssi == 0x00) {
            //未扫描到名称为 ty_mdev蓝牙信标,请检查
        }else if(rssi == 0x01) {
            //模块未授权
        }
    }else if(result == 0x01) {
        //测试成功
        //rssi为信号强度(0-100, 0信号最差，100信号最强)
    }
}
#endif

#ifdef VOICE_MODULE_PROTOCOL_ENABLE
/**
 * @brief  获取语音状态码结果
 * @param[in] {result} 语音状态码
 * @ref       0x00: 空闲
 * @ref       0x01: mic静音状态
 * @ref       0x02: 唤醒
 * @ref       0x03: 正在录音
 * @ref       0x04: 正在识别
 * @ref       0x05: 识别成功
 * @ref       0x06: 识别失败
 * @return Null
 * @note   MCU需要自行实现该功能
 */
void get_voice_state_result(unsigned char result)
{
    #error "请自行实现获取语音状态码结果处理代码,完成后请删除该行"
    switch(result) {
        case 0:
            //空闲
        break;
    
        case 1:
            //mic静音状态
        break;
        
        case 2:
            //唤醒
        break;
        
        case 3:
            //正在录音
        break;
        
        case 4:
            //正在识别
        break;
    
        case 5:
            //识别成功
        break;
        
        case 6:
            //识别失败
        break;
        
      default:break;
    }
}

/**
 * @brief  MIC静音设置结果
 * @param[in] {result} 语音状态码
 * @ref       0x00: mic 开启
 * @ref       0x01: mic 静音
 * @return Null
 * @note   MCU需要自行实现该功能
 */
void set_voice_MIC_silence_result(unsigned char result)
{
    #error "请自行实现MIC静音设置处理代码,完成后请删除该行"
    if(result == 0) {
        //mic 开启
    }else {
        //mic 静音
    }
}

/**
 * @brief  speaker音量设置结果
 * @param[in] {result} 音量值
 * @ref       0~10: 音量范围
 * @return Null
 * @note   MCU需要自行实现该功能
 */
void set_speaker_voice_result(unsigned char result)
{
    #error "请自行实现speaker音量设置结果处理代码,完成后请删除该行"
    
}

/**
 * @brief  音频产测结果
 * @param[in] {result} 音频产测状态
 * @ref       0x00: 关闭音频产测
 * @ref       0x01: mic1音频环路测试
 * @ref       0x02: mic2音频环路测试
 * @return Null
 * @note   MCU需要自行实现该功能
 */
void voice_test_result(unsigned char result)
{
    #error "请自行实现音频产测结果处理代码,完成后请删除该行"
    if(result == 0x00) {
        //关闭音频产测
    }else if(result == 0x01) {
        //mic1音频环路测试
    }else if(result == 0x02) {
        //mic2音频环路测试
    }
}

/**
 * @brief  唤醒产测结果
 * @param[in] {result} 唤醒返回值
 * @ref       0x00: 唤醒成功
 * @ref       0x01: 唤醒失败(10s超时失败)
 * @return Null
 * @note   MCU需要自行实现该功能
 */
void voice_awaken_test_result(unsigned char result)
{
    #error "请自行实现唤醒产测结果处理代码,完成后请删除该行"
    if(result == 0x00) {
        //唤醒成功
    }else if(result == 0x01) {
        //唤醒失败
    }
}

/**
 * @brief  语音模组扩展功能
 * @param[in] {value} 数据缓冲区
 * @param[in] {length} 数据长度
 * @return Null
 * @note   MCU需要自行实现该功能
 */
void voice_module_extend_fun(const unsigned char value[], unsigned short length)
{
    unsigned char sub_cmd = value[0];
    unsigned char play;
    unsigned char bt_play;
    unsigned short send_len = 0;
  
    switch(sub_cmd) {
        case 0x00: { //子命令  MCU功能设置
            if(0x02 != length) {
                //数据长度错误
                return;
            }
            
            if(value[1] == 0) {
                //成功
            }else {
                //失败
            }
        }
        break;
        
        case 0x01: {  //子命令  状态通知
            if(0x02 > length) {
                //数据长度错误
                return;
            }
            
            unsigned char play = 0xff;
            unsigned char bt_play = 0xff;
            
            const char *str_buff = (const char *)&value[1];
            const char *str_result = NULL;
            
            str_result = strstr(str_buff,"play") + my_strlen("play") + 2;
            if(NULL == str_result) {
                //数据错误
                goto ERR_EXTI;
            }
            
            if(0 == memcmp(str_result, "true", my_strlen("true"))) {
                play = 1;
            }else if(0 == memcmp(str_result, "false", my_strlen("false"))) {
                play = 0;
            }else {
                //数据错误
                goto ERR_EXTI;
            }
            
            str_result = strstr(str_buff,"bt_play") + my_strlen("bt_play") + 2;
            if(NULL == str_result) {
                //数据错误
                goto ERR_EXTI;
            }
            
            if(0 == memcmp(str_result, "true", my_strlen("true"))) {
                bt_play = 1;
            }else if(0 == memcmp(str_result, "false", my_strlen("false"))) {
                bt_play = 0;
            }else {
                //数据错误
                goto ERR_EXTI;
            }
            
            #error "请自行实现语音模组状态通知处理代码,完成后请删除该行"
            //MCU设置暂仅支持”播放/暂停” ”蓝牙开关”
            //play    播放/暂停功能  1(播放) / 0(暂停)
            //bt_play 蓝牙开关功能   1(开)   / 0(关)
            
            
            
            send_len = 0;
            send_len = set_wifi_uart_byte(send_len, sub_cmd);
            send_len = set_wifi_uart_byte(send_len, 0x00);
            wifi_uart_write_frame(MODULE_EXTEND_FUN_CMD, MCU_TX_VER, send_len);
        }
        break;

        default:break;
    }
    
    return;

ERR_EXTI:
    send_len = 0;
    send_len = set_wifi_uart_byte(send_len, sub_cmd);
    send_len = set_wifi_uart_byte(send_len, 0x01);
    wifi_uart_write_frame(MODULE_EXTEND_FUN_CMD, MCU_TX_VER, send_len);
    return;
}
#endif
