Marksman124/inverjet/inverjet_app/Core/app/model_parameter.c

/**
******************************************************************************
* @file				data.c
* @brief			数据管理模块
*
* @author			WQG
* @versions		v1.0
* @date				2024-6-15
******************************************************************************
*/

/* Includes ------------------------------------------------------------------*/
#include "model_parameter.h"


/* Private includes ----------------------------------------------------------*/


/* Private typedef -----------------------------------------------------------*/

// 拨码开关
uint8_t System_Dial_Switch = 0;

/* Private define ------------------------------------------------------------*/

/* Private macro -------------------------------------------------------------*/

uint32_t Product_Model_Ccode[MODEL_DIAL_SWITCH_NUMBER] = 
{
	PRODUCT_MODEL_CODE_SJ230,
	PRODUCT_MODEL_CODE_SJ200,
	PRODUCT_MODEL_CODE_SJ160,
	PRODUCT_MODEL_CODE_SJ100
};


/* Private user code ---------------------------------------------------------*/

//------------------- 获取机型码 ----------------------------
uint32_t Get_Model_Code_Num(void)
{
	uint8_t dial_bit=0;
	
	System_Dial_Switch = Gpio_Get_Dial_Switch();
	
	dial_bit = System_Dial_Switch & (MODEL_DIAL_SWITCH_NUMBER-1);
	
	if(dial_bit < MODEL_DIAL_SWITCH_NUMBER)
		return Product_Model_Ccode[dial_bit];
	else
		return PRODUCT_MODEL_CODE_SJ230;
}

// 每 %1 每秒 增加游泳距离 放大100倍
uint32_t Get_Every_1Percent_Distance_Per_Second(void)
{
	uint32_t code=0;
	
	code = Get_Model_Code_Num();

	if(PRODUCT_MODEL_CODE_SJ100 == code)
	{
		return SJ100_EVERY_1PERCENT_DISTANCE_PER_SECOND;
	}
	else if(PRODUCT_MODEL_CODE_SJ160 == code)
	{
		return SJ160_EVERY_1PERCENT_DISTANCE_PER_SECOND;
	}
	else if(PRODUCT_MODEL_CODE_SJ200 == code)
	{
		return SJ200_EVERY_1PERCENT_DISTANCE_PER_SECOND;
	}
	else
	{
		return SJ230_EVERY_1PERCENT_DISTANCE_PER_SECOND;
	}
}

//最大转速 100%
uint32_t Get_Motor_Rpm_Speed_Max(void)
{
	uint32_t code=0;
	
	code = Get_Model_Code_Num();

	if(PRODUCT_MODEL_CODE_SJ100 == code)
	{
		return SJ100_MOTOR_RPM_SPEED_MAX;
	}
	else if(PRODUCT_MODEL_CODE_SJ160 == code)
	{
		return SJ160_MOTOR_RPM_SPEED_MAX;
	}
	else if(PRODUCT_MODEL_CODE_SJ200 == code)
	{
		return SJ200_MOTOR_RPM_SPEED_MAX;
	}
	else
	{
		return SJ230_MOTOR_RPM_SPEED_MAX;
	}
}


//最低转速 20%
uint32_t Get_Motor_Rpm_Speed_Mix(void)
{
	uint32_t code=0;
	
	code = Get_Model_Code_Num();

	if(PRODUCT_MODEL_CODE_SJ100 == code)
	{
		return SJ100_MOTOR_RPM_SPEED_MIX;
	}
	else if(PRODUCT_MODEL_CODE_SJ160 == code)
	{
		return SJ160_MOTOR_RPM_SPEED_MIX;
	}
	else if(PRODUCT_MODEL_CODE_SJ200 == code)
	{
		return SJ200_MOTOR_RPM_SPEED_MIX;
	}
	else
	{
		return SJ230_MOTOR_RPM_SPEED_MIX;
	}
}

// 功率 降频
//*********************************************************************************************
//-------------- 电机功率 报警值  -------------------
uint32_t Get_Motor_Power_Alarm_Value(void)
{
	uint32_t code=0;
	
	code = Get_Model_Code_Num();

	if(PRODUCT_MODEL_CODE_SJ100 == code)
	{
		return SJ100_MOTOR_POWER_ALARM_VALUE;
	}
	else if(PRODUCT_MODEL_CODE_SJ160 == code)
	{
		return SJ160_MOTOR_POWER_ALARM_VALUE;
	}
	else if(PRODUCT_MODEL_CODE_SJ200 == code)
	{
		return SJ200_MOTOR_POWER_ALARM_VALUE;
	}
	else
	{
		return SJ230_MOTOR_POWER_ALARM_VALUE;
	}
}

//-------------- 电机功率 降速  -------------------
uint32_t Get_Motor_Power_Reduce_Speed(void)
{
	uint32_t code=0;
	
	code = Get_Model_Code_Num();

	if(PRODUCT_MODEL_CODE_SJ100 == code)
	{
		return SJ100_MOTOR_POWER_REDUCE_SPEED;
	}
	else if(PRODUCT_MODEL_CODE_SJ160 == code)
	{
		return SJ160_MOTOR_POWER_REDUCE_SPEED;
	}
	else if(PRODUCT_MODEL_CODE_SJ200 == code)
	{
		return SJ200_MOTOR_POWER_REDUCE_SPEED;
	}
	else
	{
		return SJ230_MOTOR_POWER_REDUCE_SPEED;
	}
}

//-------------- 电机功率 恢复  -------------------
uint32_t Get_Motor_Power_Restore_Speed(void)
{
	uint32_t code=0;
	
	code = Get_Model_Code_Num();

	if(PRODUCT_MODEL_CODE_SJ100 == code)
	{
		return SJ100_MOTOR_POWER_RESTORE_SPEED;
	}
	else if(PRODUCT_MODEL_CODE_SJ160 == code)
	{
		return SJ160_MOTOR_POWER_RESTORE_SPEED;
	}
	else if(PRODUCT_MODEL_CODE_SJ200 == code)
	{
		return SJ200_MOTOR_POWER_RESTORE_SPEED;
	}
	else
	{
		return SJ230_MOTOR_POWER_RESTORE_SPEED;
	}
}
//*********************************************************************************************

// 电流 降频
//*********************************************************************************************
//-------------- 输出电流 报警值  -------------------
uint32_t Get_Motor_Current_Alarm_Value(void)
{
	uint32_t code=0;
	
	code = Get_Model_Code_Num();

	if(PRODUCT_MODEL_CODE_SJ100 == code)
	{
		return SJ100_MOTOR_CURRENT_ALARM_VALUE;
	}
	else if(PRODUCT_MODEL_CODE_SJ160 == code)
	{
		return SJ160_MOTOR_CURRENT_ALARM_VALUE;
	}
	else if(PRODUCT_MODEL_CODE_SJ200 == code)
	{
		return SJ200_MOTOR_CURRENT_ALARM_VALUE;
	}
	else
	{
		return SJ230_MOTOR_CURRENT_ALARM_VALUE;
	}
}

//-------------- 输出电流 降速  -------------------
uint32_t Get_Motor_Current_Reduce_Speed(void)
{
	uint32_t code=0;
	
	code = Get_Model_Code_Num();

	if(PRODUCT_MODEL_CODE_SJ100 == code)
	{
		return SJ100_MOTOR_CURRENT_REDUCE_SPEED;
	}
	else if(PRODUCT_MODEL_CODE_SJ160 == code)
	{
		return SJ160_MOTOR_CURRENT_REDUCE_SPEED;
	}
	else if(PRODUCT_MODEL_CODE_SJ200 == code)
	{
		return SJ200_MOTOR_CURRENT_REDUCE_SPEED;
	}
	else
	{
		return SJ230_MOTOR_CURRENT_REDUCE_SPEED;
	}
}

//-------------- 输出电流 恢复  -------------------
uint32_t Get_Motor_Current_Restore_Speed(void)
{
	uint32_t code=0;
	
	code = Get_Model_Code_Num();

	if(PRODUCT_MODEL_CODE_SJ100 == code)
	{
		return SJ100_MOTOR_CURRENT_RESTORE_SPEED;
	}
	else if(PRODUCT_MODEL_CODE_SJ160 == code)
	{
		return SJ160_MOTOR_CURRENT_RESTORE_SPEED;
	}
	else if(PRODUCT_MODEL_CODE_SJ200 == code)
	{
		return SJ200_MOTOR_CURRENT_RESTORE_SPEED;
	}
	else
	{
		return SJ230_MOTOR_CURRENT_RESTORE_SPEED;
	}
}
//*********************************************************************************************










//---------------------------------------------------------------------------------------------------------------------------------------------------
