Marksman124/inverjet/(commit log)

2024-09-23 V1.1 改工程名，重新整理项目文档
    [0521逻辑定义问题点.xlsx, 1_18650INR2600-3C循环数据（3C循环）.xlsx, 1楼两台测试机.csv, 20240621-MM款 IH20B1A 样品测试申请单.xlsx, 20240905__逆流器测试报告.xlsx, 20240906__逆流器测试报告.xlsx, DataPoint.xlsx, VA-BT62613AMN-1.dwg]
2024-10-07 蓝牙协议 V1.1 老化、新驱动板 均加入宏定义模式；
    [逆流器显示板V1.4功能测试报告.xlsx, 逆流器显示板软件自测报告—V1.2.xlsx]
2024-10-07 添加蓝牙协议
2024-10-08 屏蔽中断接收
2024-10-11 V1.0.2
    1.添加训练计划dp点
    2.型号改为拨码开关选择；
    3.将型号相关参数宏定义单独移到《model_parameter.h》文件
2024-10-12 V1.0.2
    1.添加训练统计；
    2.添加DP点，匹配模组版本 3.xx.xx以上才能完整显示；
    3.解决暂停恢复有卡顿情况；（软启动遗留问题）
    [桌面单板.csv]
2024-10-14 V1.0.3 1.添加两位拨码， 2.优化ota升级；
2024-10-15 修改脚本
2024-10-18 boot 启动时间缩短
    [逆流器主控与驱动通讯V0.2(1).xls, 逆流器显示板软件自测报告—V1.2.xlsx]
2024-10-29 添加合并dp点 flash调整
    [DataPoint.xlsx, 桌面单板.csv]
2024-11-01 又改了一下Bootloader， 支持Bootloader OTA；
2024-11-18 v1.1.1
    1.添加缺相、堵转
    2.故障码转换调整
    3.温度报警值调整
    [1楼两台测试机.csv]
2024-11-19 故障恢复后，转速异常
2024-11-25 常规更新
2024-11-28 1.1.5
    修改：app开机出现 屏幕显示20%运行中，电机却没开的情况
2024-12-09 v1.1.6 添加工装
2024-12-18 485协议更新 添加蓝牙测试，宏开启 电机开启不允许升级
2024-12-23 v1.1.9 降转速 故障恢复-->12秒 严重故障直接锁死
2024-12-24 V1.1.9
    1.测试工装初步稳定，等小批验证；
    2.增加2个调试用的dp点；
    3.增加线程：BT 蓝牙；
    4.ota升级初步测试稳定，等大批量测试验证成功率；
2025-01-02 V1.2.1 发货前测试，稳定版 功能基本齐全
    [DataPoint.xlsx]
2025-01-03 长按刷新太快，加10倍延时
2025-01-06 v1.2.2
    1.故障时关机会多算一次故障次数；
    2.长按连续设置时添加延时，110ms步进1；
2025-01-07 v1.2.2 bug修改
2025-01-09 v1.2.3 优化led光圈，非线性曲线 优化所有通讯中断； 优化timing 时钟；
2025-01-14 vv1.2.4 发货版
    1.添加校时
    2.led光圈非线性调光
    3.4个串口压力测试
    5.flash —— 1分钟保存1次
2025-01-17 v1.3.0 发货版本
2025-01-20 v1.3.0 发货受控
2025-01-24 v1.3.1 === 放假前留档
2025-02-25 v1.3.5 更新降频算法 添加驱动板测试模式 添加蓝工驱动板启动判断
2025-02-28 V1.3.5 合并驱动板版本
2025-02-28 温度上传负数
2025-03-04 1.3.6
    合并驱动板
2025-03-07 v1.3.7 更改故障
2025-03-07 上传受控版本
    [3.48.00_WiFi连接测试报告.xlsx, 3系列模组WiFi连接结果.xlsx, 冲浪器测试报告20250114.xlsx, 逆流器 测试报告20241230.xlsx, 逆流器显示板软件自测报告—V1.2.3.xlsx, 逆流器显示板软件自测报告—V1.2.xlsx]
2025-03-17 V1.3.9 蓝牙配对更改
2025-03-19 V1.3.10 1.完善蓝牙配对 2.添加电机轻载故障
